jFoster426/ElectronicLoad/Simulation/BQ25303 Thermistor Resistor Calculations.docx

BQ25303 Thermistor Resistor Calculations:

T=1/(1/(T_0)+1/βln(R/(R_0)))

T_0 =298.15 °C

β=3380 K

R_0 =10 kΩ

1/T=1/(T_0)+1/βln(R/(R_0))

β(1/T-1/(T_0))=ln(R/(R_0))

R=R_0 exp(β(1/T-1/(T_0)))

Calculate resistance at T_1 and T_5 ( 0 °C and 60 °C , 273.15 °K and 333.15 °K ):

R_(NTC,T1) =10000exp(3380(1/273.15-1/298.15))

R_(NTC,T1) =28.223 kΩ

R_(NTC,T5) =10000exp(3380(1/333.15-1/298.15))

R_(NTC,T5) =3.0392 kΩ

Calculate values for R_(T1) and R_(T2) :

R_(T2) =(R_(NTC,T1) ×R_(NTC,T5) ×(1/(V_(T5) %)-1/(V_(T1) %)))/(R_(NTC,T1) ×(1/(V_(T1) %)-1)-R_(NTC,T5) ×(1/(V_(T5) %)-1))

V_(T1) %=73.5 %

V_(T5) %=37.75 %

R_(T2) =(3.0392×28.223×(1/37.75-1/73.5))/(28.223×(1/73.5-1)-3.0392(1/37.75-1))

R_(T2) =21.401 kΩ

R_(T1) =(1/(V_(T1) %)-1)/(1/(R_(T2))+1/(R_(NTC,T1)))

R_(T1) =(1/0.735-1)/(1/21401+1/28223)

R_(T1) =4.3884 kΩ

The actual values chosen are:

R_(T1) =4.42 kΩ

R_(T2) =21.5 kΩ

TODO: Calculate T1 and T5 based on actual values.
