jFoster426/ElectronicLoad/Main PCB/Project Outputs for Electronic Load/BOM/BOM-Electronic Load.xlsx

Comment | Designator | Footprint | Quantity | Fitted | Manufacturer 1 | Manufacturer 1 Part Number
10uF,20%,50V,X5R,1206 | C2, C55, C56, C57, C60, C63, C66, C67, C68, C69, C70, C72, C73, C74, C77 | CAPC3216X16N | 15 | Fitted | Samsung Electro-Mechanics | CL31A106MBHNNNE | LCSC
100nF,10%,50V,X7R,0402 | C7, C8, C9, C10, C15_ICC1, C15_ICC2, C15_ICC3, C15_ICC4, C15_ICC5, C15_ICC6, C15_ICC7, C15_ICC8, C16_ICC1, C16_ICC2, C16_ICC3, C16_ICC4, C16_ICC5, C16_ICC6, C16_ICC7, C16_ICC8, C19_PT1, C19_PT2, C19_PT3, C19_PT4, C19_PT5, C19_PT6, C19_PT7, C19_PT8, C20_PT1, C20_PT2, C20_PT3, C20_PT4, C20_PT5, C20_PT6, C20_PT7, C20_PT8, C39, C49, C50, C79, C80, C81, C82, C83 | CAPC1005X06N | 44 | Fitted | Murata | GRM155R71H104KE14D | Parts Bin
10nF,10%,25V,X7R,0402 | C14_ICC1, C14_ICC2, C14_ICC3, C14_ICC4, C14_ICC5, C14_ICC6, C14_ICC7, C14_ICC8, C17_ICC1, C17_ICC2, C17_ICC3, C17_ICC4, C17_ICC5, C17_ICC6, C17_ICC7, C17_ICC8, C59 | CAPC1005X06N | 17 | Fitted | Murata Electronics | GCM155R71E103KA37D | Kardium
1uF,10%,35V,X7R,0402 | C21, C22, C23, C24, C26, C27, C28, C29, C30, C31, C32, C33, C34, C53, C58, C61, C62, C64, C71, C76 | CAPC1005X06N | 20 | Fitted | TDK Corporation | C1005X5R1V105K050BC
5.1pF,+-0.1pF,50V,C0G,0402 | C35, C36 | CAPC1005X06N | 2 | Fitted | Murata | GJM1555C1H5R1BB01D
6.8pF,+-0.1pF,50V,C0G,0402 | C37, C38 | CAPC1005X06N | 2 | Fitted | Murata | GJM1555C1H6R8BB01D
47nF,10%,50V,X7R,0402 | C65 | CAPC1005X06N | 1 | Fitted | YAGEO | CC0402KRX7R9BB473
PMEG6002EB-QX | D1, D2, D14, D15, D16, D17 | NEXPERIA_PKG_SOD523 | 6 | Fitted | Nexperia USA Inc. | PMEG6002EB-QX
1N4148WT | D3, D12, D30, D31 | ONSEMI_PKG_SOD-523F | 4 | Fitted | onsemi | 1N4148WT
Red | D4, D29 | LITE-ON_LTST-C190KRKT | 2 | Fitted | Lite-On Inc. | LTST-C190KRKT
Yellow | D5 | LITE-ON_LTST-C190KSKT | 1 | Fitted | Lite-On Inc. | LTST-C190KSKT
Green | D6 | LITE-ON_LTST-C190KGKT | 1 | Fitted | Lite-On Inc. | LTST-C190KGKT
BAT54SLT1G | D7, D8, D11_C1, D11_C2, D11_C3, D11_C4, D11_C5, D11_C6, D11_C7, D11_C8, D11_C9, D11_C10 | SOT95P240X120-3N | 12 | Fitted | onsemi | BAT54SLT1G
PMEG2010AEBF | D13 | NEXPERIA_PKG_SOD523 | 1 | Fitted | Nexperia USA Inc. | PMEG2010AEBF
ESDSLC5V0LB-TP | D18, D19 | MICROCOMMERCIAL_DFN1006-2_NPOL | 2 | Fitted | Micro Commercial Co | ESDSLC5V0LB-TP
ESDSLC3V3LB-TP | D20, D21, D22, D23, D24, D25, D26, D27, D28 | DFN65P100X50-2N | 9 | Fitted | Micro Commercial Co | ESDSLC3V3LB-TP
600R,0603 | FB1, FB2, FB3, FB4, FB5 | INDC_0603 | 5 | Fitted | TAI-TECH | FCM1608KF-601T03
TT56145145-1520 | J1, J2 | XFCN_TT56145145-1520 | 2 | Fitted | XFCN | TT56145145-1520
S2B-XH-A | J3 | JST_S2B-XH-A | 1 | Fitted | JST Sales America Inc. | S2B-XH-A
USB4110-GF-A | J4 | GCT_USB4110-GF-A | 1 | Fitted | GCT | USB4110-GF-A
3221-10-0300-00 | J5 | CNC Tech_3221-10-0300-00 | 1 | Fitted | CNC Tech | 3221-10-0300-00
Term,Header,6 Pin,Top,2.54mm | J6 | WURTH_61300611121 | 1 | Fitted | WÃ¼rth Elektronik | 61300611121
Term,Header,2 Pin,Top,2.54mm | J7 | WURTH_61300211121 | 1 | Fitted | WÃ¼rth Elektronik | 61300211121
PPPC082LFBN-RC | J8 | SULLINS_PPPC082LFBN-RC | 1 | Fitted | Sullins Connector Solutions | PPPC082LFBN-RC
4.7uH,4A,Wirewound,SMD | L1 | TAIYO-YUDEN_NRS8030T4R7MJGJ | 1 | Fitted | Taiyo Yuden | NRS8030T4R7MJGJ
1uH,30%,6A,Wirewound,SMD | L2 | TDK_VLS6045EX | 1 | Fitted | TDK | VLS6045EX-1R0N
DMP3099L-7 | Q1, Q2 | DIODES_SOT23 | 2 | Fitted | Diodes Incorporated | DMP3099L-7
GBS65041TOB | Q4_PT1, Q4_PT2, Q4_PT3, Q4_PT4, Q4_PT5, Q4_PT6, Q4_PT7, Q4_PT8 | GOSEMICON_PKG_TO-247 | 8 | Fitted | GOSEMICON | GBS65041TOB
MMBT2222AT-7-F | Q5, Q6, Q7, Q9, Q11 | SOTFL50P160X90-3N | 5 | Fitted | Diodes Incorporated | MMBT2222AT-7-F
MMBT4403T-7-F | Q8 | DIODES_SOT523 | 1 | Fitted | Diodes Incorporated | MMBT4403T-7-F
FDY102PZ | Q10 | ONSEMI_SC-89 | 1 | Fitted | onsemi | FDY102PZ
0R0,0402 | R1_ICC1, R1_ICC2, R1_ICC3, R1_ICC4, R1_ICC5, R1_ICC6, R1_ICC7, R1_ICC8, R84, R113, R116, R122, R172, R182 | RESC1005X04N | 14 | Fitted | Panasonic Electronic Components | ERJ-2GE0R00X
1k,0.1%,0.063W,0402 | R3_ICC1, R3_ICC2, R3_ICC3, R3_ICC4, R3_ICC5, R3_ICC6, R3_ICC7, R3_ICC8, R4_ICC1, R4_ICC2, R4_ICC3, R4_ICC4, R4_ICC5, R4_ICC6, R4_ICC7, R4_ICC8, R7_ICC1, R7_ICC2, R7_ICC3, R7_ICC4, R7_ICC5, R7_ICC6, R7_ICC7, R7_ICC8, R8_ICC1, R8_ICC2, R8_ICC3, R8_ICC4, R8_ICC5, R8_ICC6, R8_ICC7, R8_ICC8, R11, R13, R14, R15, R17, R20, R26_ICC1, R26_ICC2, R26_ICC3, R26_ICC4, R26_ICC5, R26_ICC6, R26_ICC7, R26_ICC8, R27_ICC1, R27_ICC2, R27_ICC3, R27_ICC4, R27_ICC5, R27_ICC6, R27_ICC7, R27_ICC8, R28_ICC1, R28_ICC2, R28_ICC3, R28_ICC4, R28_ICC5, R28_ICC6, R28_ICC7, R28_ICC8, R29_ICC1, R29_ICC2, R29_ICC3, R29_ICC4, R29_ICC5, R29_ICC6, R29_ICC7, R29_ICC8, R31_ICC1, R31_ICC2, R31_ICC3, R31_ICC4, R31_ICC5, R31_ICC6, R31_ICC7, R31_ICC8, R32_ICC1, R32_ICC2, R32_ICC3, R32_ICC4, R32_ICC5, R32_ICC6, R32_ICC7, R32_ICC8, R35_ICC1, R35_ICC2, R35_ICC3, R35_ICC4, R35_ICC5, R35_ICC6, R35_ICC7, R35_ICC8, R36_ICC1, R36_ICC2, R36_ICC3, R36_ICC4, R36_ICC5, R36_ICC6, R36_ICC7, R36_ICC8, R103 | RESC1005X04N | 103 | Fitted | YAGEO | RT0402BRE071KL
0R02,1%,0.33W,1206 | R5_CS1, R5_CS2, R5_CS3, R5_CS4, R5_CS5, R5_CS6, R5_CS7, R5_CS8, R6_CS1, R6_CS2, R6_CS3, R6_CS4, R6_CS5, R6_CS6, R6_CS7, R6_CS8, R64_CS1, R64_CS2, R64_CS3, R64_CS4, R64_CS5, R64_CS6, R64_CS7, R64_CS8, R67_CS1, R67_CS2, R67_CS3, R67_CS4, R67_CS5, R67_CS6, R67_CS7, R67_CS8, R70_CS1, R70_CS2, R70_CS3, R70_CS4, R70_CS5, R70_CS6, R70_CS7, R70_CS8, R73_CS1, R73_CS2, R73_CS3, R73_CS4, R73_CS5, R73_CS6, R73_CS7, R73_CS8 | RESC3216X06N | 48 | Fitted | UNI-ROYAL | 1206W3F200MT5E
100k,1%,0.063W,0402 | R9, R117, R176, R178, R179, R181 | RESC1005X04N | 6 | Fitted | YAGEO | RC0402FR-07100KL
10k,0.1%,0.063W,0402 | R10, R12, R101 | RESC1005X04N | 3 | Fitted | Stackpole Electronics Inc | RNCF0402BTE10K0
10R,1%,0.063W,0402 | R18_PT1, R18_PT2, R18_PT3, R18_PT4, R18_PT5, R18_PT6, R18_PT7, R18_PT8, R95, R164, R168, R169, R170, R171, R173, R174, R175 | RESC1005X04N | 17 | Fitted | Panasonic Electronic Components | ERJ-2RKF10R0X
6k81,0.1%,0.063W,0402 | R19, R25_ICC1, R25_ICC2, R25_ICC3, R25_ICC4, R25_ICC5, R25_ICC6, R25_ICC7, R25_ICC8, R34_ICC1, R34_ICC2, R34_ICC3, R34_ICC4, R34_ICC5, R34_ICC6, R34_ICC7, R34_ICC8 | RESC1005X04N | 17 | Fitted | YAGEO | AT0402BRD076K81L
10k,5%,0.063W,0402 | R30_ICC1, R30_ICC2, R30_ICC3, R30_ICC4, R30_ICC5, R30_ICC6, R30_ICC7, R30_ICC8, R33_ICC1, R33_ICC2, R33_ICC3, R33_ICC4, R33_ICC5, R33_ICC6, R33_ICC7, R33_ICC8, R82_PT1, R82_PT2, R82_PT3, R82_PT4, R82_PT5, R82_PT6, R82_PT7, R82_PT8, R88, R89, R90, R91, R92, R93, R94, R119, R120, R121, R153, R154, R155, R156, R157, R158, R159, R160, R161, R162, R163, R165, R166, R167, R183, R184 | RESC1005X04N | 50 | Fitted | Stackpole Electronics Inc | RMCF0402JT10K0
0R0,1206 | R81_PT1, R81_PT2, R81_PT3, R81_PT4, R81_PT5, R81_PT6, R81_PT7, R81_PT8 | RESC3216X06N | 8 | Fitted | Stackpole Electronics Inc | RMCF1206ZT0R00
1k,5%,0.063W,0402 | R83_PT1, R83_PT2, R83_PT3, R83_PT4, R83_PT5, R83_PT6, R83_PT7, R83_PT8, R111_C1, R111_C2, R111_C3, R111_C4, R111_C5, R111_C6, R111_C7, R111_C8, R111_C9, R111_C10, R128 | RESC1005X04N | 19 | Fitted | Stackpole Electronics Inc | RMCF0402JT1K00
750R,1%,0.063W,0402 | R85 | RESC1005X04N | 1 | Fitted | UNI-ROYAL | 0402WGF7500TCE
300R,1%,0.063W,0402 | R86 | RESC1005X04N | 1 | Fitted | UNI-ROYAL | 0402WGF3000TCE
270R,1%,0.063W,0402 | R87 | RESC1005X04N | 1 | Fitted | YAGEO | RC0402FR-07270RL
442k,0.1%,0.125W,0805 | R96, R97, R98, R99, R100 | RESC2012X07N | 5 | Fitted | Panasonic Electronic Components | ERA-6AEB4423V
49R9,1%,0.063W,0402 | R112_C1, R112_C2, R112_C3, R112_C4, R112_C5, R112_C6, R112_C7, R112_C8, R112_C9, R112_C10, R131, R133, R134, R135, R137, R139, R141, R143, R145, R147, R149, R151 | RESC1005X04N | 22 | Fitted | YAGEO | RC0402FR-0749R9L
4k42,1%,0.063W,0402 | R114 | RESC1005X04N | 1 | Fitted | FOJAN | FRC0402F4421TS
13k2,1%,0.063W,0402 | R115 | RESC1005X04N | 1 | Fitted | KOA Speer Electronics, Inc. | RN73H1ETTP1322F25
21k5,1%,0.063W,0402 | R118 | RESC1005X04N | 1 | Fitted | FOJAN | FRC0402F2152TS
1k62,1%,0.063W,0402 | R123 | RESC1005X04N | 1 | Fitted | YAGEO | RC0402FR-071K62L
NTC,10k,3380K,0603 | R124 | RESC_0603 | 1 | Fitted | Murata | NCP18XH103F03RB
330R,1%,0.063W,0402 | R125, R127 | RESC1005X04N | 2 | Fitted | YAGEO | RC0402FR-07330RL
3k6,1%,0.063W,0402 | R126 | RESC1005X04N | 1 | Fitted | FOJAN | FRC0402F3601TS
5k11,1%,0.063W,0402 | R129, R130 | RESC1005X04N | 2 | Fitted | Yageo | AC0402FR-075K11L
100R,1%,0.25W,1206 | R132, R185 | SEI_PKG_RMCF1206 | 2 | Fitted | Stackpole Electronics Inc | RMCF1206FT100R
10k,25T | R136 | BOURNS_3296W | 1 | Fitted | Bourns | 3296W-1-103LF
750k,1%,0.063W,0402 | R177 | RESC1005X04N | 1 | Fitted | YAGEO | RC0402FR-07750KL
PTS525SM15SMTR2 LFS | SW1, SW11 | C&K_PTS525SM15SMTR2 LFS | 2 | Fitted | C&K | PTS525SM15SMTR2 LFS
1825027-6 | SW2 | TE_1825027-6 | 1 | Fitted | TE Connectivity | 1825027-6
PTS645SK43SMTR92 LFS | SW3, SW4, SW5, SW6, SW7, SW8, SW9, SW10 | C&K_PTS645SK43SMTR92 LFS | 8 | Fitted | C&K | PTS645SK43SMTR92 LFS
750317722 | T1 | WURTH_750317722 | 1 | Fitted | Wurth Elektronik | 750317722
LM317EMPX/NOPB | U1 | TEXASINSTRUMENTS_PKG_DCY | 1 | Fitted | Texas Instruments | LM317EMPX/NOPB
LM337IMPX/NOPB | U2 | TEXASINSTRUMENTS_PKG_DCY | 1 | Fitted | Texas Instruments | LM337IMPX/NOPB
OPA2209AIDR | U3_ICC1, U3_ICC2, U3_ICC3, U3_ICC4, U3_ICC5, U3_ICC6, U3_ICC7, U3_ICC8, U8, U9 | TEXASINSTRUMENTS_PKG_D0008A | 10 | Fitted | Texas Instruments | OPA2209AIDR
MCP9701-E/TO | U4_PT1, U4_PT2, U4_PT3, U4_PT4, U4_PT5, U4_PT6, U4_PT7, U4_PT8 | TO-92 | 8 | Fitted | Microchip Technology | MCP9701-E/TO
DAC8830ID | U5 | TEXASINSTRUMENTS_PKG_D0008A | 1 | Fitted | Texas Instruments | DAC8830ID
REF3030AIDBZR | U6 | SOT95P237X112-3N | 1 | Fitted | Texas Instruments | REF3030AIDBZR
STM32G474VET6 | U7 | STMICROELECTRONICS_PKG_LQFP100 | 1 | Fitted | ST Microelectronics | STM32G474VET6
BQ25303JRTER | U10 | TEXASINSTRUMENTS_PKG_RTE0016C | 1 | Fitted | Texas Instruments | BQ25303JRTER
TPS79333DBVR | U11 | TEXASINSTRUMENTS_PKG_DBV0005A | 1 | Fitted | Texas Instruments | TPS79333DBVR
PAM2401SCADJ | U12 | DIODES_PKG_MSOP-8 | 1 | Fitted | Diodes Incorporated | PAM2401SCADJ
SN6505BDBVR | U14 | TEXASINSTRUMENTS_PKG_DBV0006A | 1 | Fitted | Texas Instruments | SN6505BDBVR
TPD4E05U06DQAR | U16 | TEXASINSTRUMENTS_PKG_DQA0009A | 1 | Fitted | Texas Instruments | TPD4E05U06DQAR
TXU0104PWR | U18 | SOP65P640X120-14N | 1 | Fitted | Texas Instruments | TXU0104PWR
TXB0108PWR | U19 | TEXASINSTRUMENTS_PKG_PW0020A | 1 | Fitted | Texas Instruments | TXB0108PWR
24MHz,8pF | Y1 | NDK_NX2016SA | 1 | Fitted | NDK | NX2016SA-24MHZ-STD-CZS-2
32.768kHz,12.5pF | Y2 | EPSON_FC-135 | 1 | Fitted | EPSON | Q13FC13500004
