jFoster426/ElectronicLoad/Mechanical/Bracket.SLDPRT

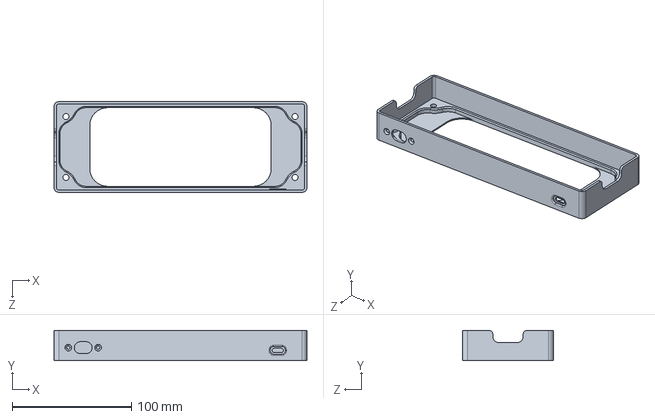
[picture p1: CAD file, 2026-03-18]
Mechanical/Bracket.SLDPRT
212.0 x 25.2 x 76.0 mm
