jFoster426/ElectronicLoad/Mechanical/JLCMC/EDLW-S1-M2.5-L6.sldprt

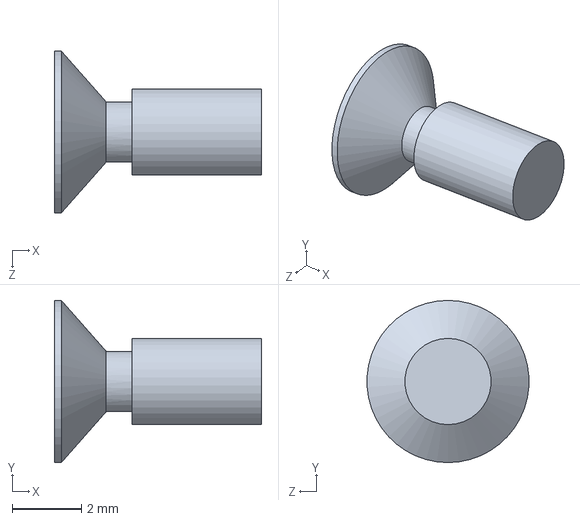
[picture p2: CAD file, 2026-03-04]
Mechanical/JLCMC/EDLW-S1-M2.5-L6.sldprt
6.00 x 4.70 x 4.69 mm
