jFoster426/ElectronicLoad/Mechanical/PCB/LCD PCB.SLDPRT

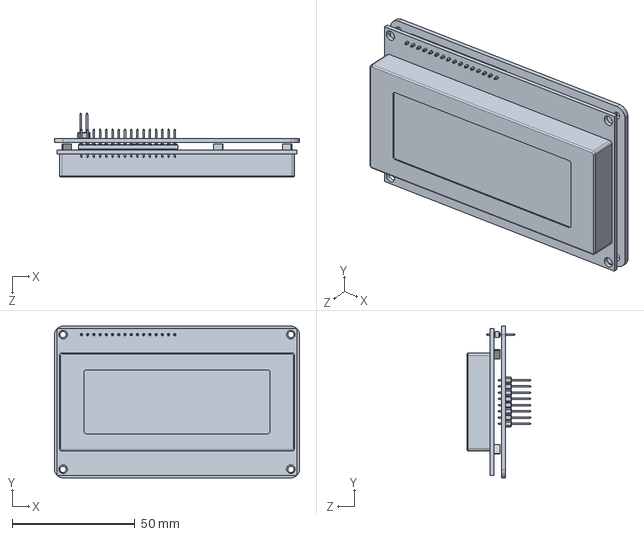
[picture p3: CAD file, 2026-02-09]
Mechanical/PCB/LCD PCB.SLDPRT
100.0 x 62.0 x 26.2 mm
