jFoster426/ElectronicLoad/Mechanical/JLCMC/EDLW-S1-M2.5-L12.sldprt

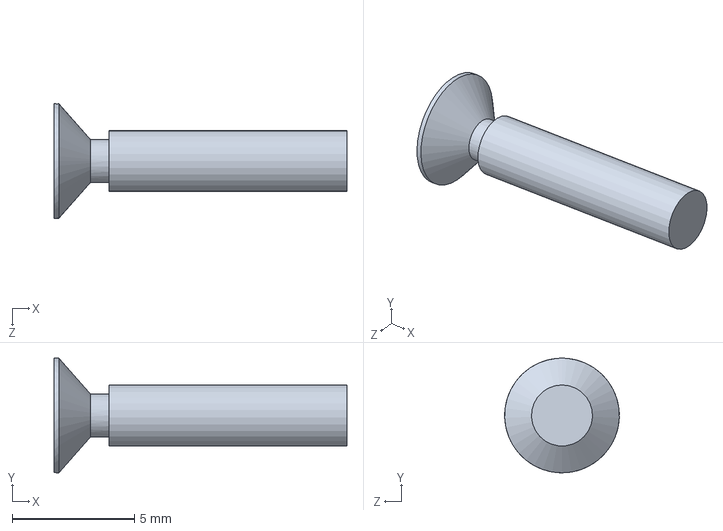
[picture p4: CAD file, 2026-03-04]
Mechanical/JLCMC/EDLW-S1-M2.5-L12.sldprt
12.0 x 4.70 x 4.70 mm
