jFoster426/ElectronicLoad/Mechanical/Top Cover.SLDPRT

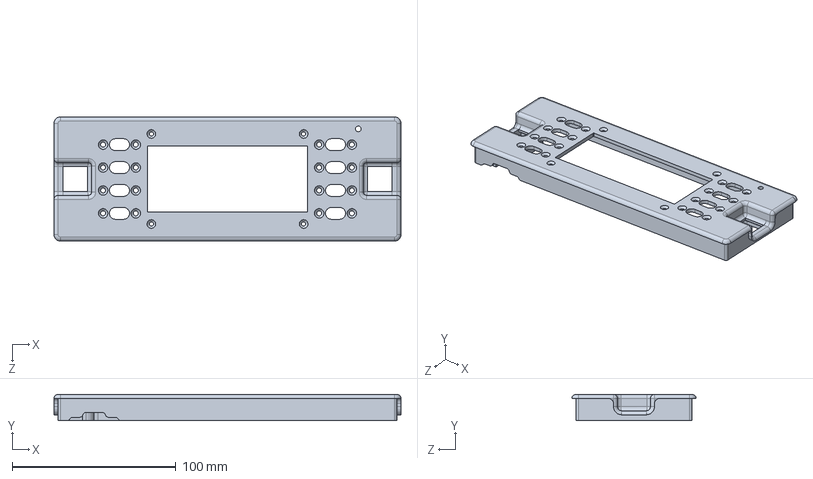
[picture p5: CAD file, 2026-03-18]
Mechanical/Top Cover.SLDPRT
212.0 x 16.0 x 76.0 mm
