jFoster426/ElectronicLoad/Mechanical/JLCMC/ECSA-P51-M3-L16.sldprt

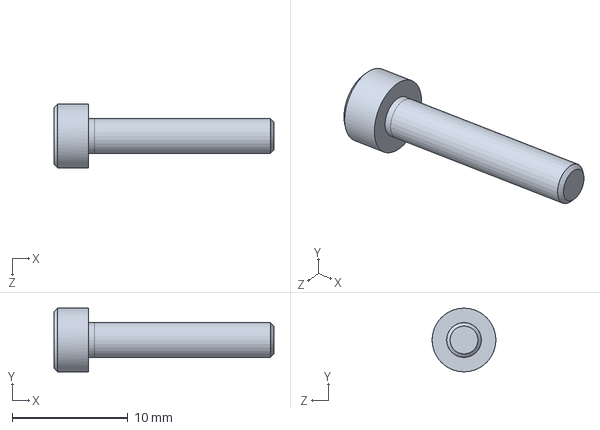
[picture p6: CAD file, 2026-03-04]
Mechanical/JLCMC/ECSA-P51-M3-L16.sldprt
19.0 x 5.50 x 5.50 mm
