jFoster426/ElectronicLoad/Mechanical/LCD Spacer.SLDPRT

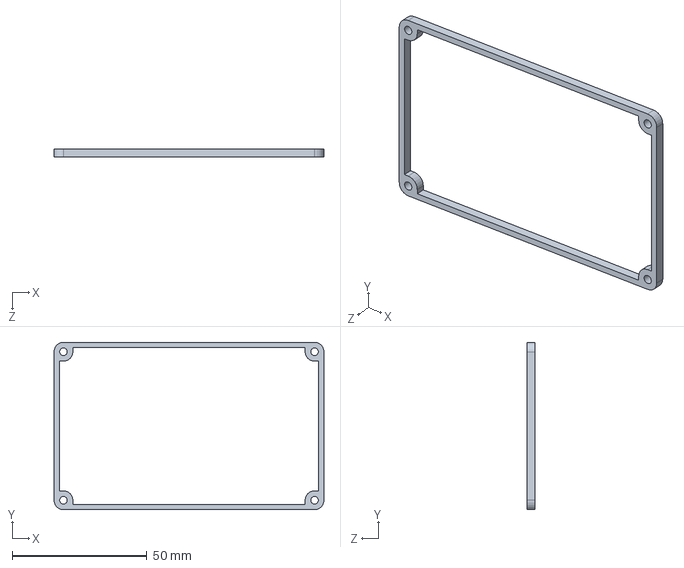
[picture p7: CAD file, 2026-03-04]
Mechanical/LCD Spacer.SLDPRT
100.0 x 62.0 x 3.00 mm
