jFoster426/ElectronicLoad/Mechanical/Insulator 2.SLDPRT

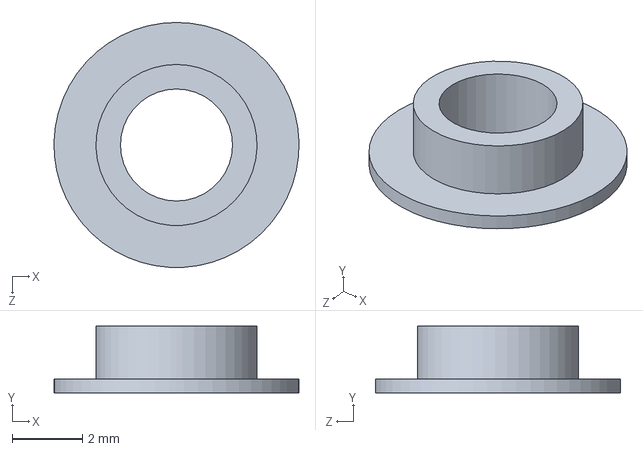
[picture p8: CAD file, 2026-03-04]
Mechanical/Insulator 2.SLDPRT
7.00 x 1.90 x 7.00 mm
