jFoster426/ElectronicLoad/Mechanical/JLCMC/EMLA-S1W-B1L1-M2.5.sldprt

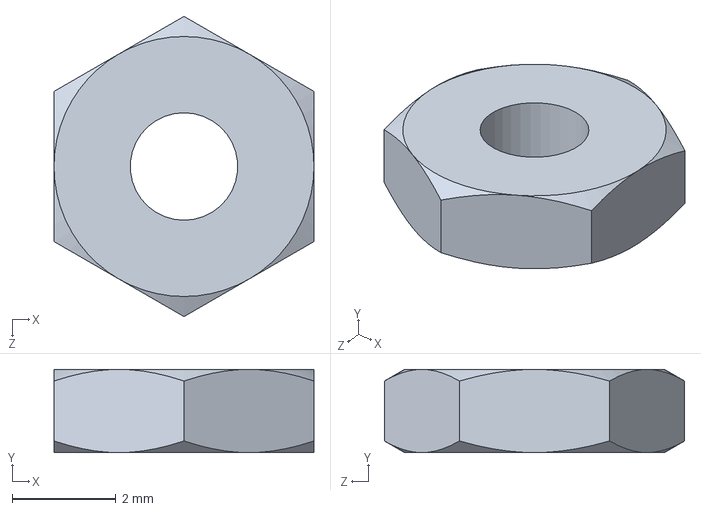
[picture p9: CAD file, 2026-03-04]
Mechanical/JLCMC/EMLA-S1W-B1L1-M2.5.sldprt
5.00 x 1.60 x 5.77 mm
