jFoster426/ElectronicLoad/Mechanical/JLCMC/ECSA-P51-M3-L20.sldprt

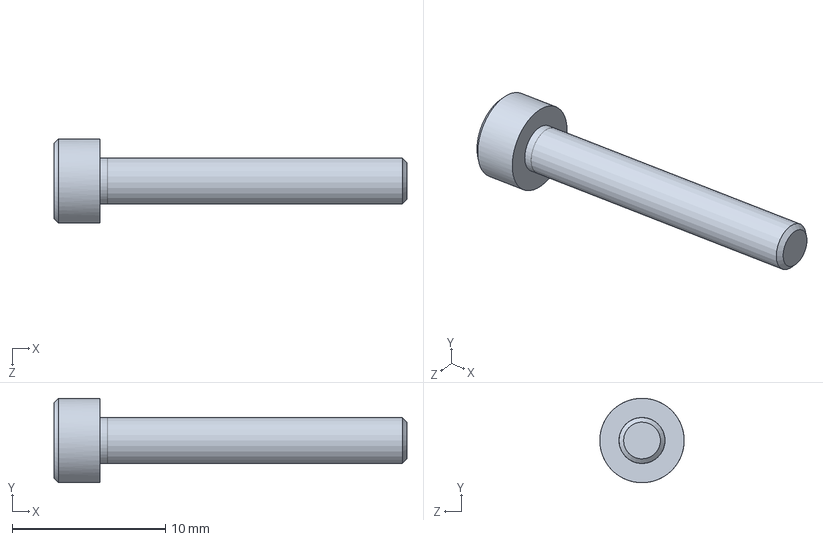
[picture p10: CAD file, 2026-03-04]
Mechanical/JLCMC/ECSA-P51-M3-L20.sldprt
23.0 x 5.50 x 5.50 mm
