jFoster426/ElectronicLoad/Mechanical/Transistor Clamp.SLDPRT

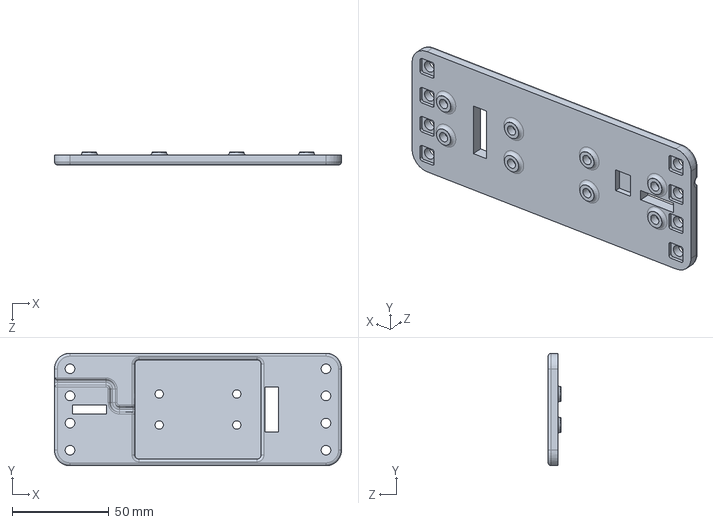
[picture p11: CAD file, 2026-03-04]
Mechanical/Transistor Clamp.SLDPRT
148.0 x 58.0 x 6.60 mm
