jFoster426/ElectronicLoad/Mechanical/Insulator.SLDPRT

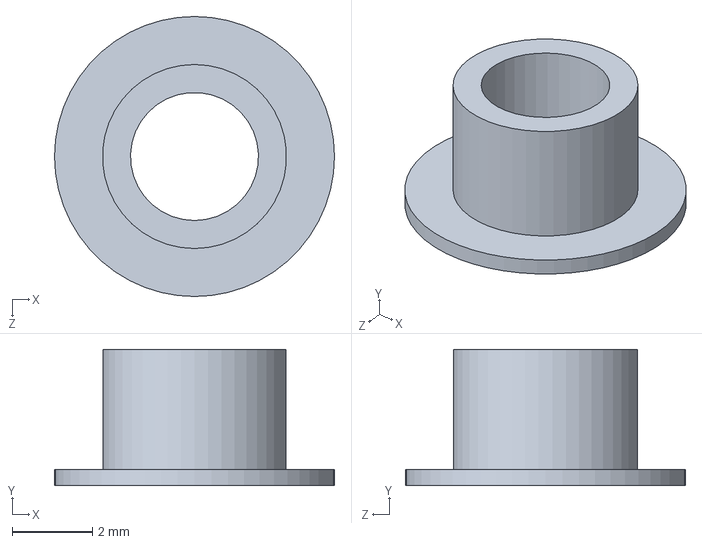
[picture p12: CAD file, 2026-03-02]
Mechanical/Insulator.SLDPRT
7.00 x 3.40 x 7.00 mm
