jFoster426/ElectronicLoad/Mechanical/Buttons.SLDPRT

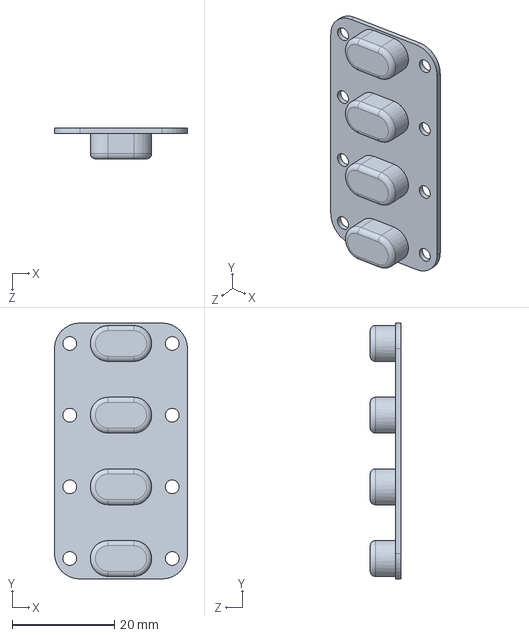
[picture p13: CAD file, 2026-03-02]
Mechanical/Buttons.SLDPRT
26.0 x 50.0 x 6.00 mm
