jFoster426/ElectronicLoad/Mechanical/Heatsink.SLDPRT

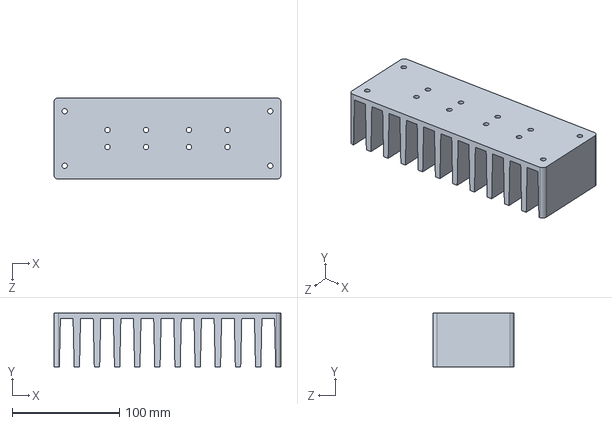
[picture p14: CAD file, 2026-02-09]
Mechanical/Heatsink.SLDPRT
212.0 x 50.0 x 76.0 mm
