jFoster426/ElectronicLoad/Mechanical/Button Spacer.SLDPRT

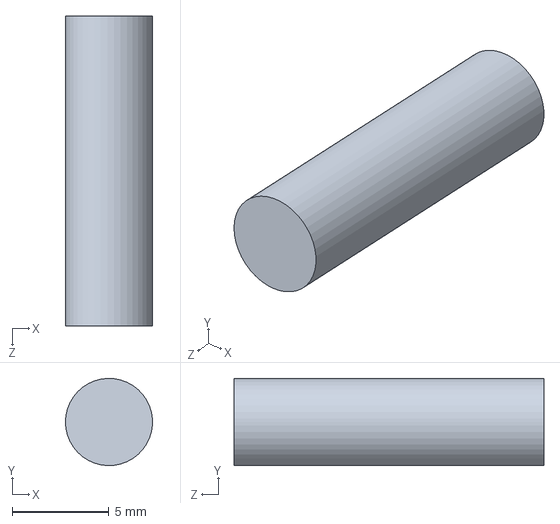
[picture p15: CAD file, 2026-02-09]
Mechanical/Button Spacer.SLDPRT
4.50 x 4.50 x 16.0 mm
