jFoster426/ElectronicLoad/Mechanical/LIPO785060.SLDPRT

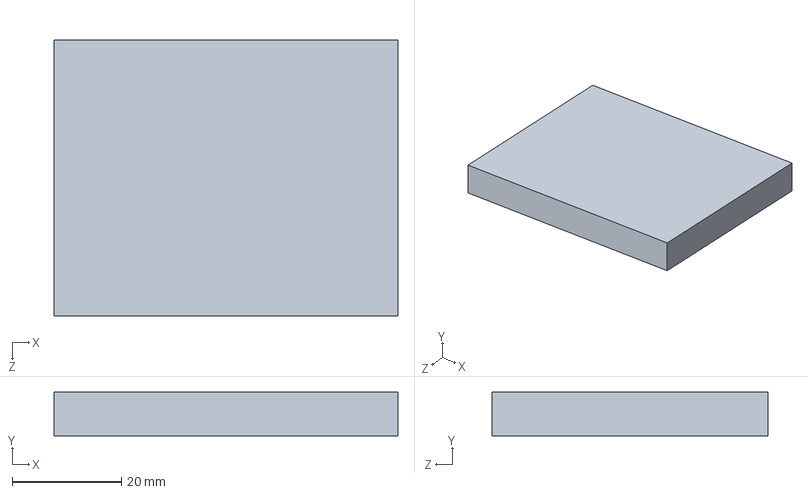
[picture p16: CAD file, 2026-02-07]
Mechanical/LIPO785060.SLDPRT
63.0 x 8.00 x 50.5 mm
