jFoster426/ElectronicLoad/Mechanical/Power Button.SLDPRT

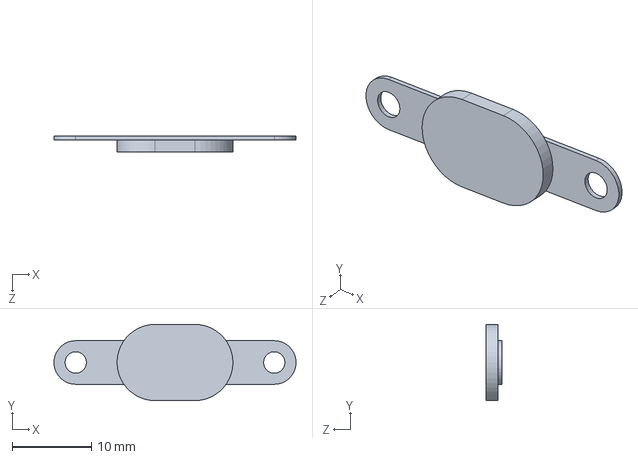
[picture p17: CAD file, 2026-02-07]
Mechanical/Power Button.SLDPRT
30.5 x 9.60 x 2.00 mm
