jFoster426/ElectronicLoad/(list of files, cad)

Other CAD files:
Mechanical/PCB/LCD PCB.x_t
