jFoster426/ElectronicLoad/Main PCB/Electronic Load.pdf

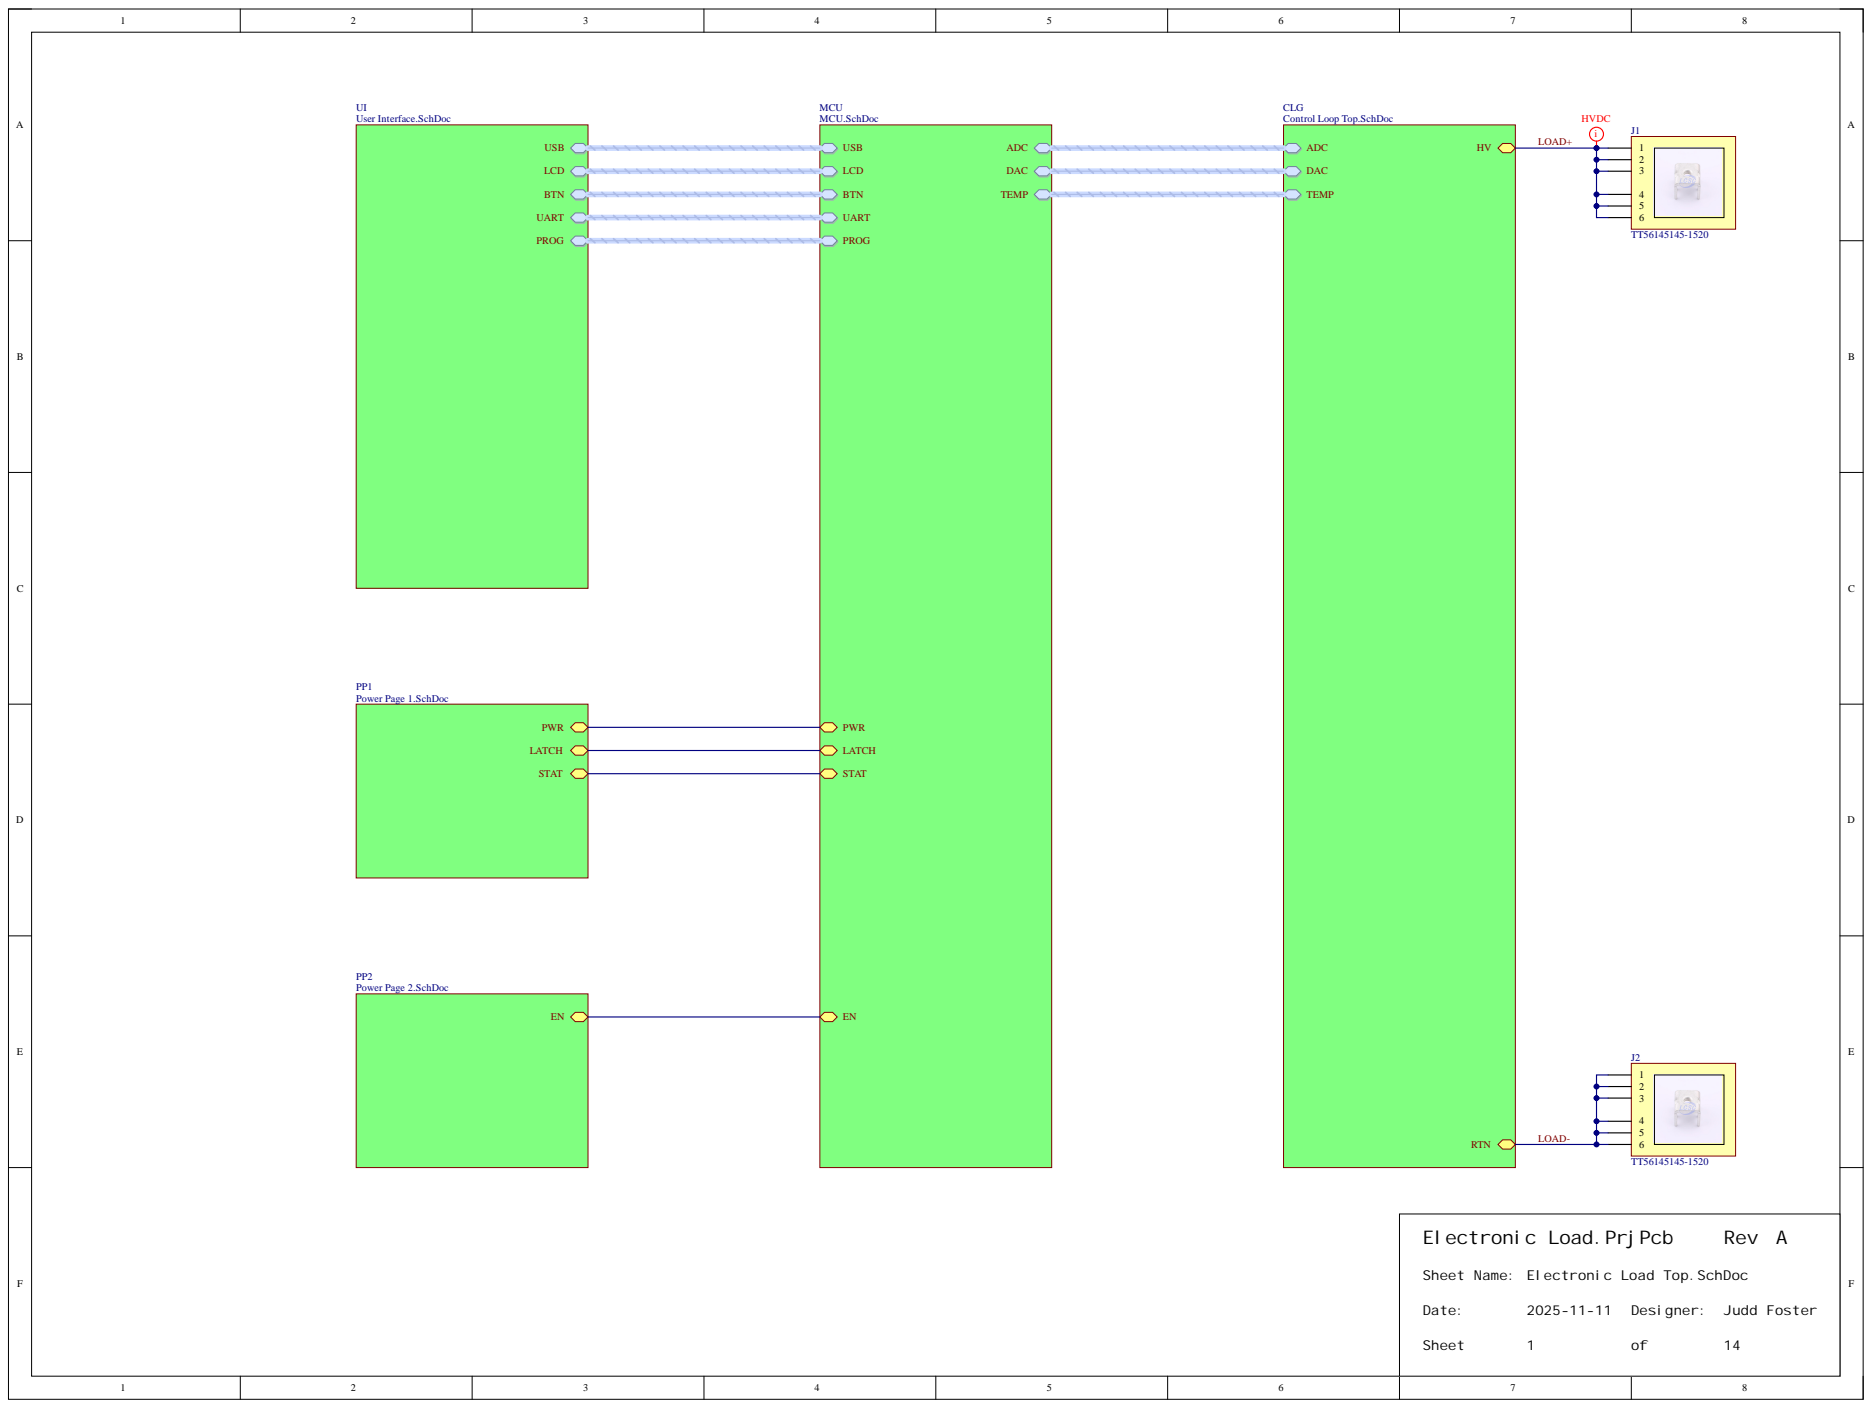
[picture p18: page 1]

CLG
Control Loop Top.SchDoc

Sheet Name: Electronic Load Top.SchDoc

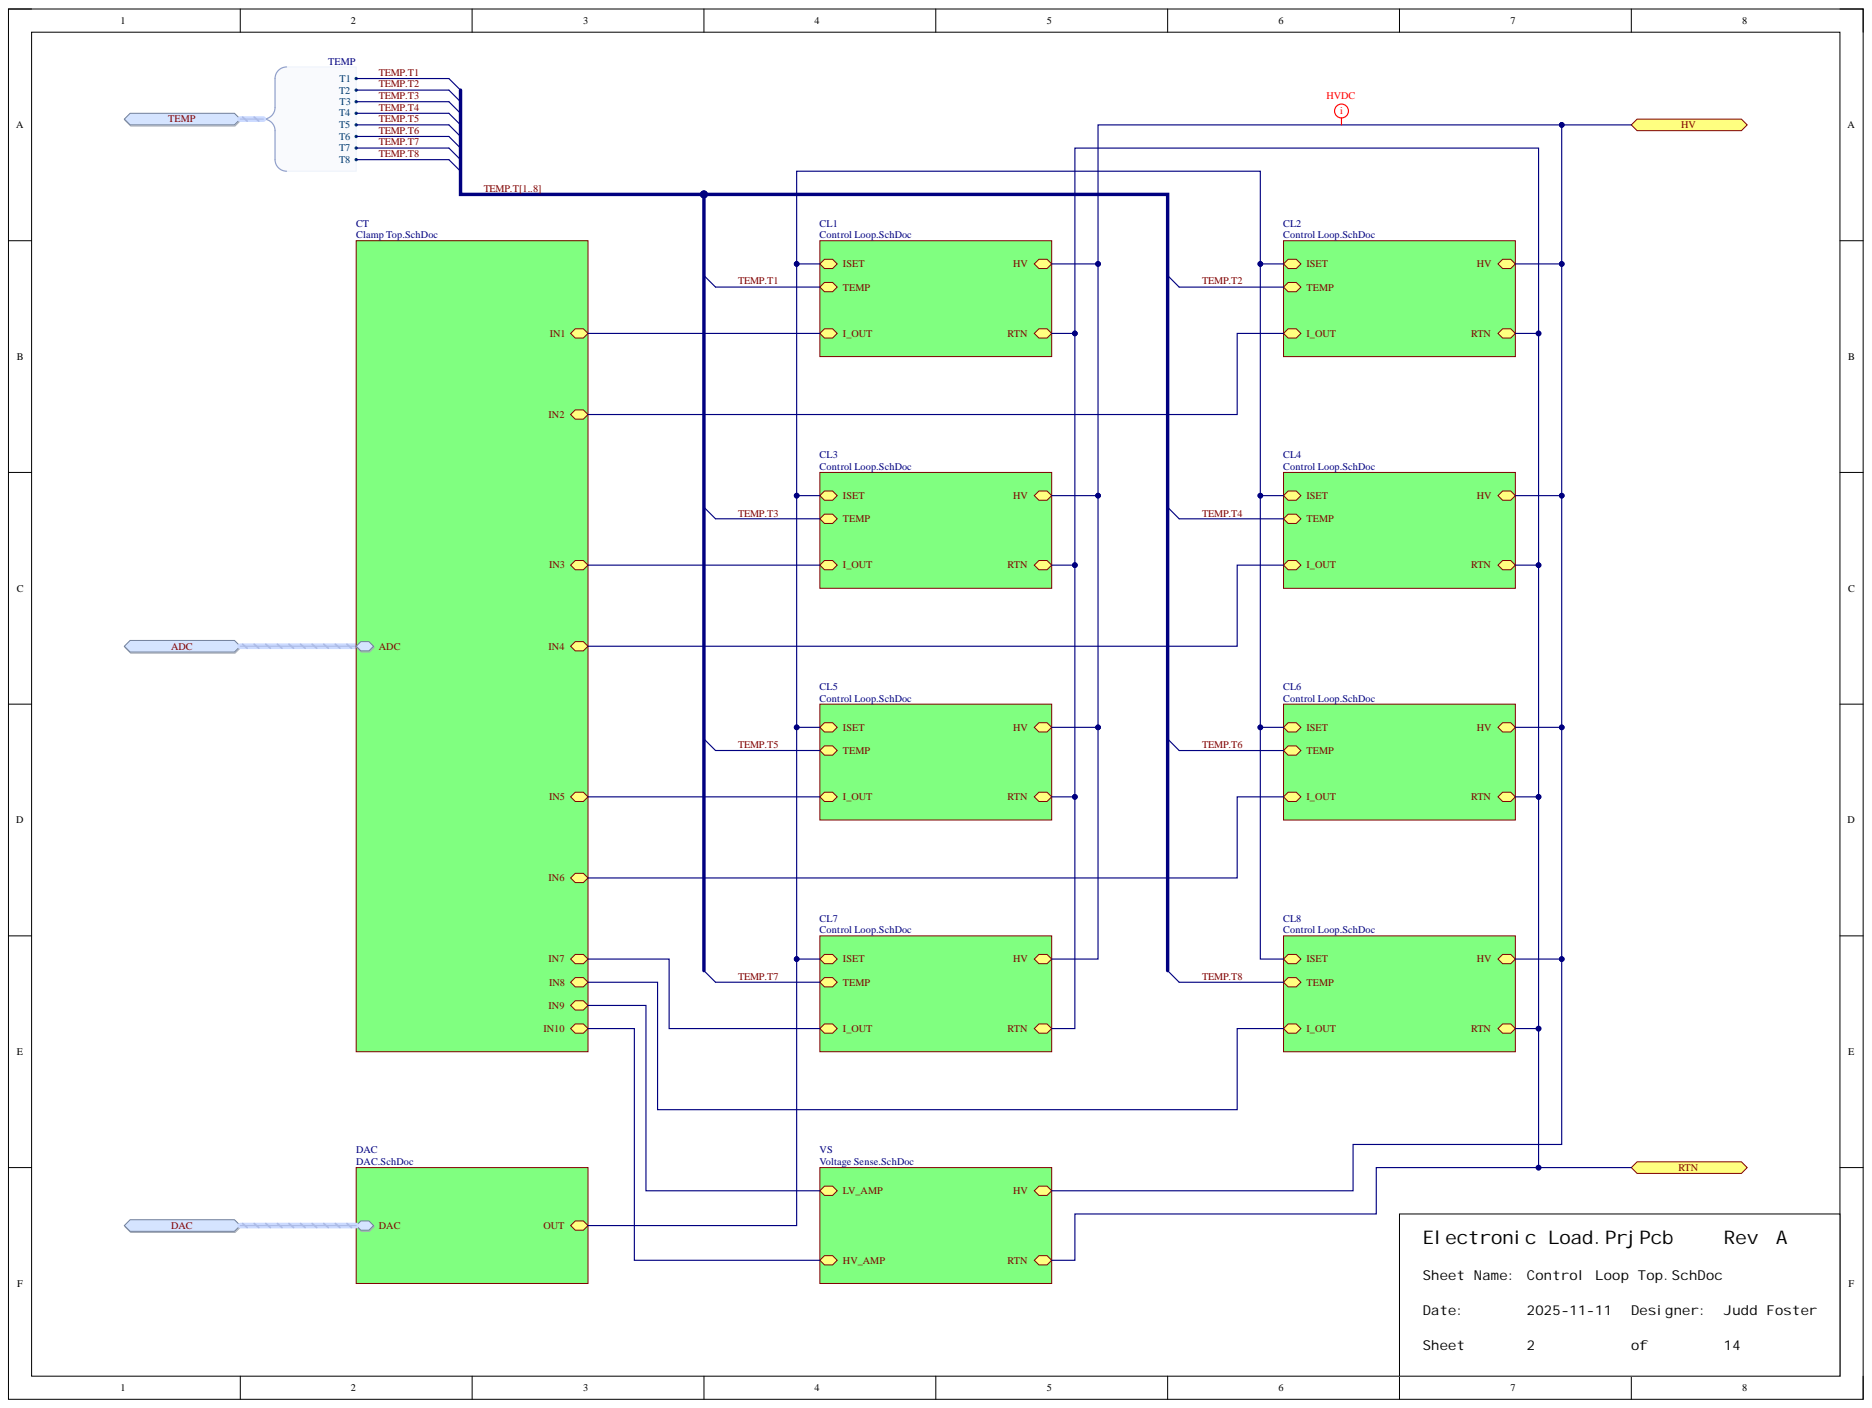
[picture p19: page 2]

Sheet Name: Control Loop Top.SchDoc

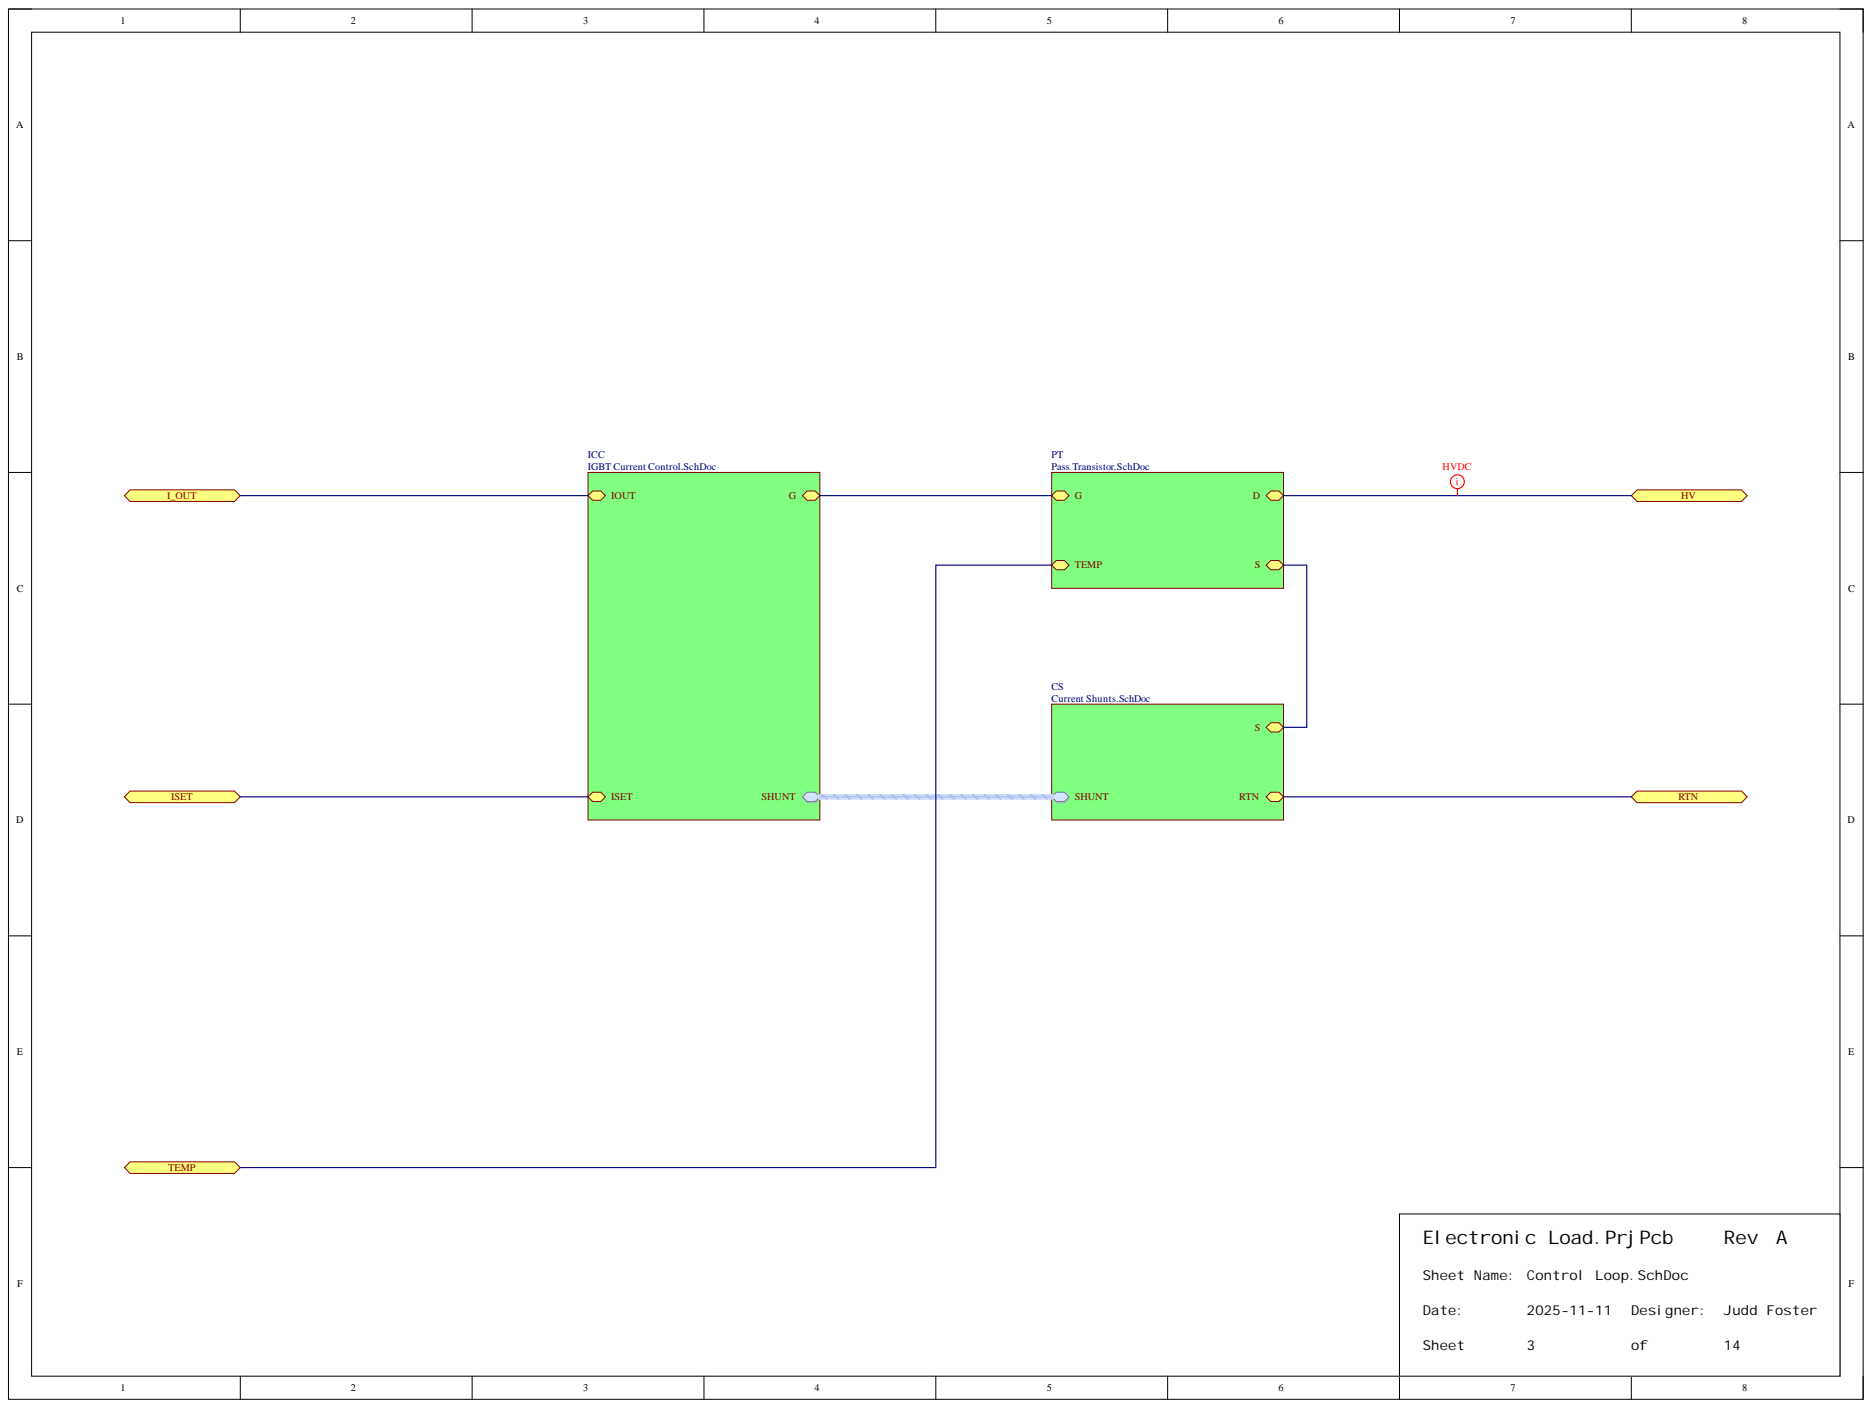
[picture p20: page 3]

ICC
IGBT Current Control.SchDoc

Sheet Name: Control Loop.SchDoc

ICC
IGBT Current Control.SchDoc

Sheet Name: Control Loop.SchDoc

ICC
IGBT Current Control.SchDoc

Sheet Name: Control Loop.SchDoc

ICC
IGBT Current Control.SchDoc

Sheet Name: Control Loop.SchDoc

ICC
IGBT Current Control.SchDoc

Sheet Name: Control Loop.SchDoc

ICC
IGBT Current Control.SchDoc

Sheet Name: Control Loop.SchDoc

ICC
IGBT Current Control.SchDoc

Sheet Name: Control Loop.SchDoc

ICC
IGBT Current Control.SchDoc

Sheet Name: Control Loop.SchDoc

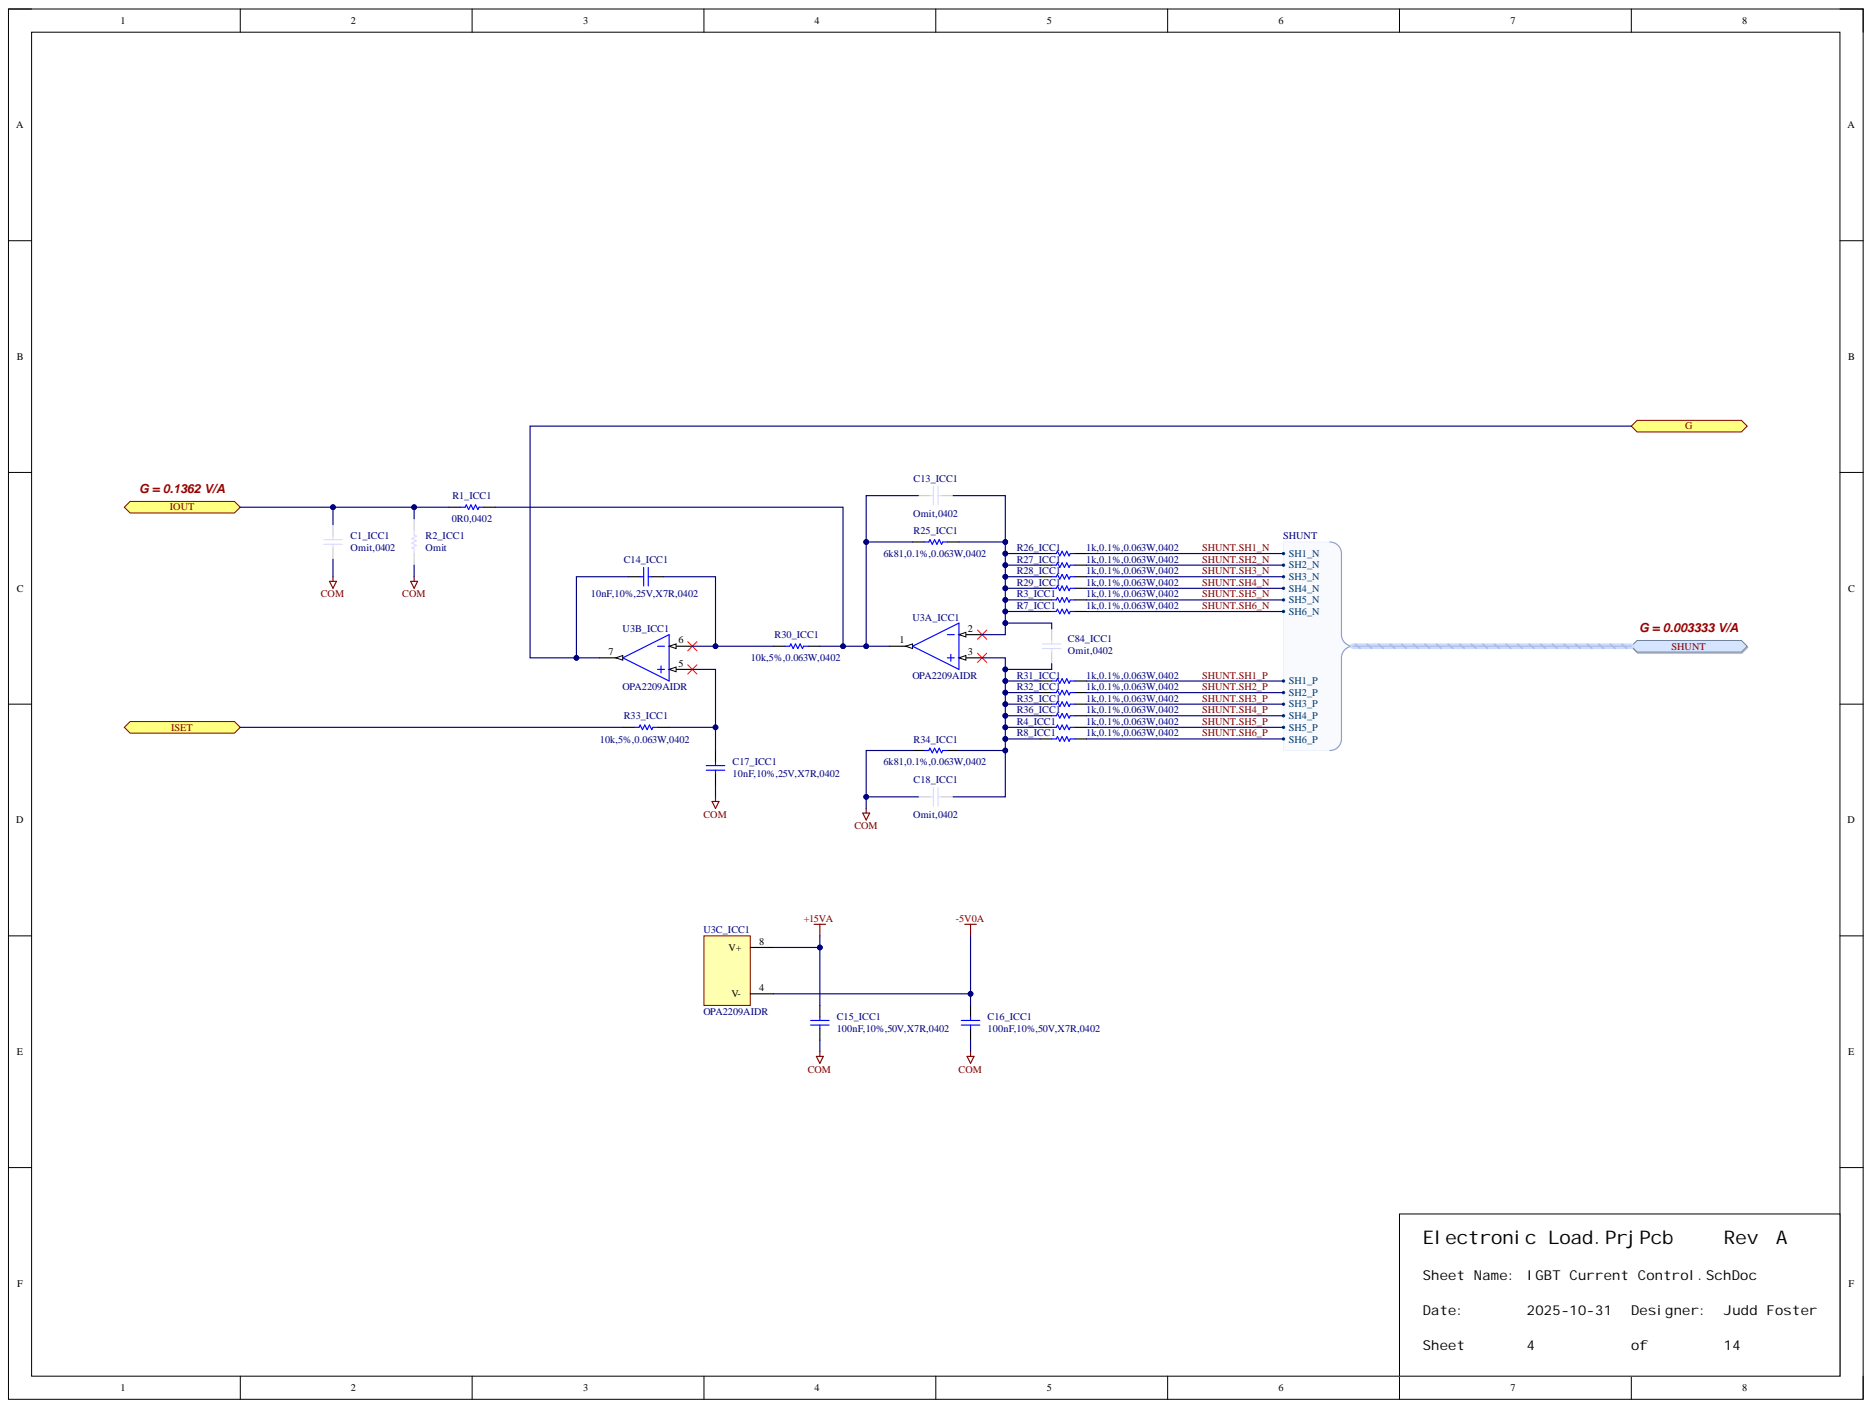
[picture p21: page 11]

C13_ICC1

Sheet Name: IGBT Current Control.SchDoc

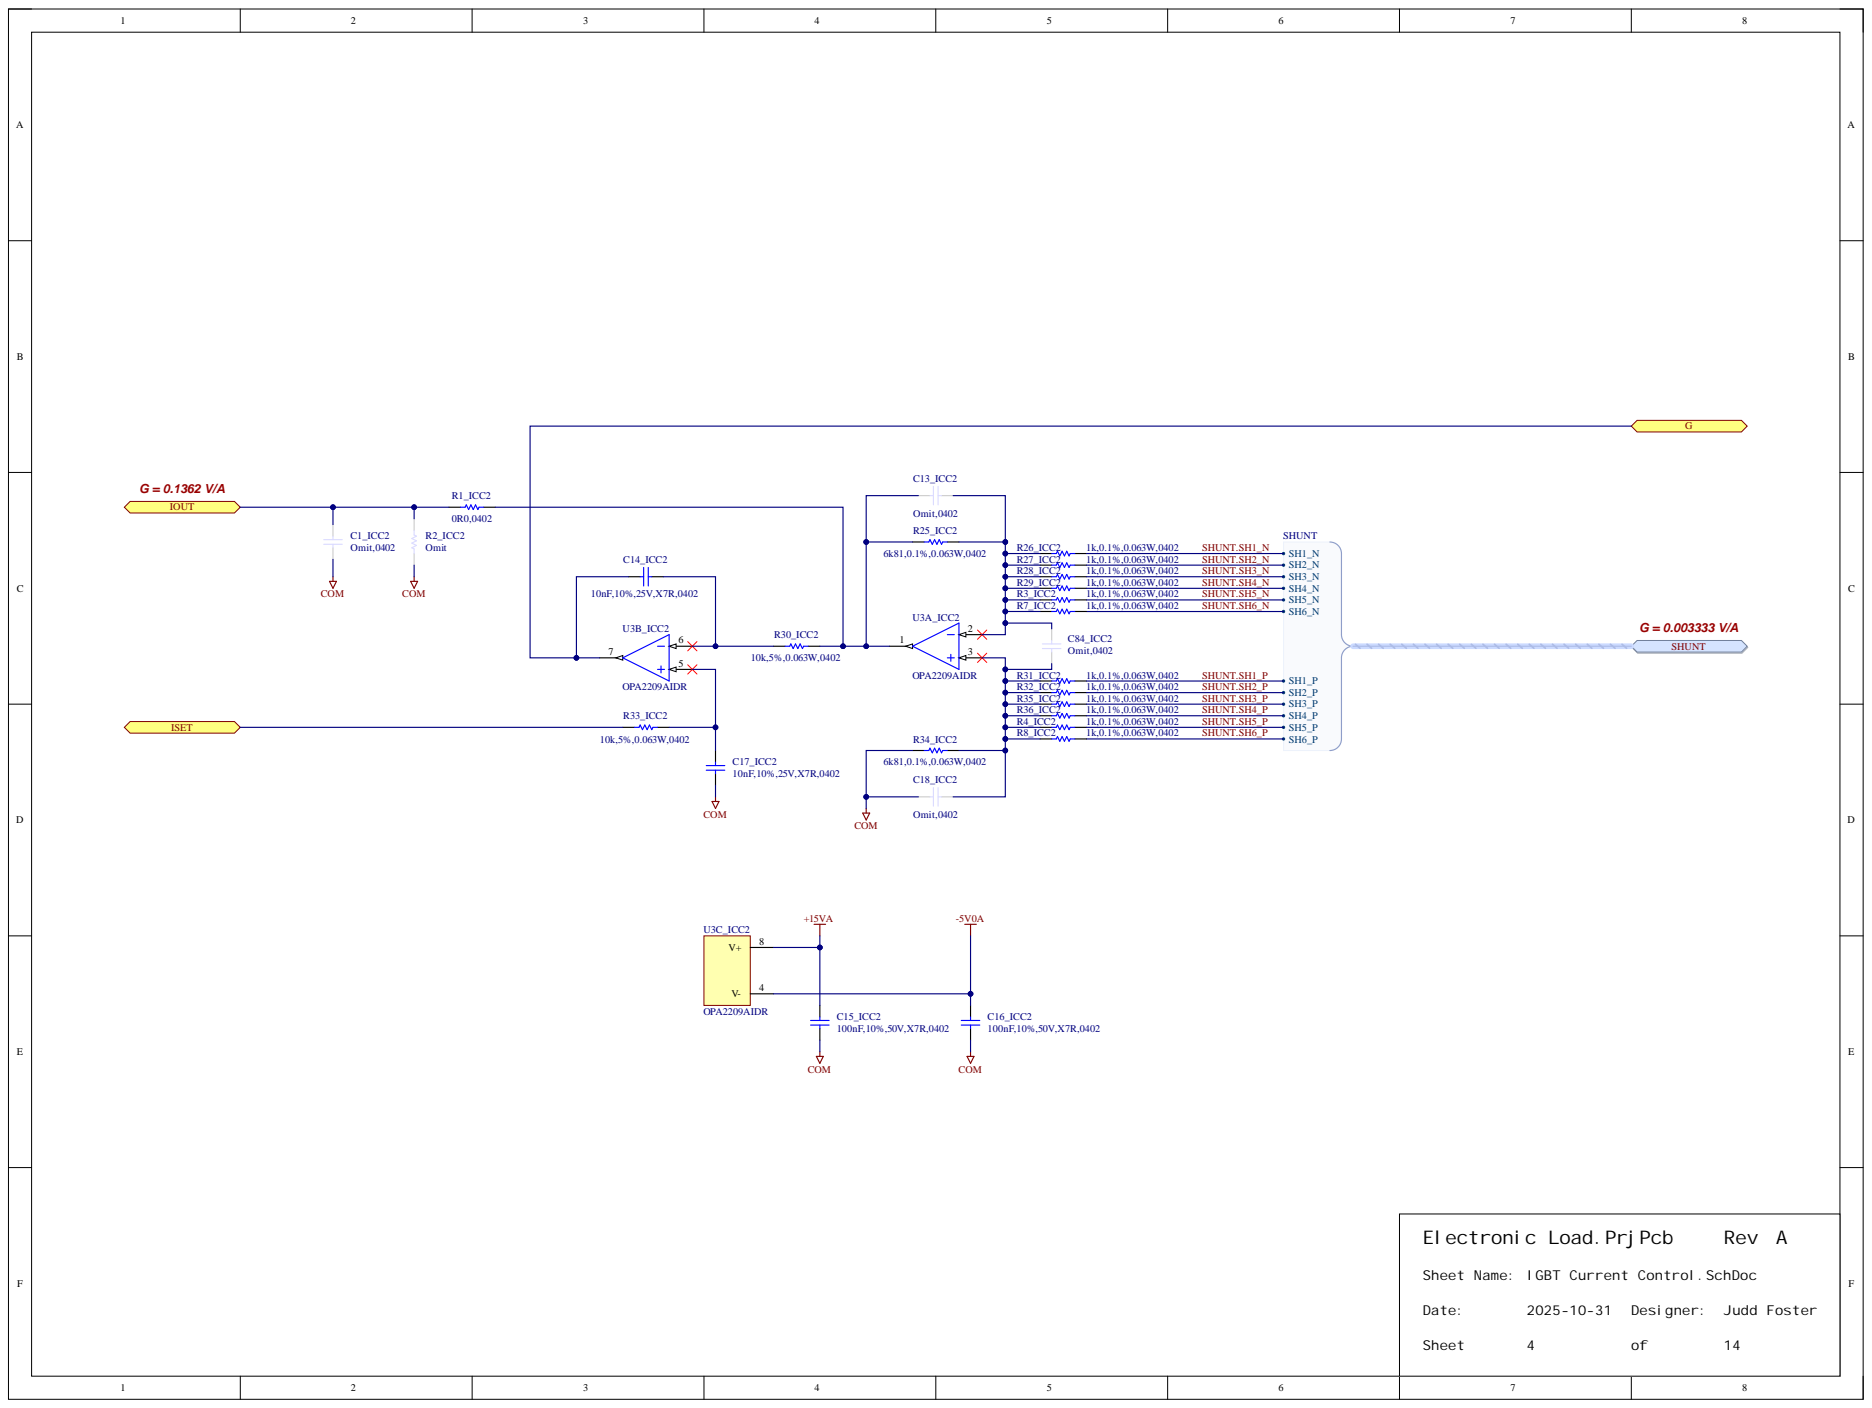
[picture p22: page 12]

C13_ICC2

Sheet Name: IGBT Current Control.SchDoc

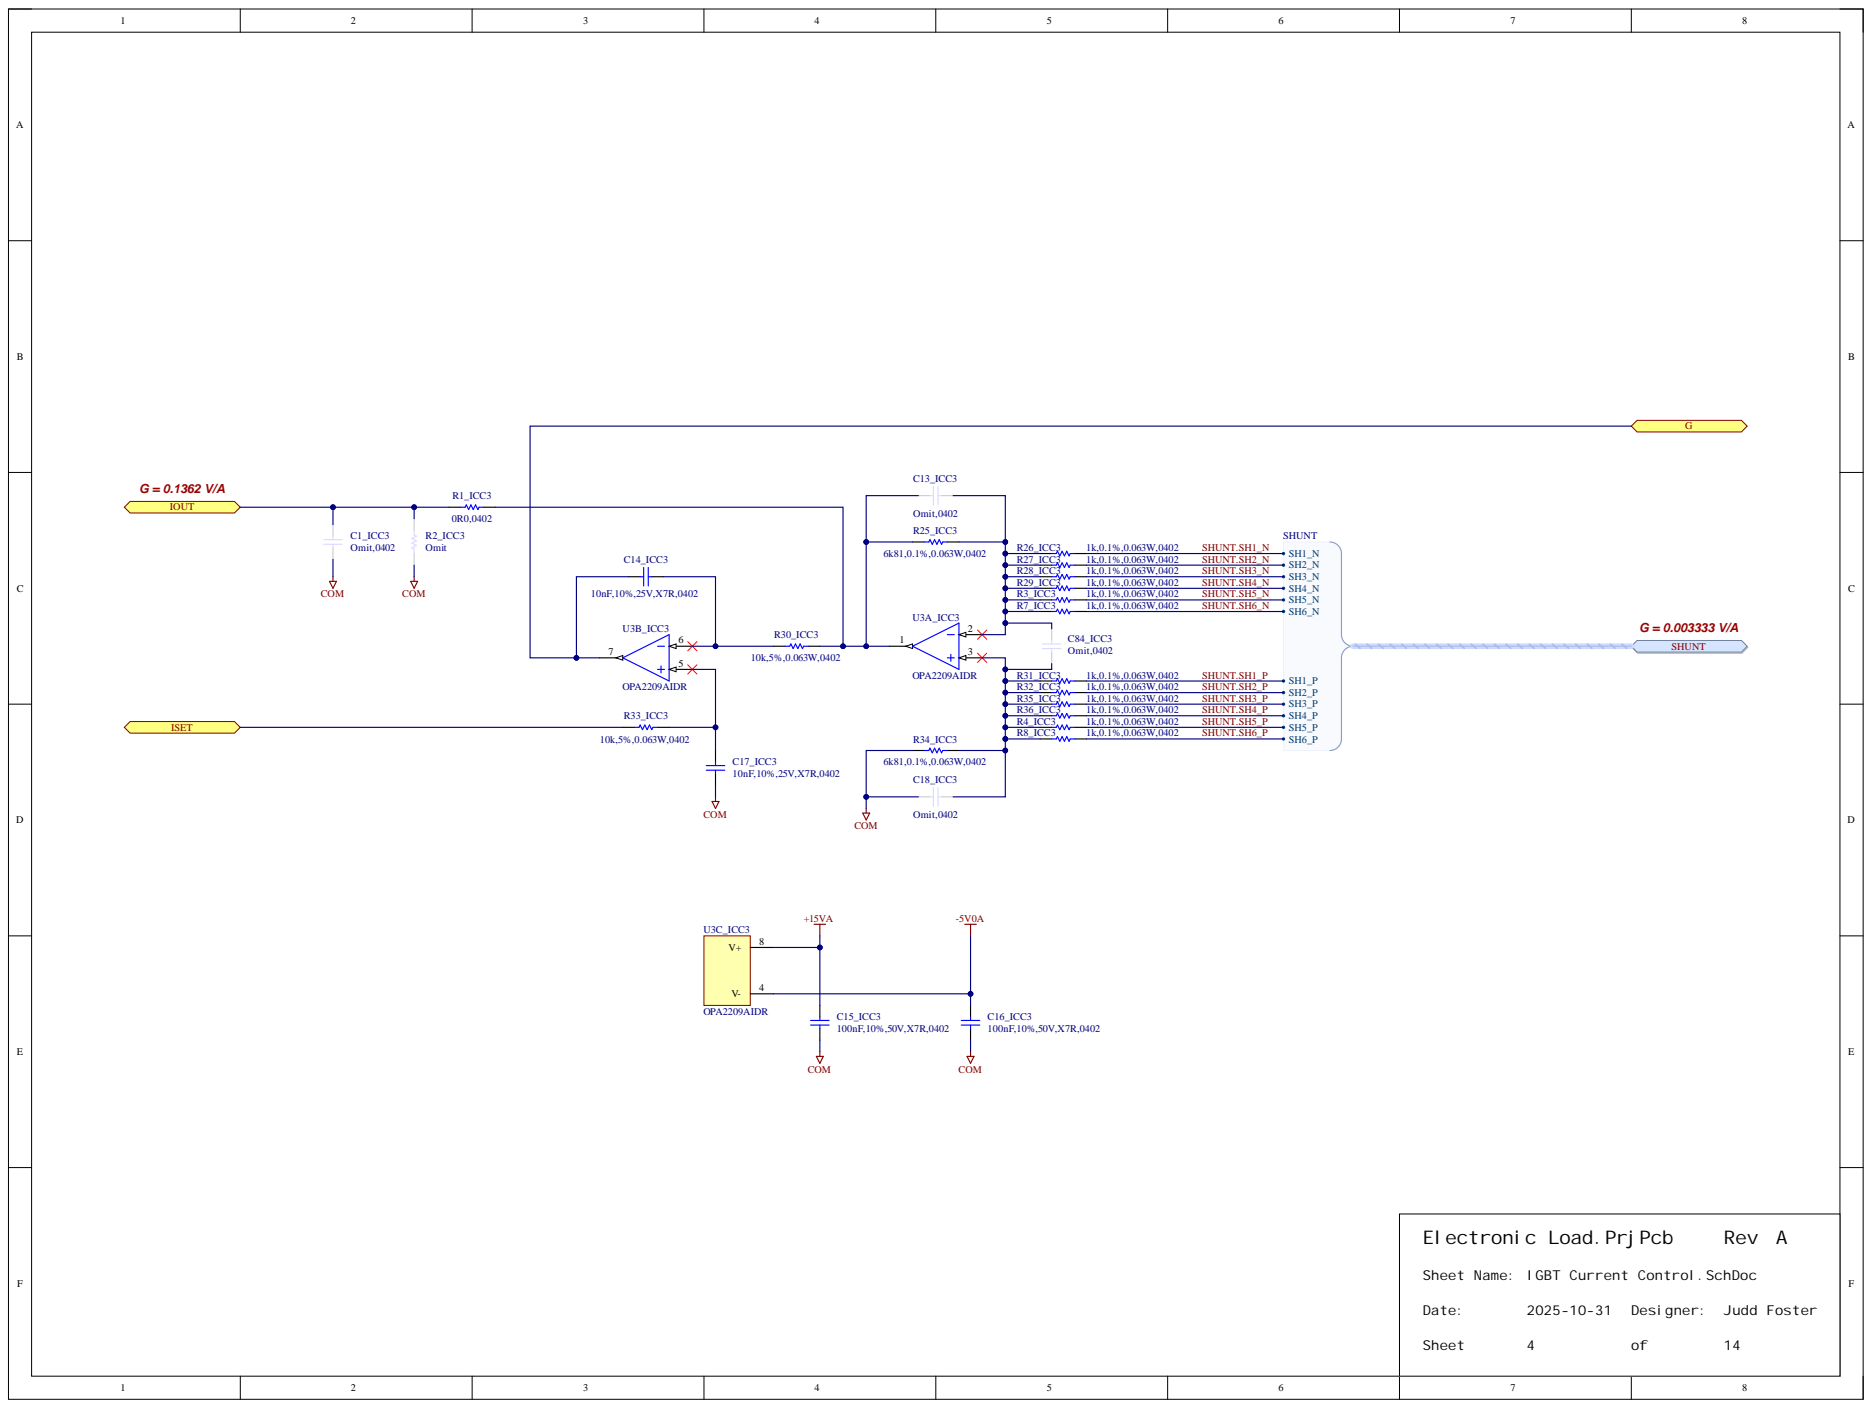
[picture p23: page 13]

C13_ICC3

Sheet Name: IGBT Current Control.SchDoc

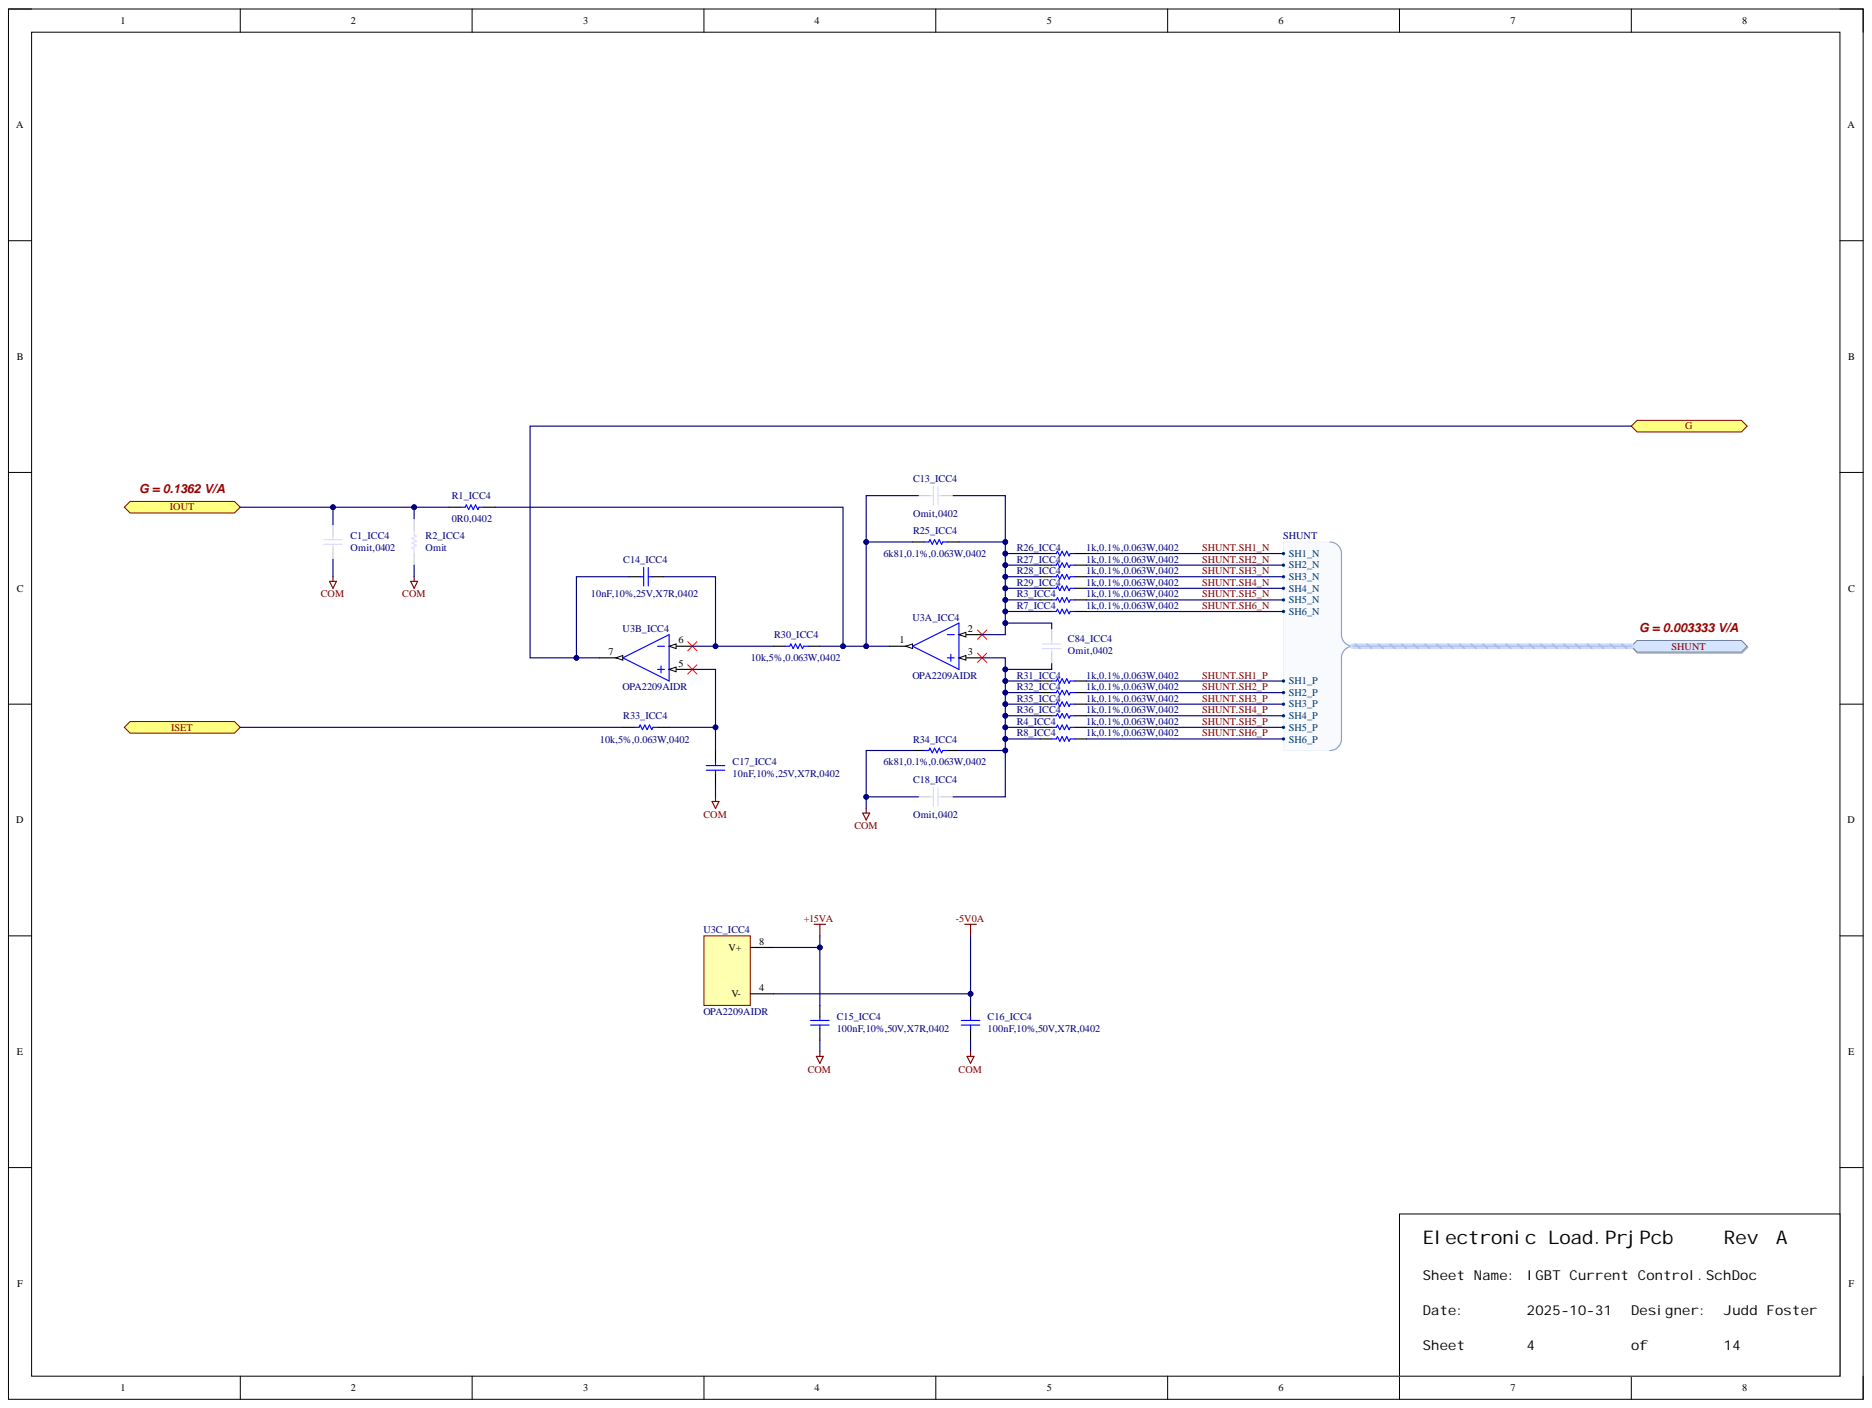
[picture p24: page 14]

C13_ICC4

Sheet Name: IGBT Current Control.SchDoc

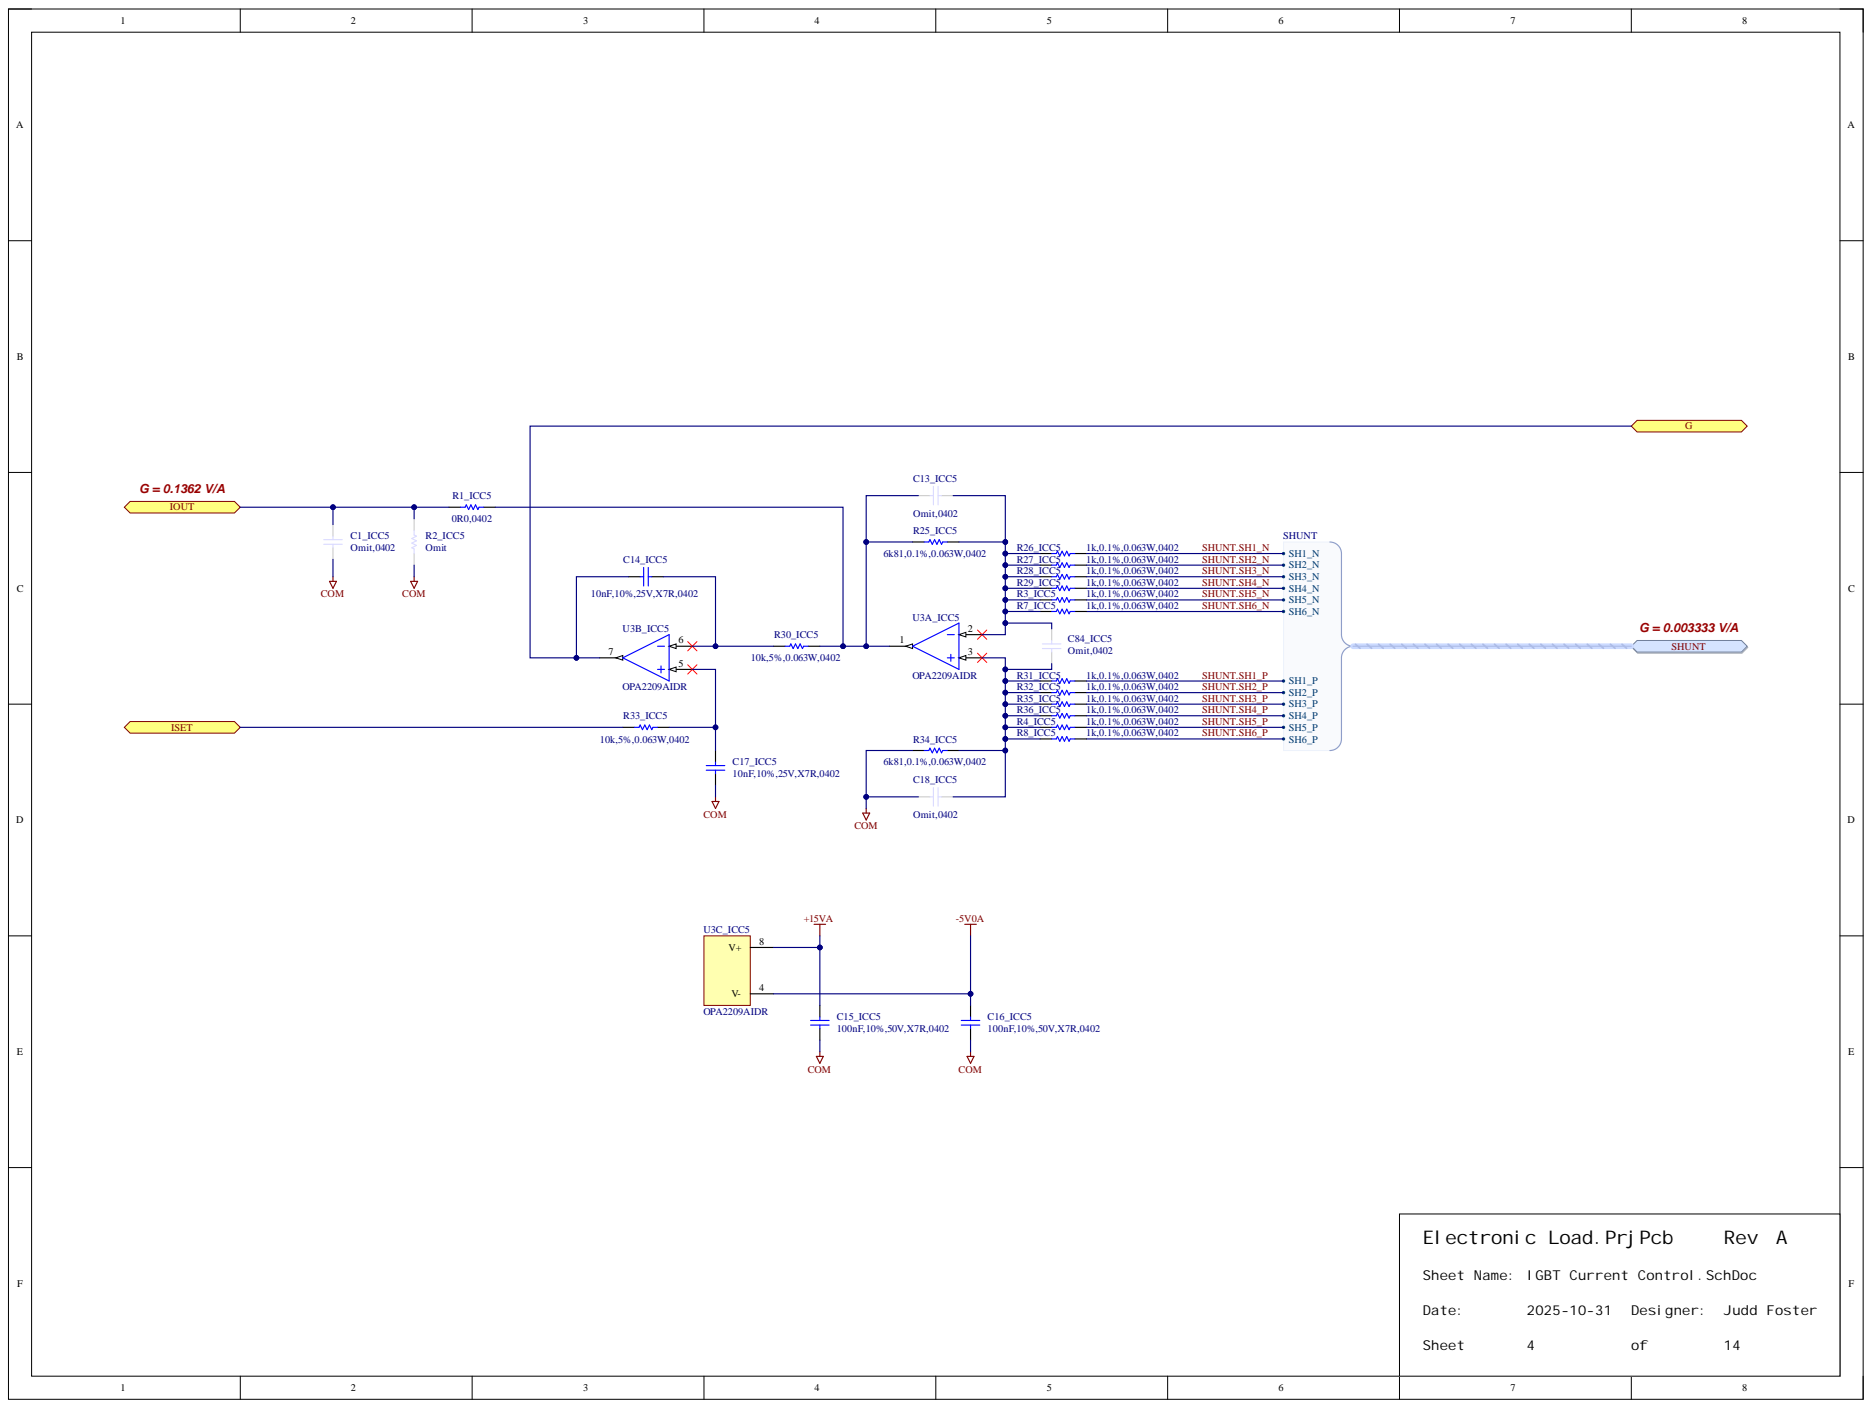
[picture p25: page 15]

C13_ICC5

Sheet Name: IGBT Current Control.SchDoc

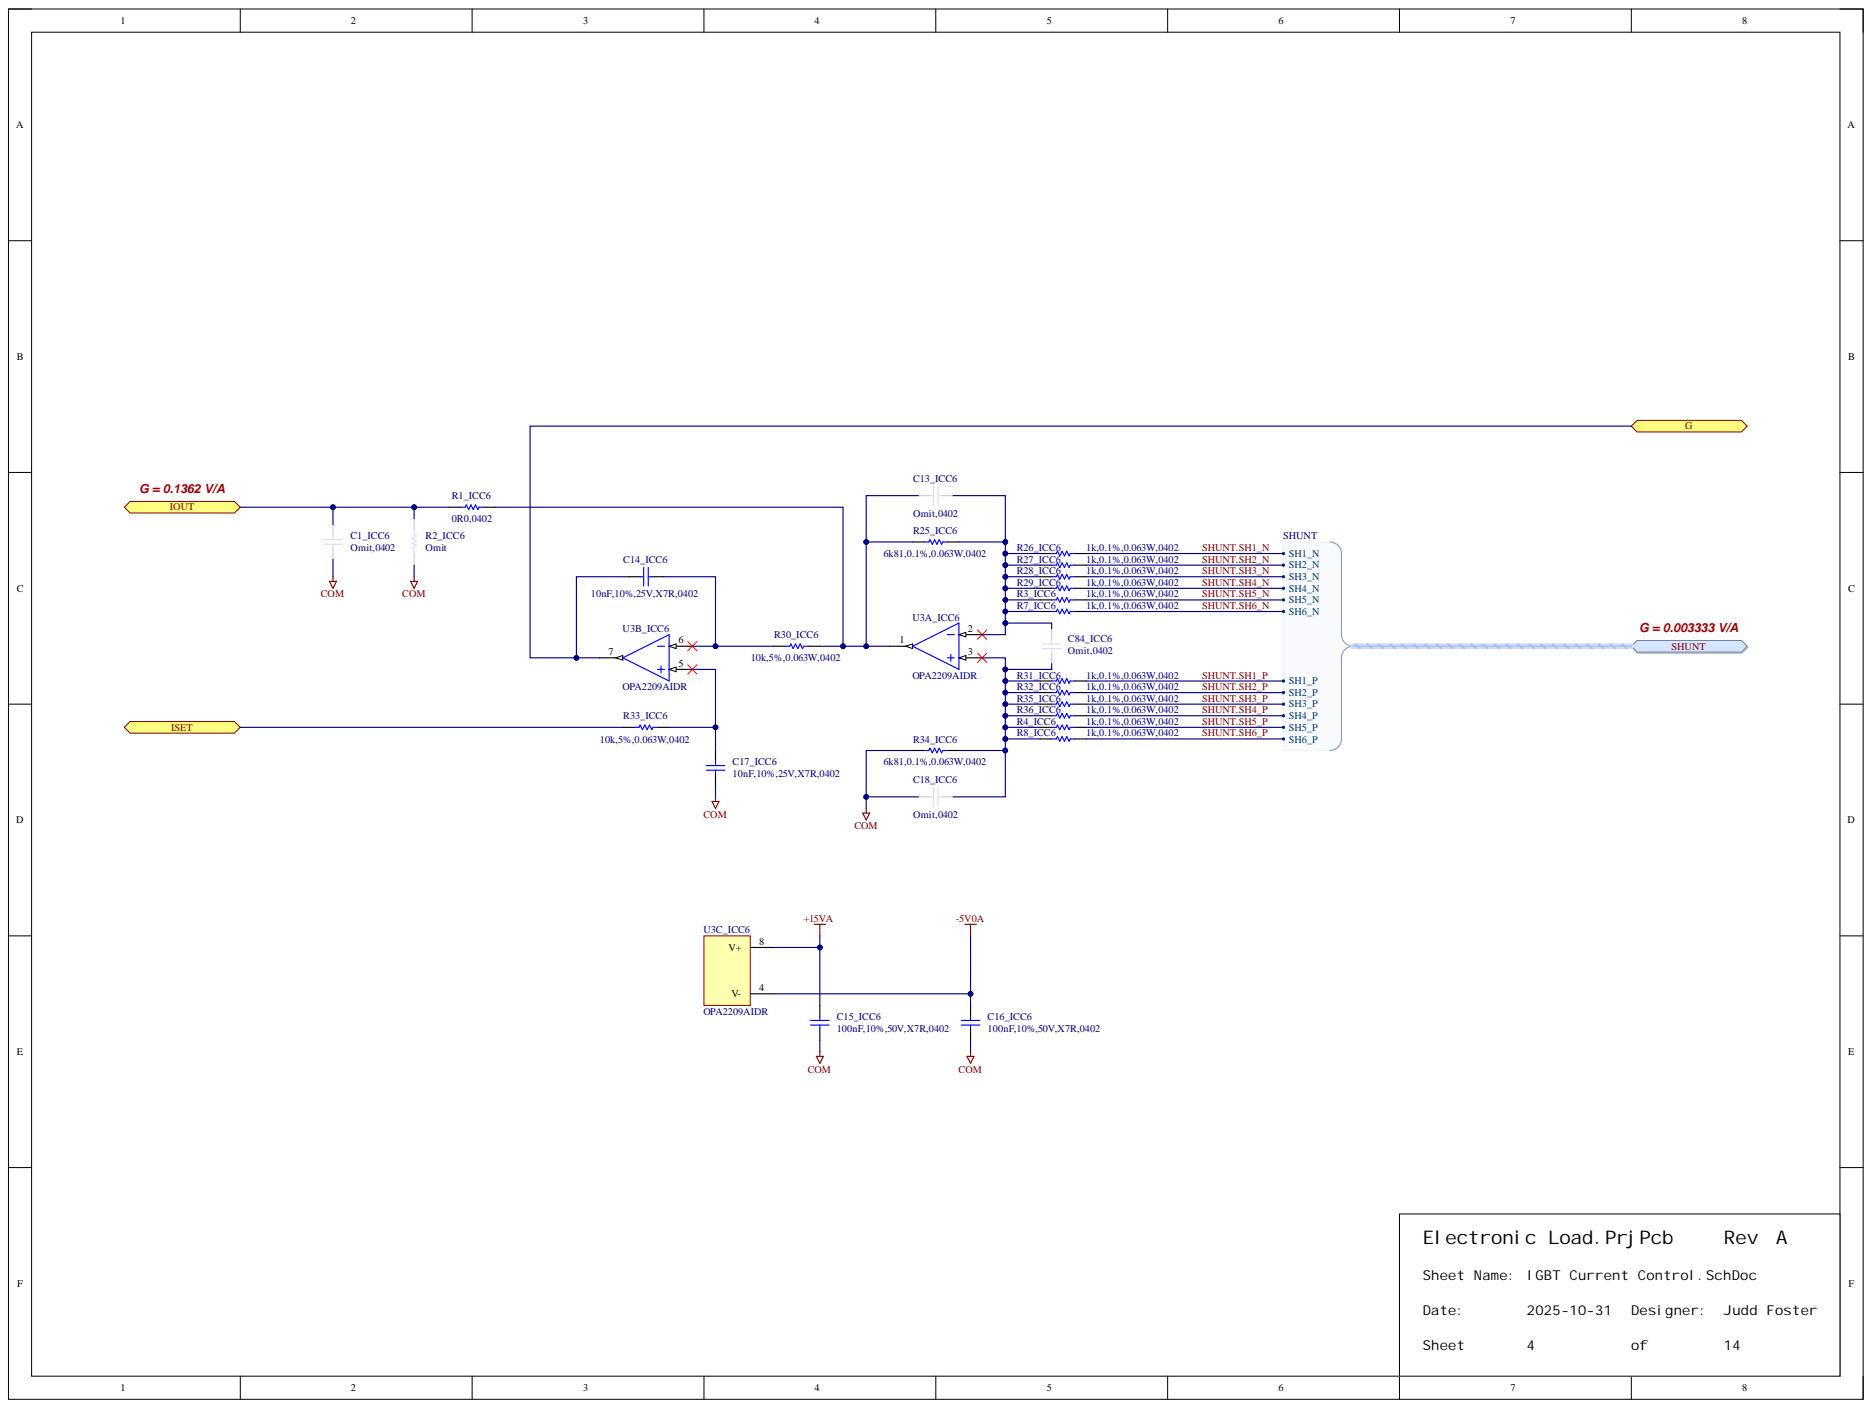
[picture p26: page 16]

C13_ICC6

Sheet Name: IGBT Current Control.SchDoc

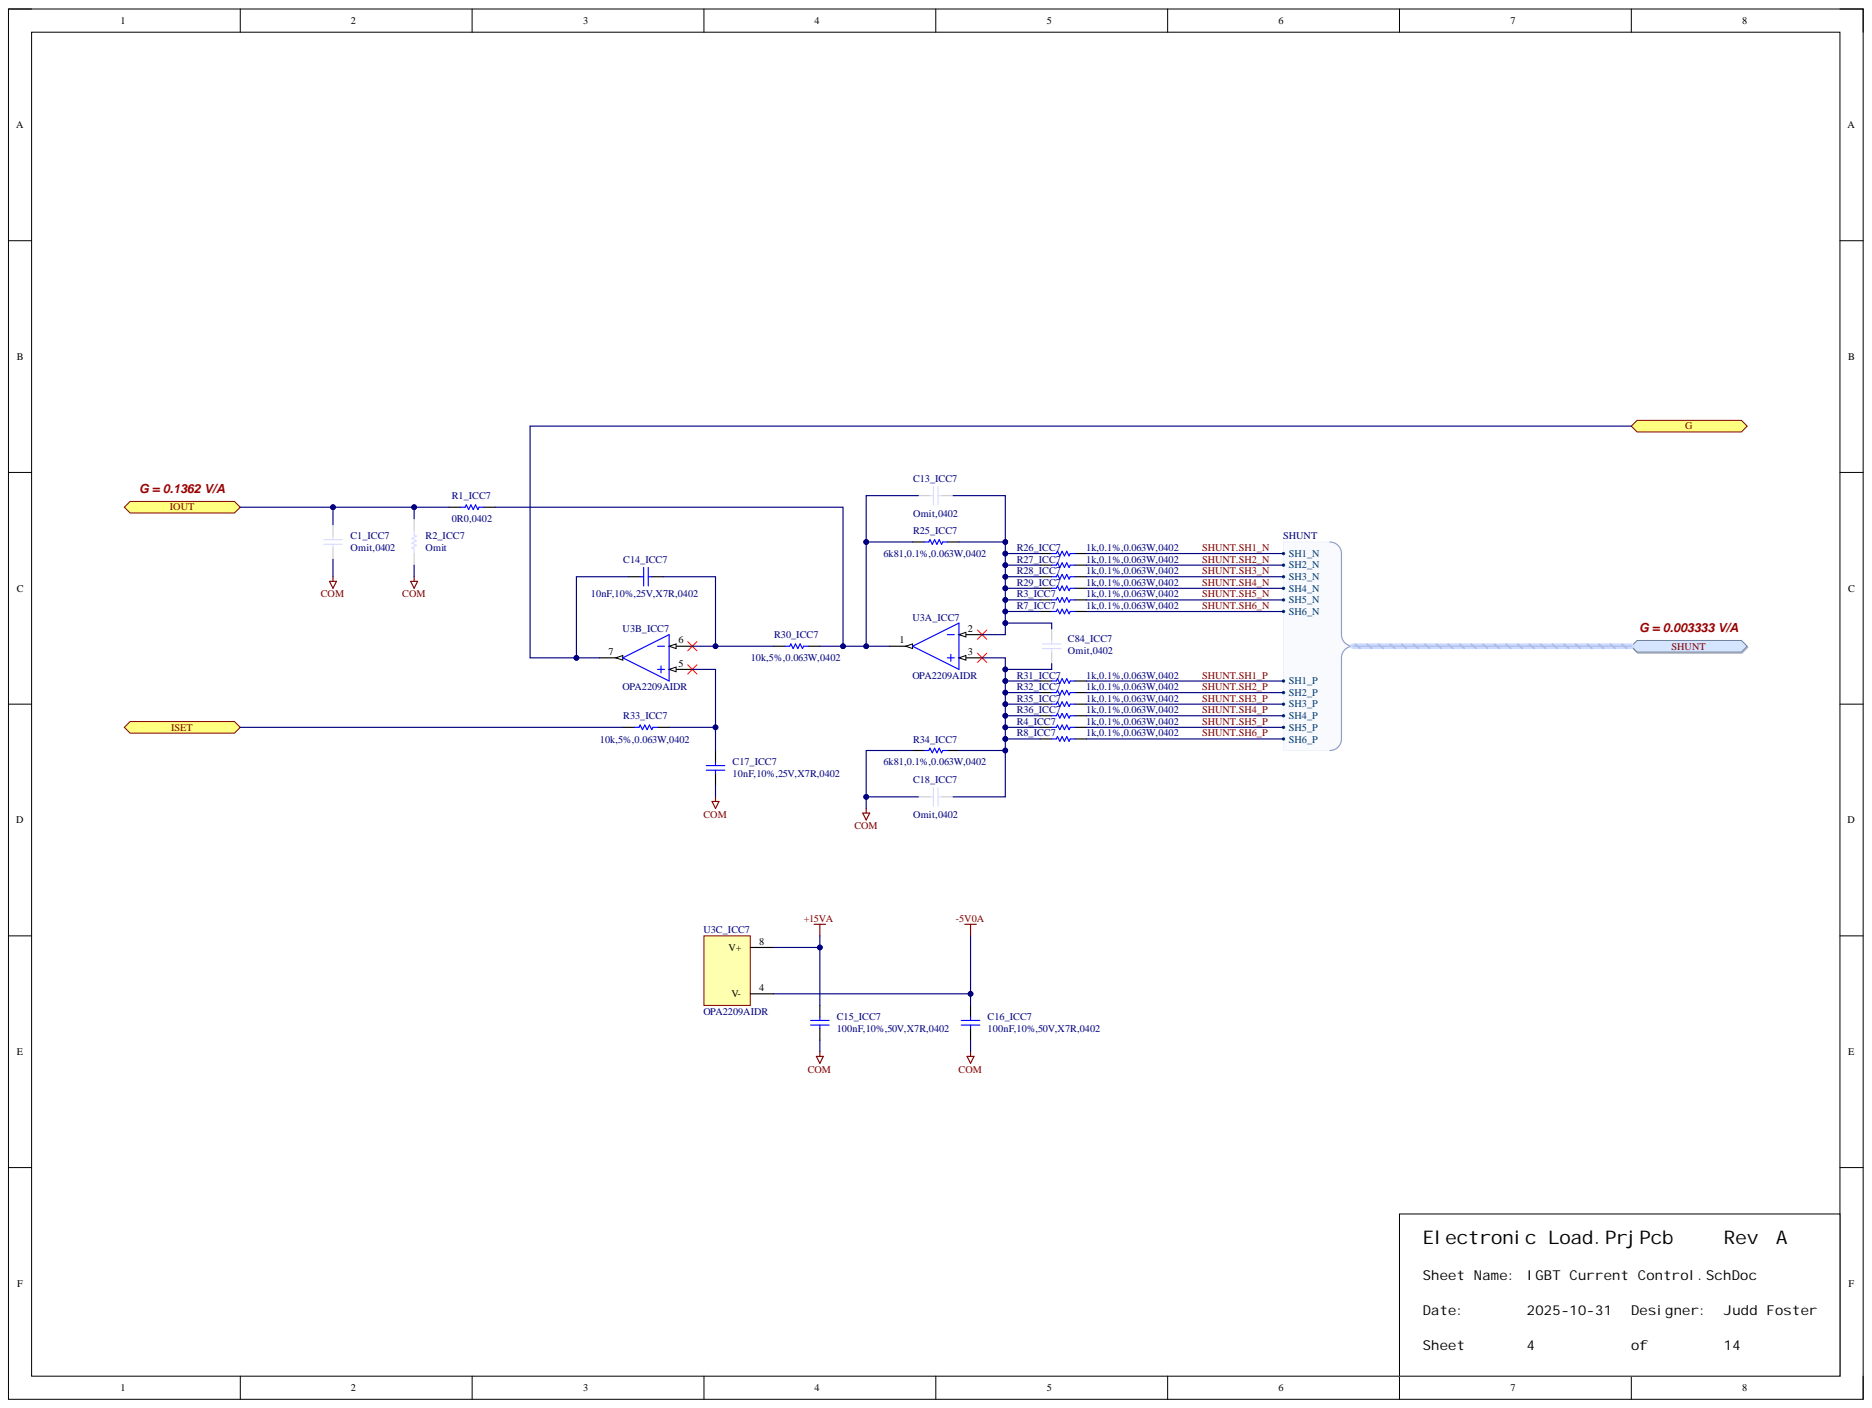
[picture p27: page 17]

C13_ICC7

Sheet Name: IGBT Current Control.SchDoc

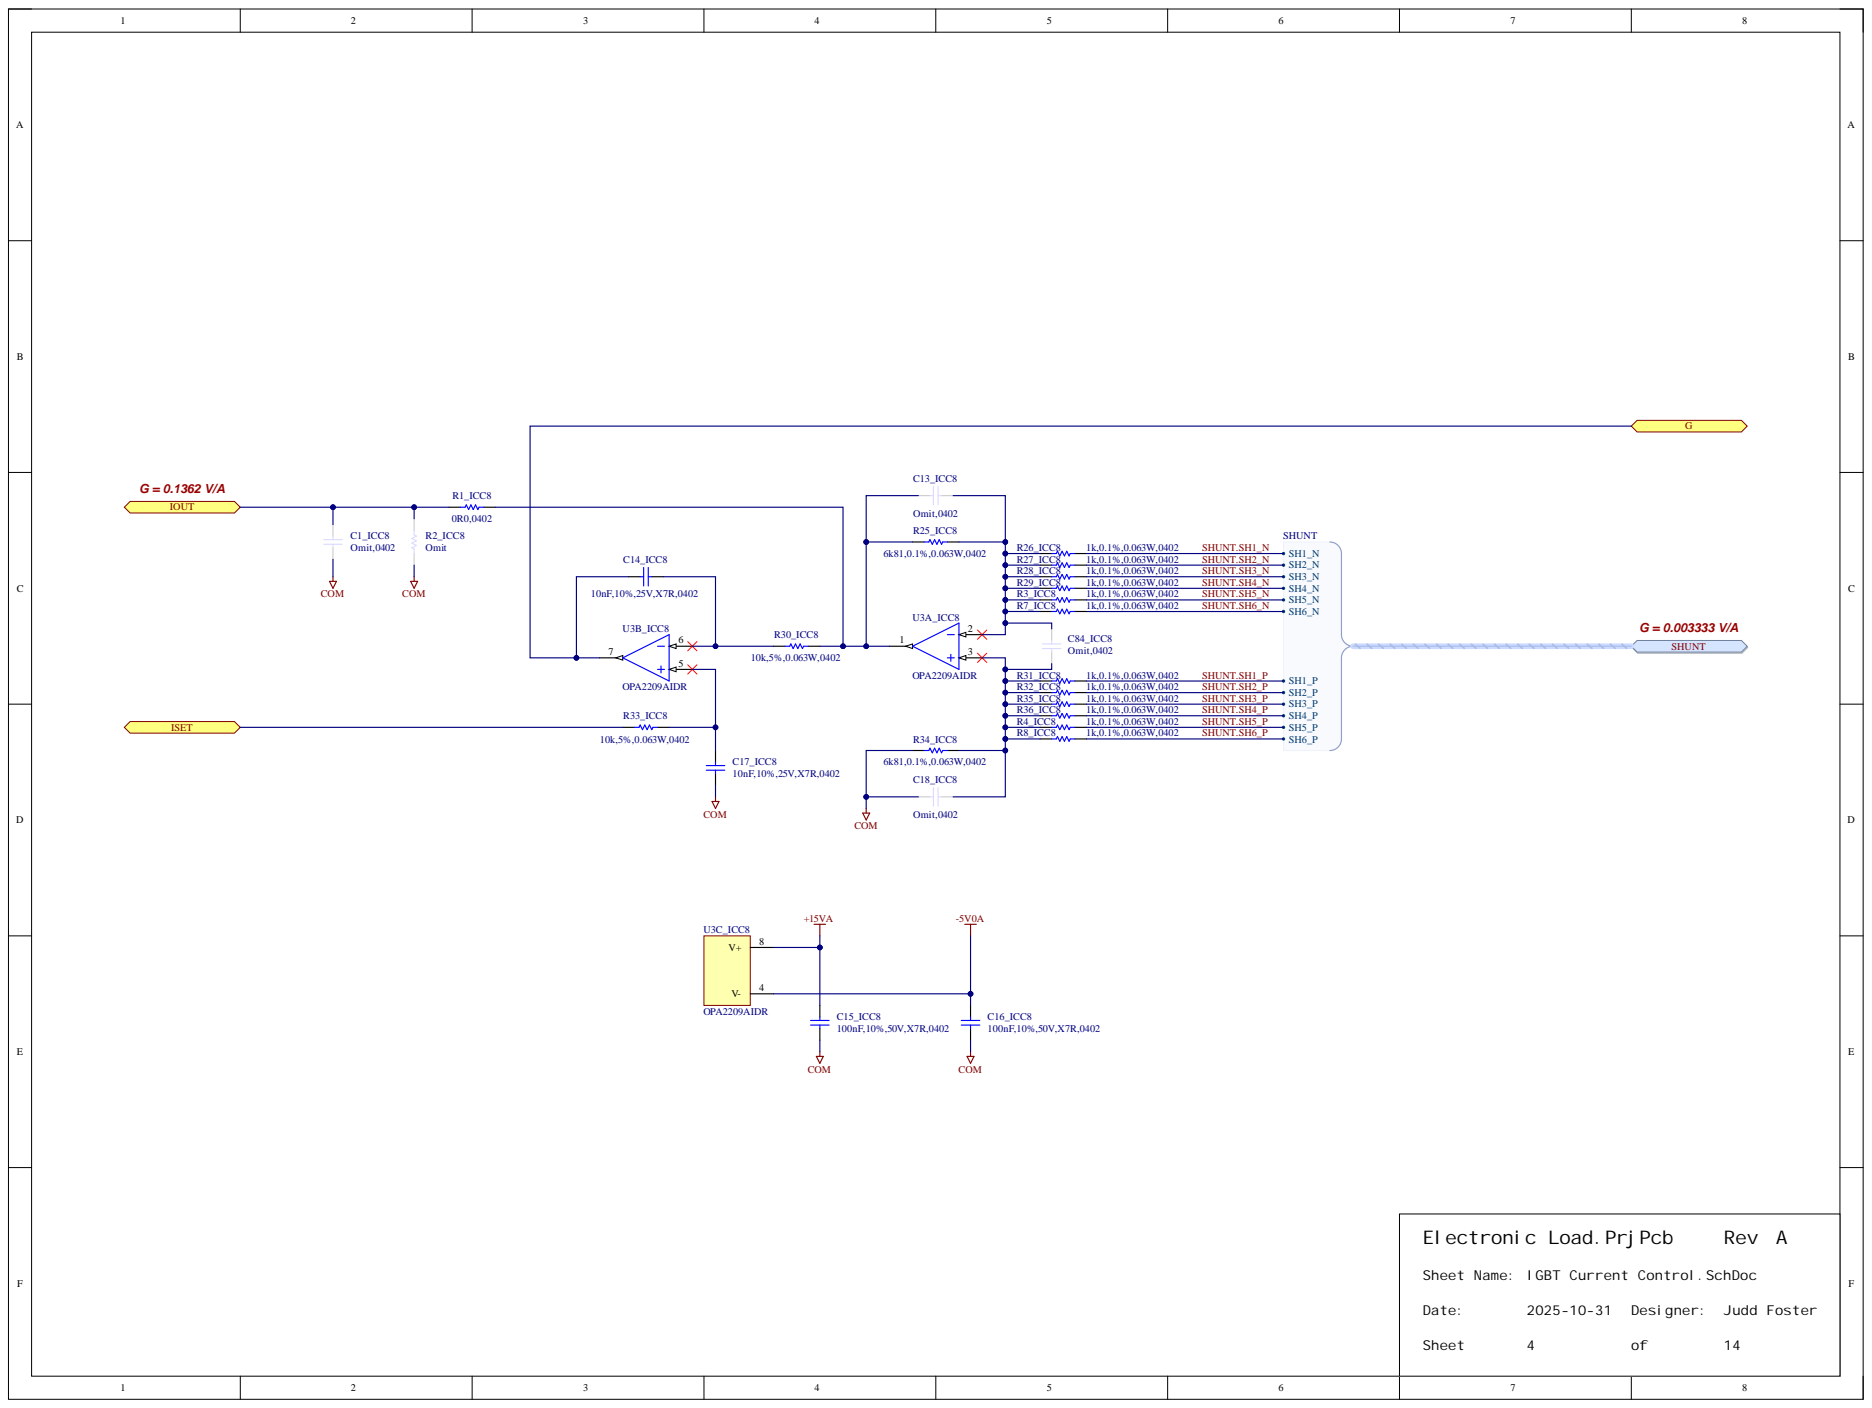
[picture p28: page 18]

C13_ICC8

Sheet Name: IGBT Current Control.SchDoc

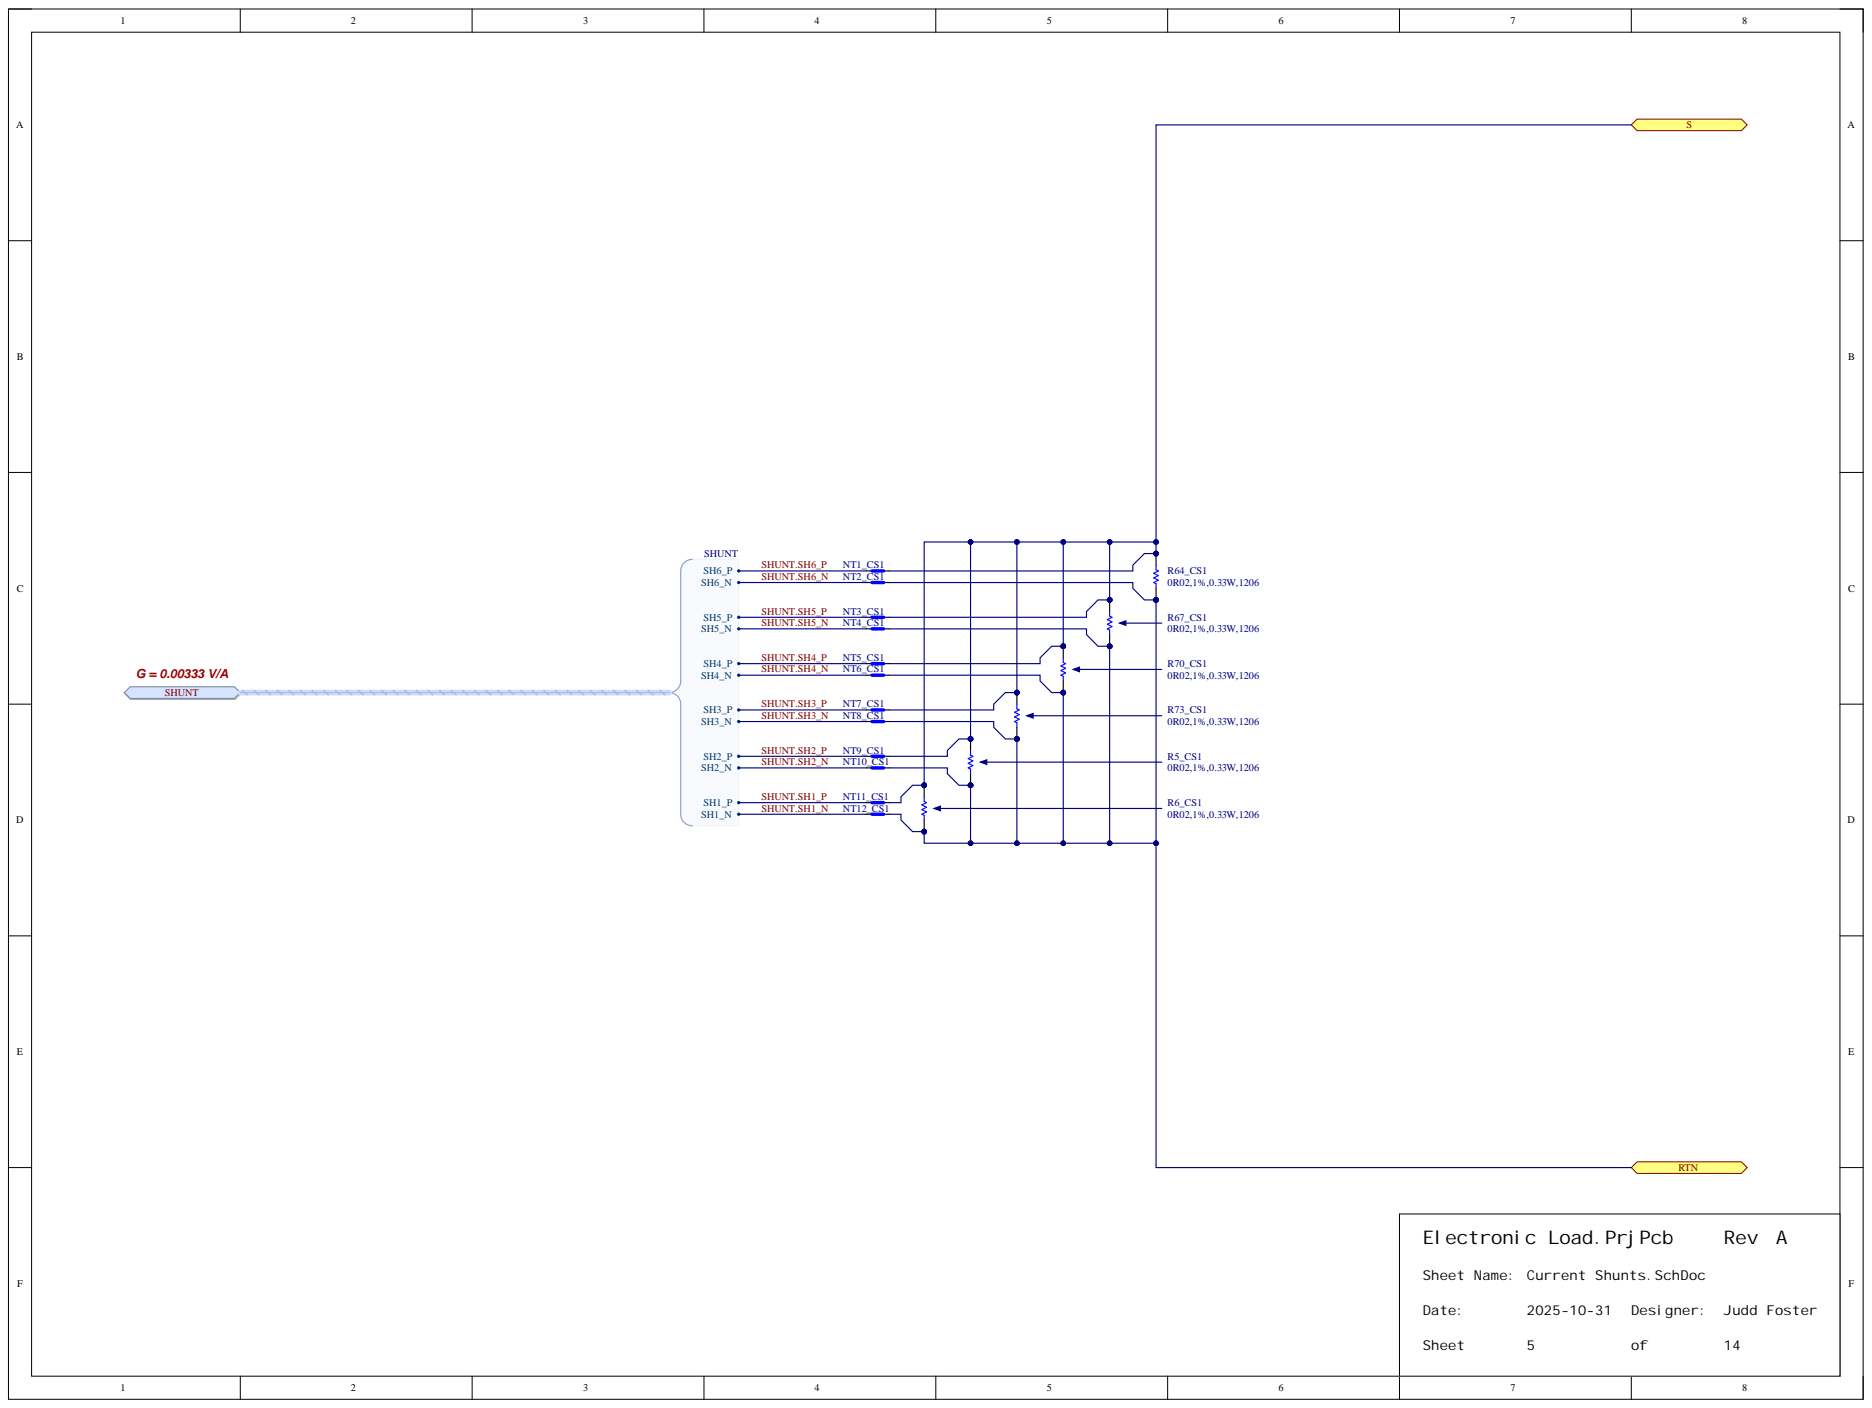
[picture p29: page 19]

Sheet Name: Current Shunts.SchDoc

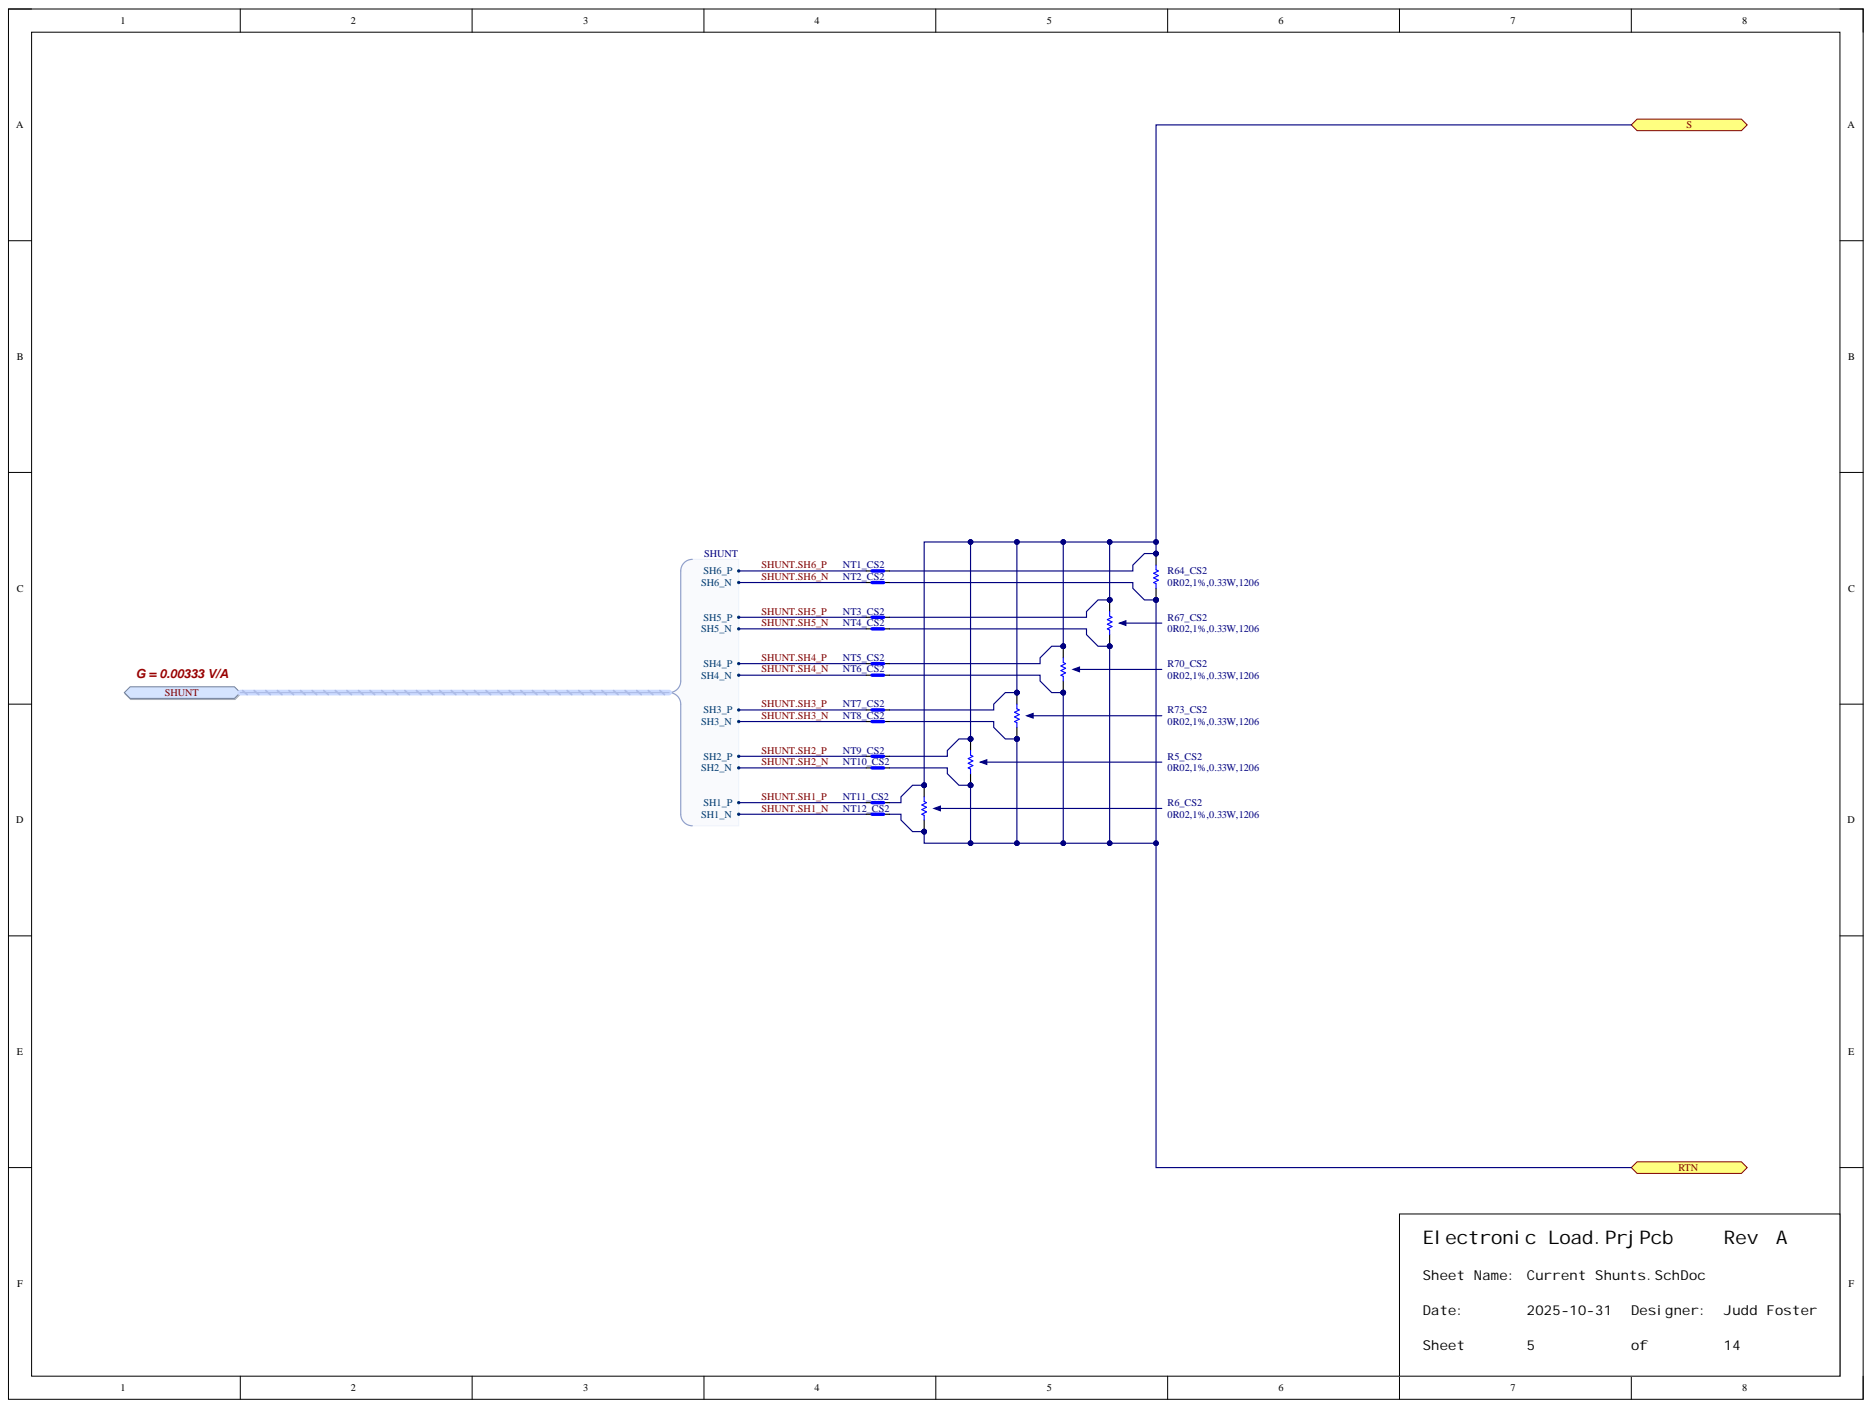
[picture p30: page 20]

Sheet Name: Current Shunts.SchDoc

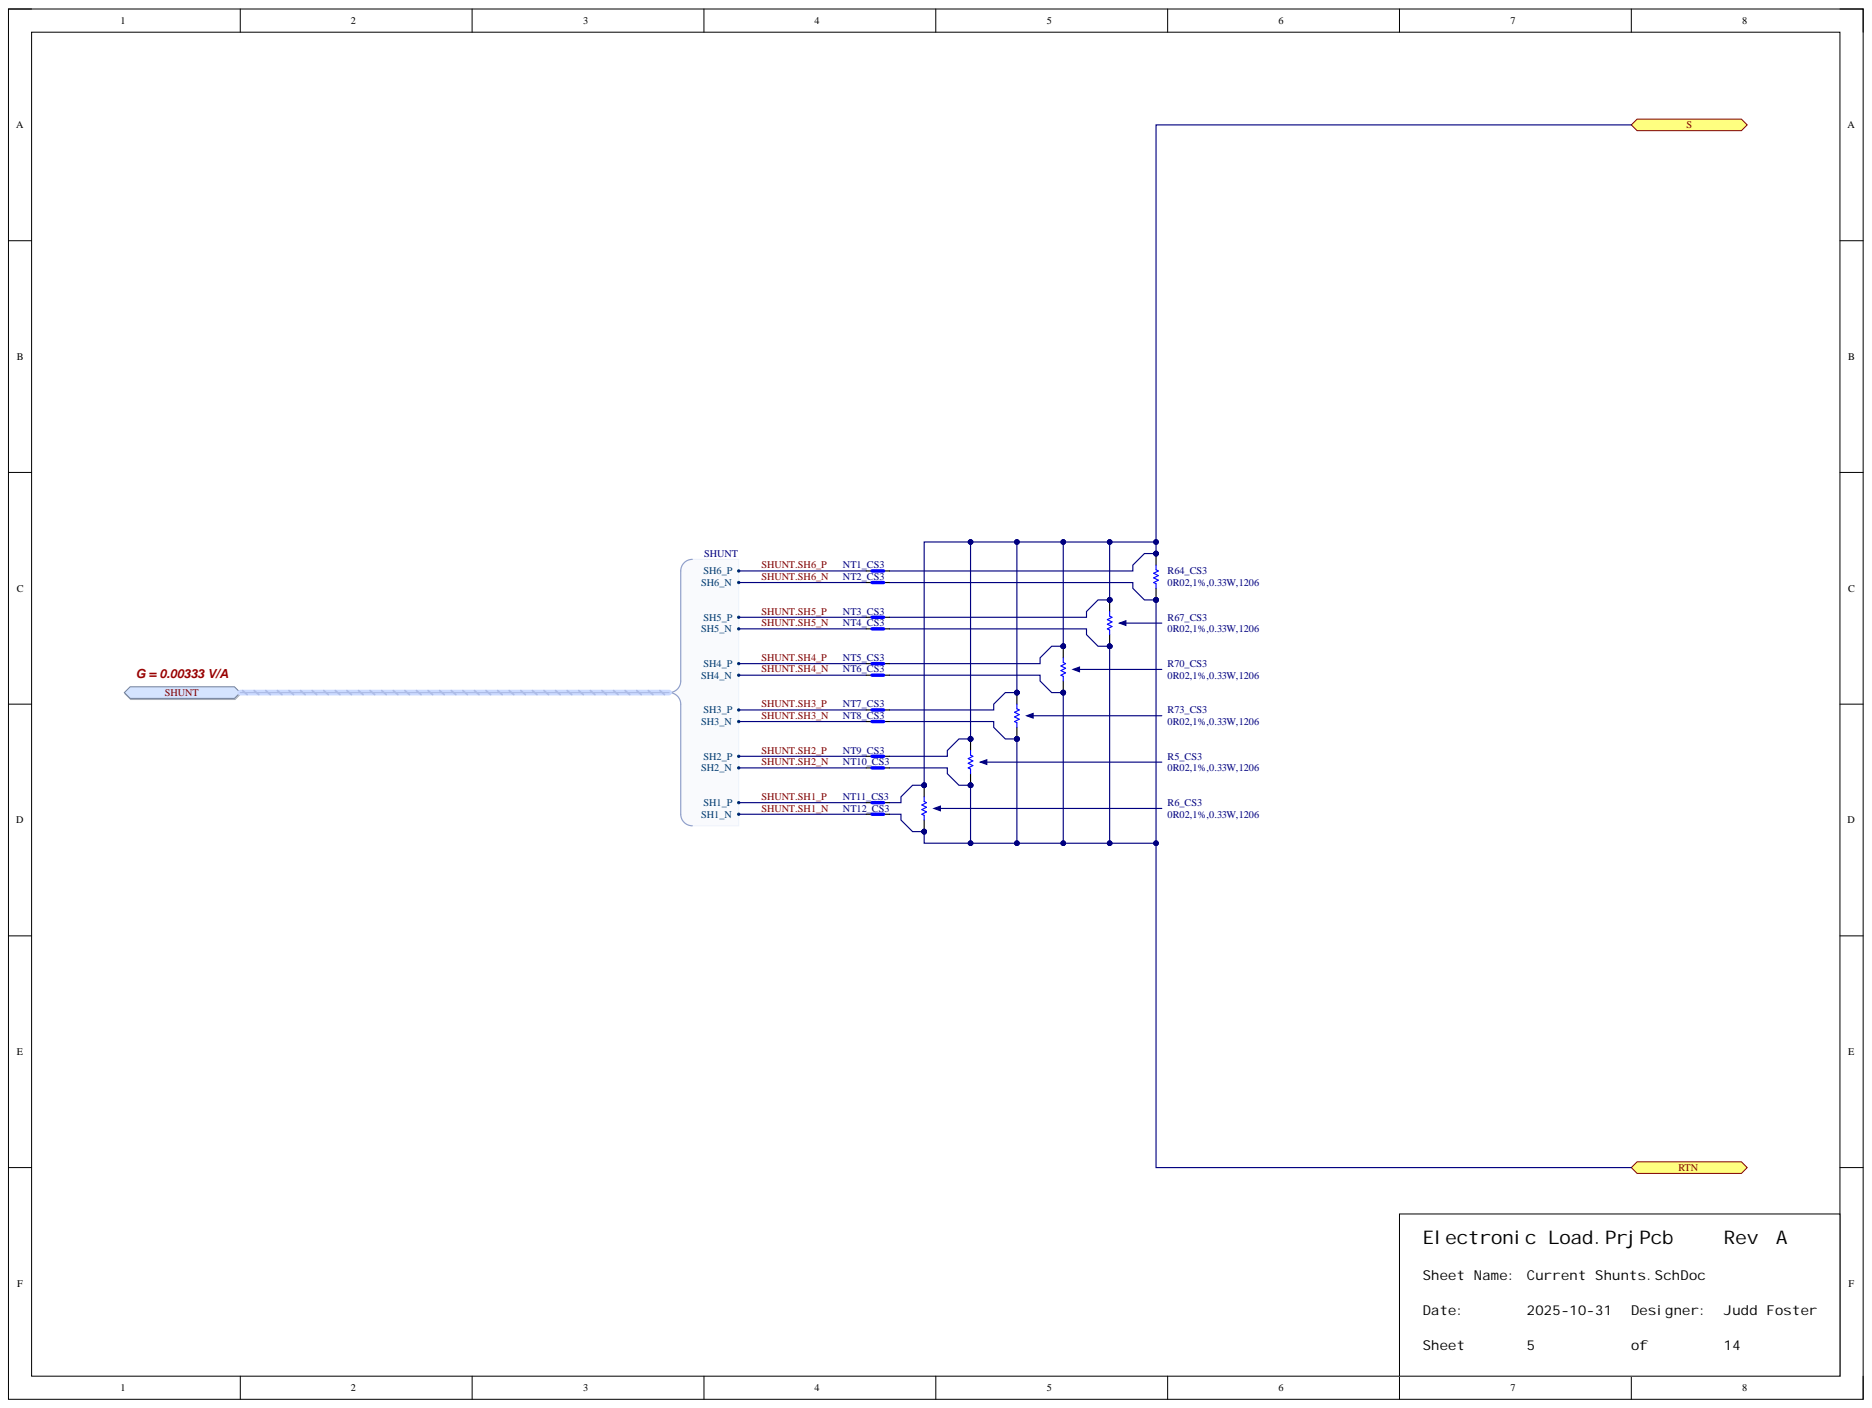
[picture p31: page 21]

Sheet Name: Current Shunts.SchDoc

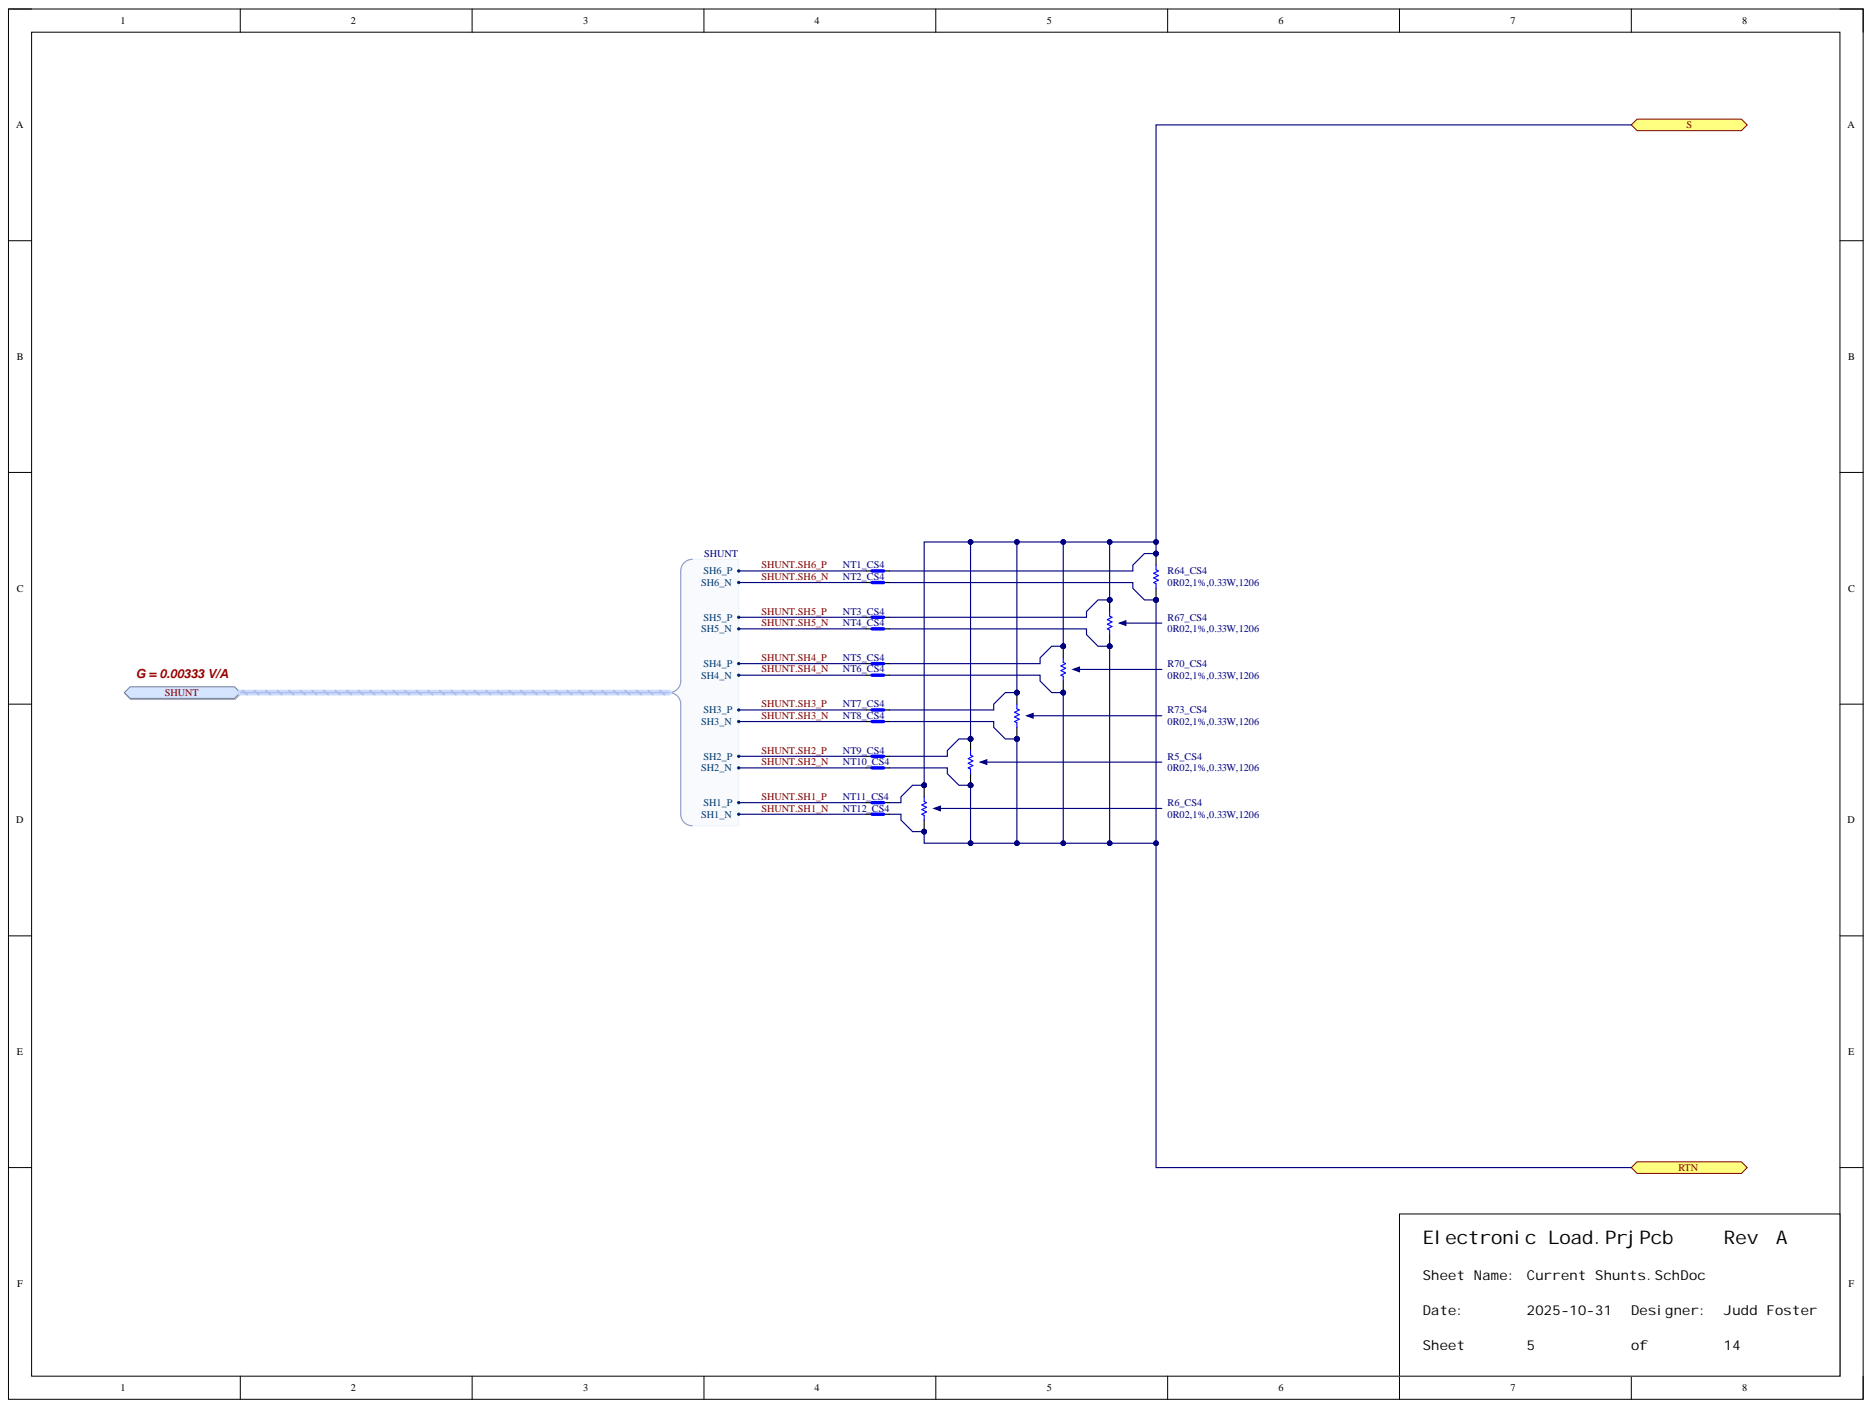
[picture p32: page 22]

Sheet Name: Current Shunts.SchDoc

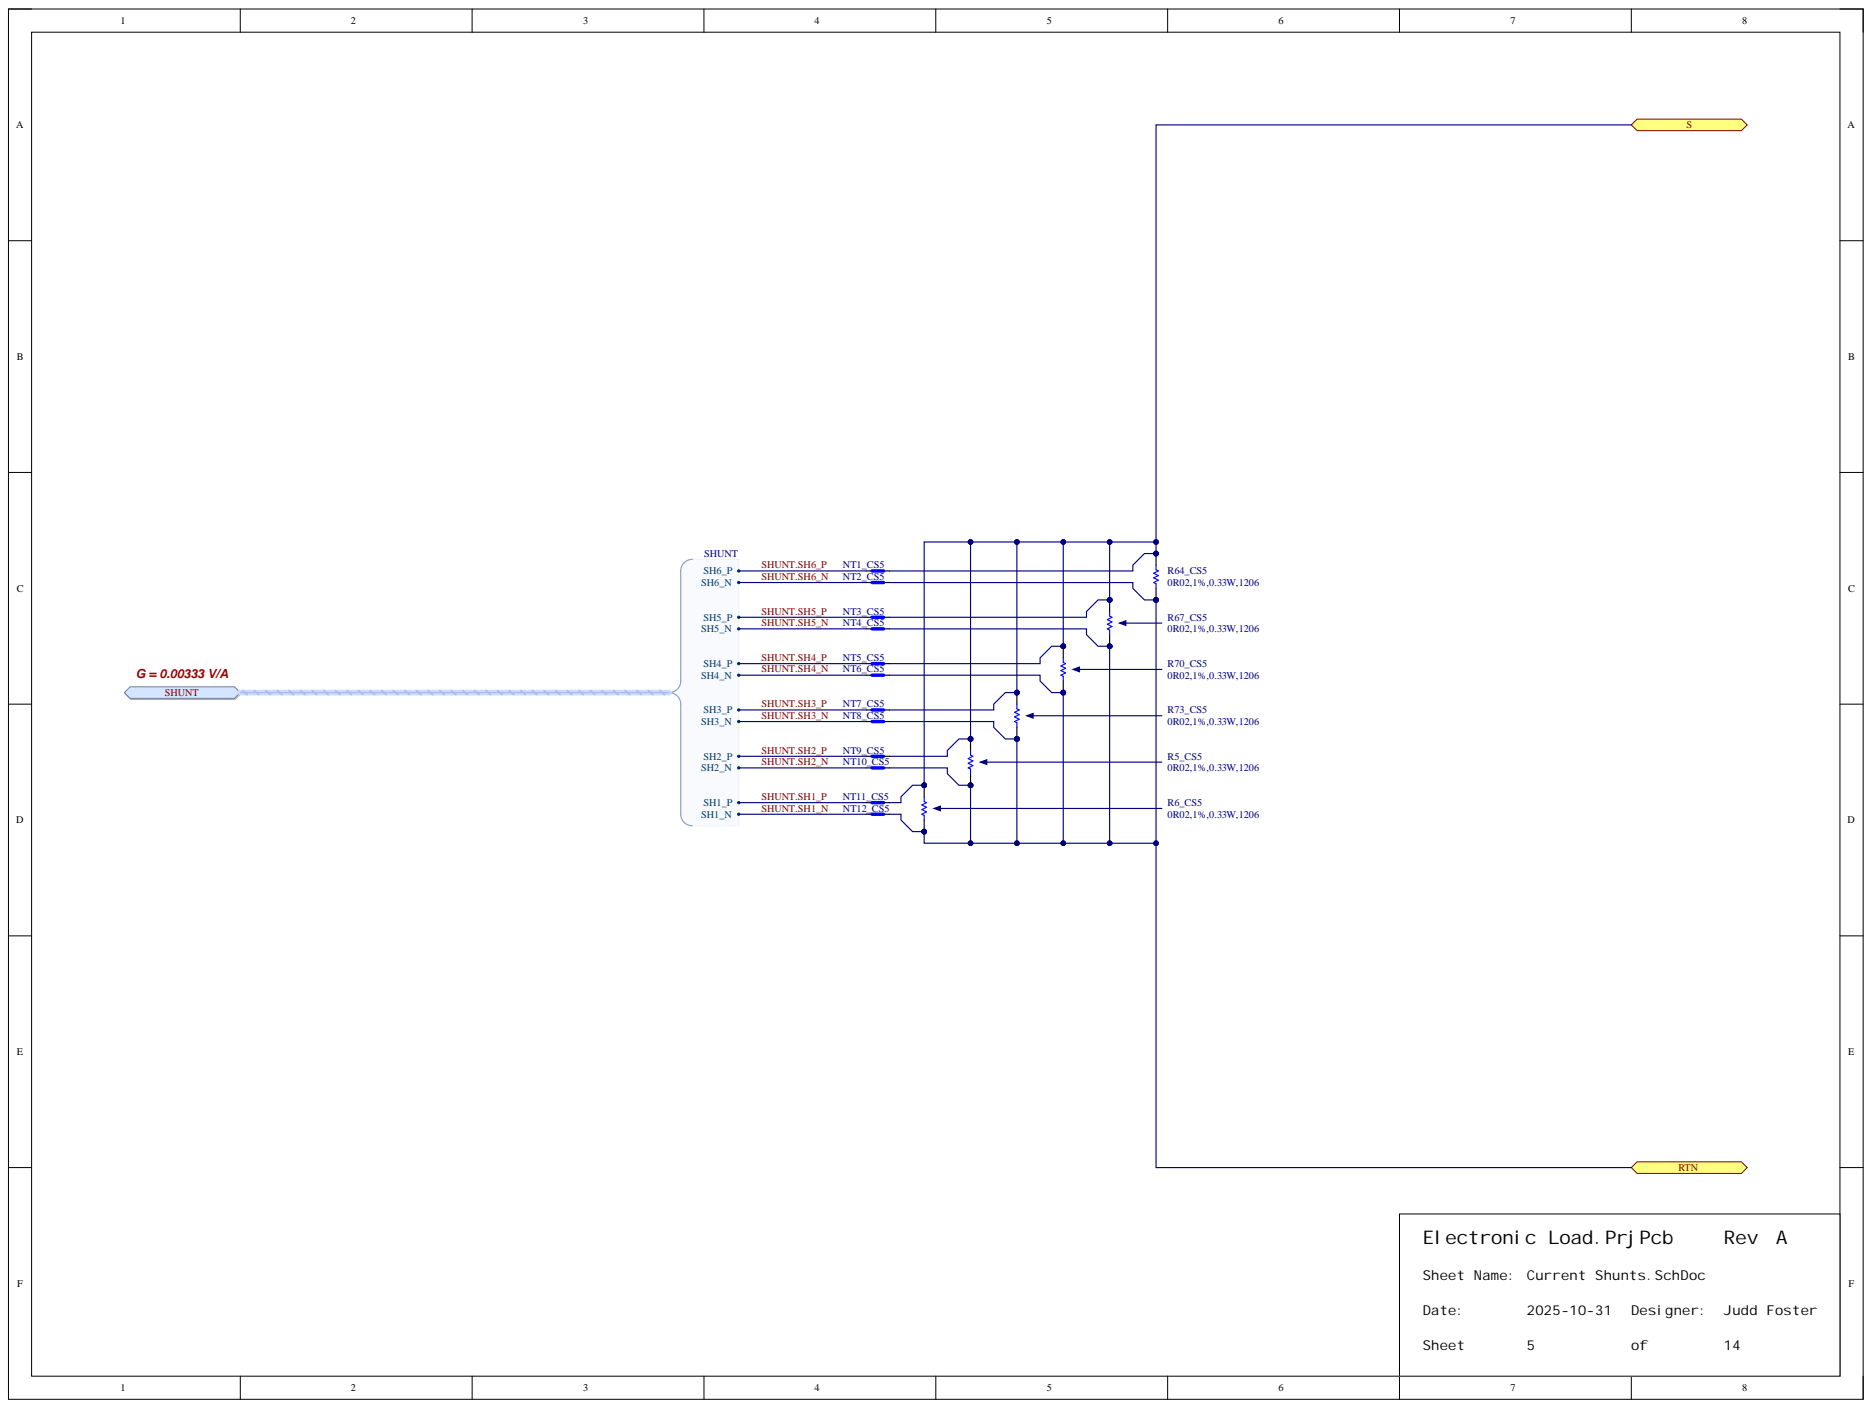
[picture p33: page 23]

Sheet Name: Current Shunts.SchDoc

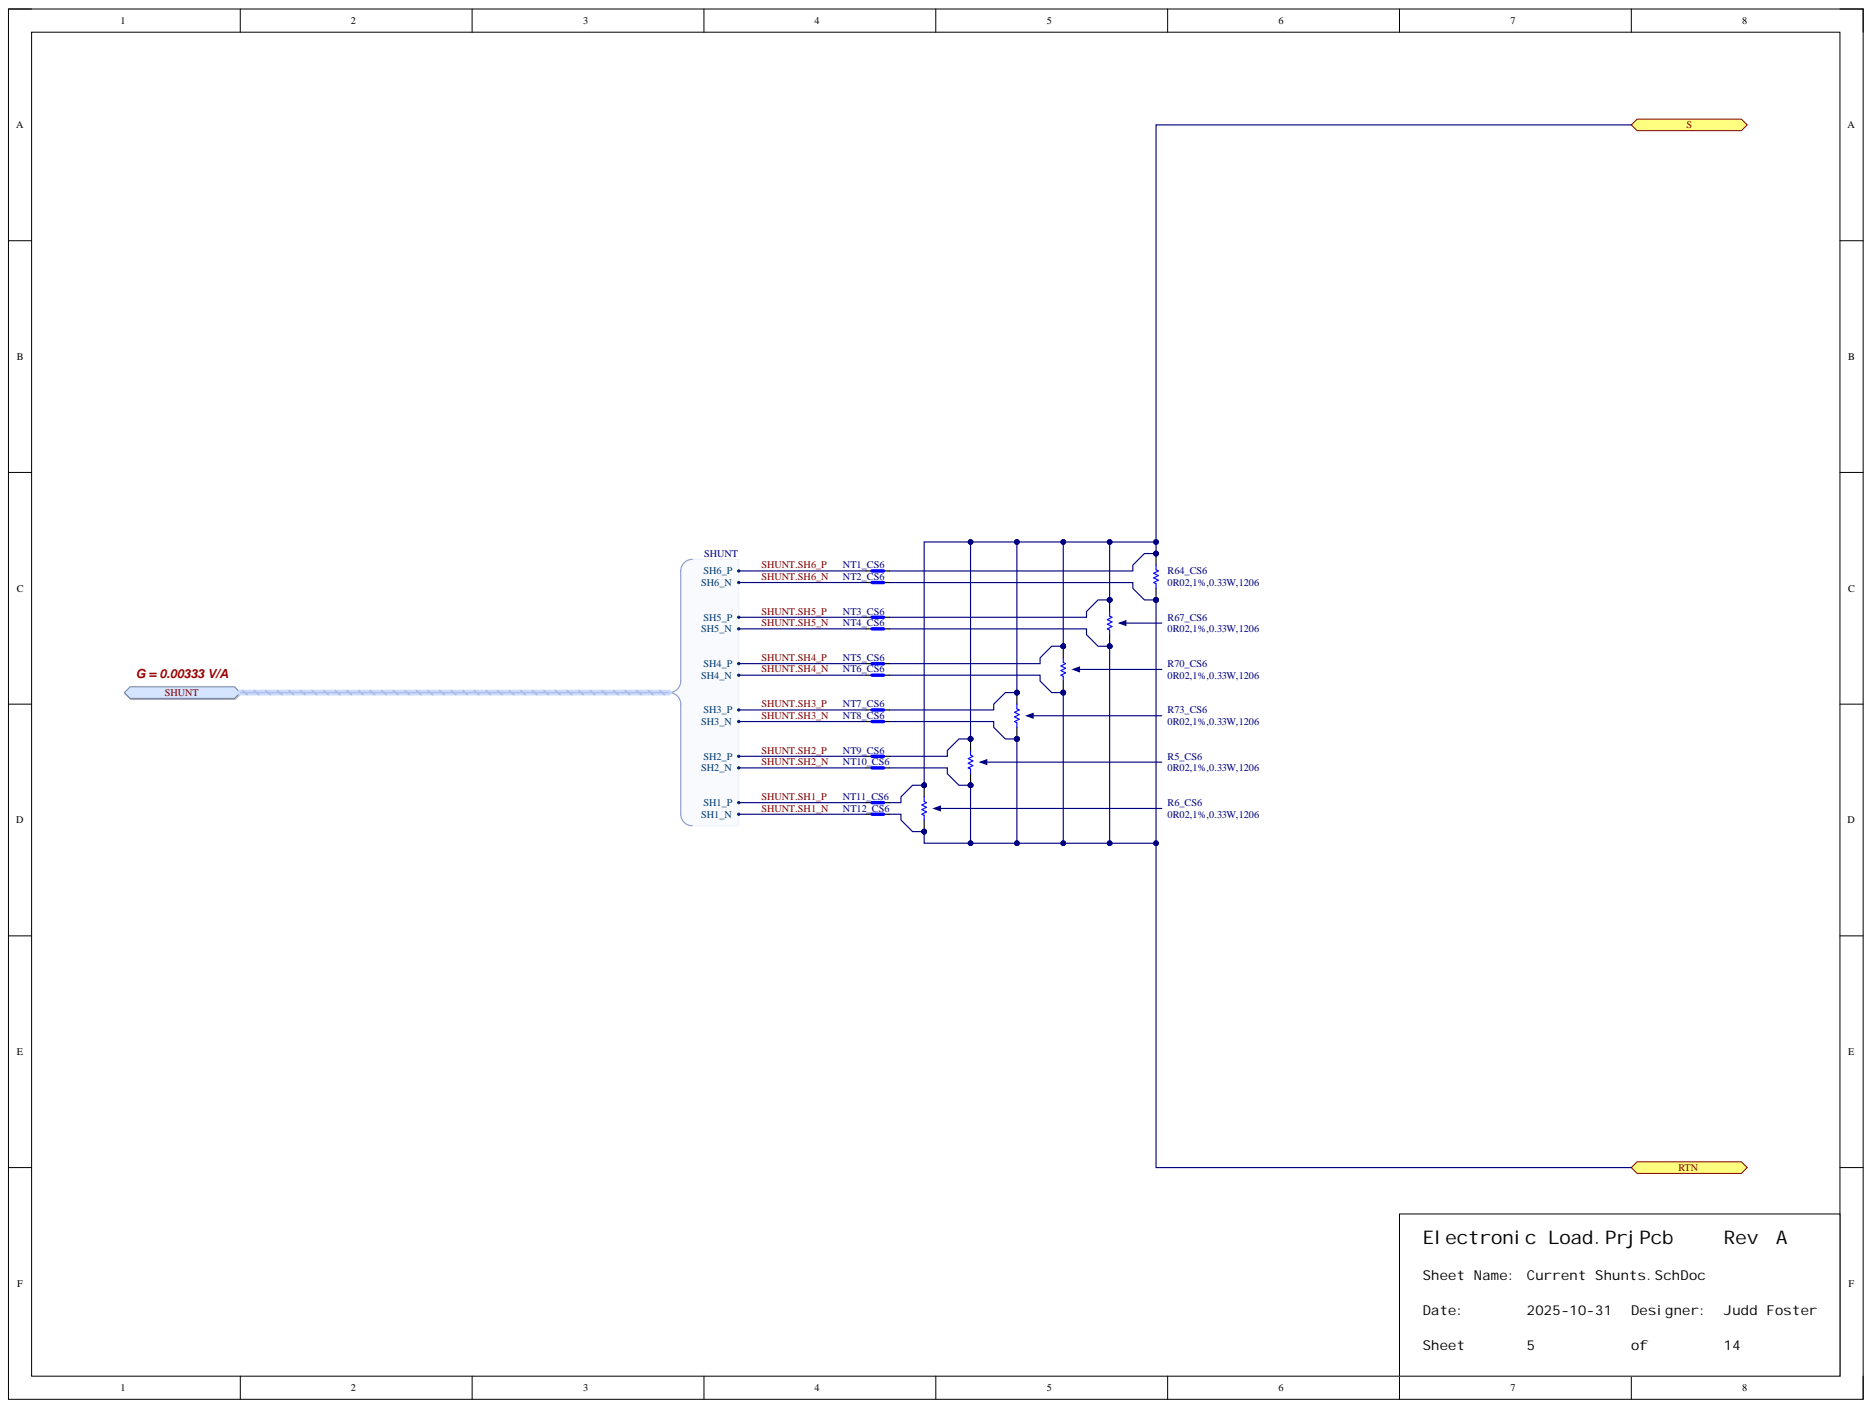
[picture p34: page 24]

Sheet Name: Current Shunts.SchDoc

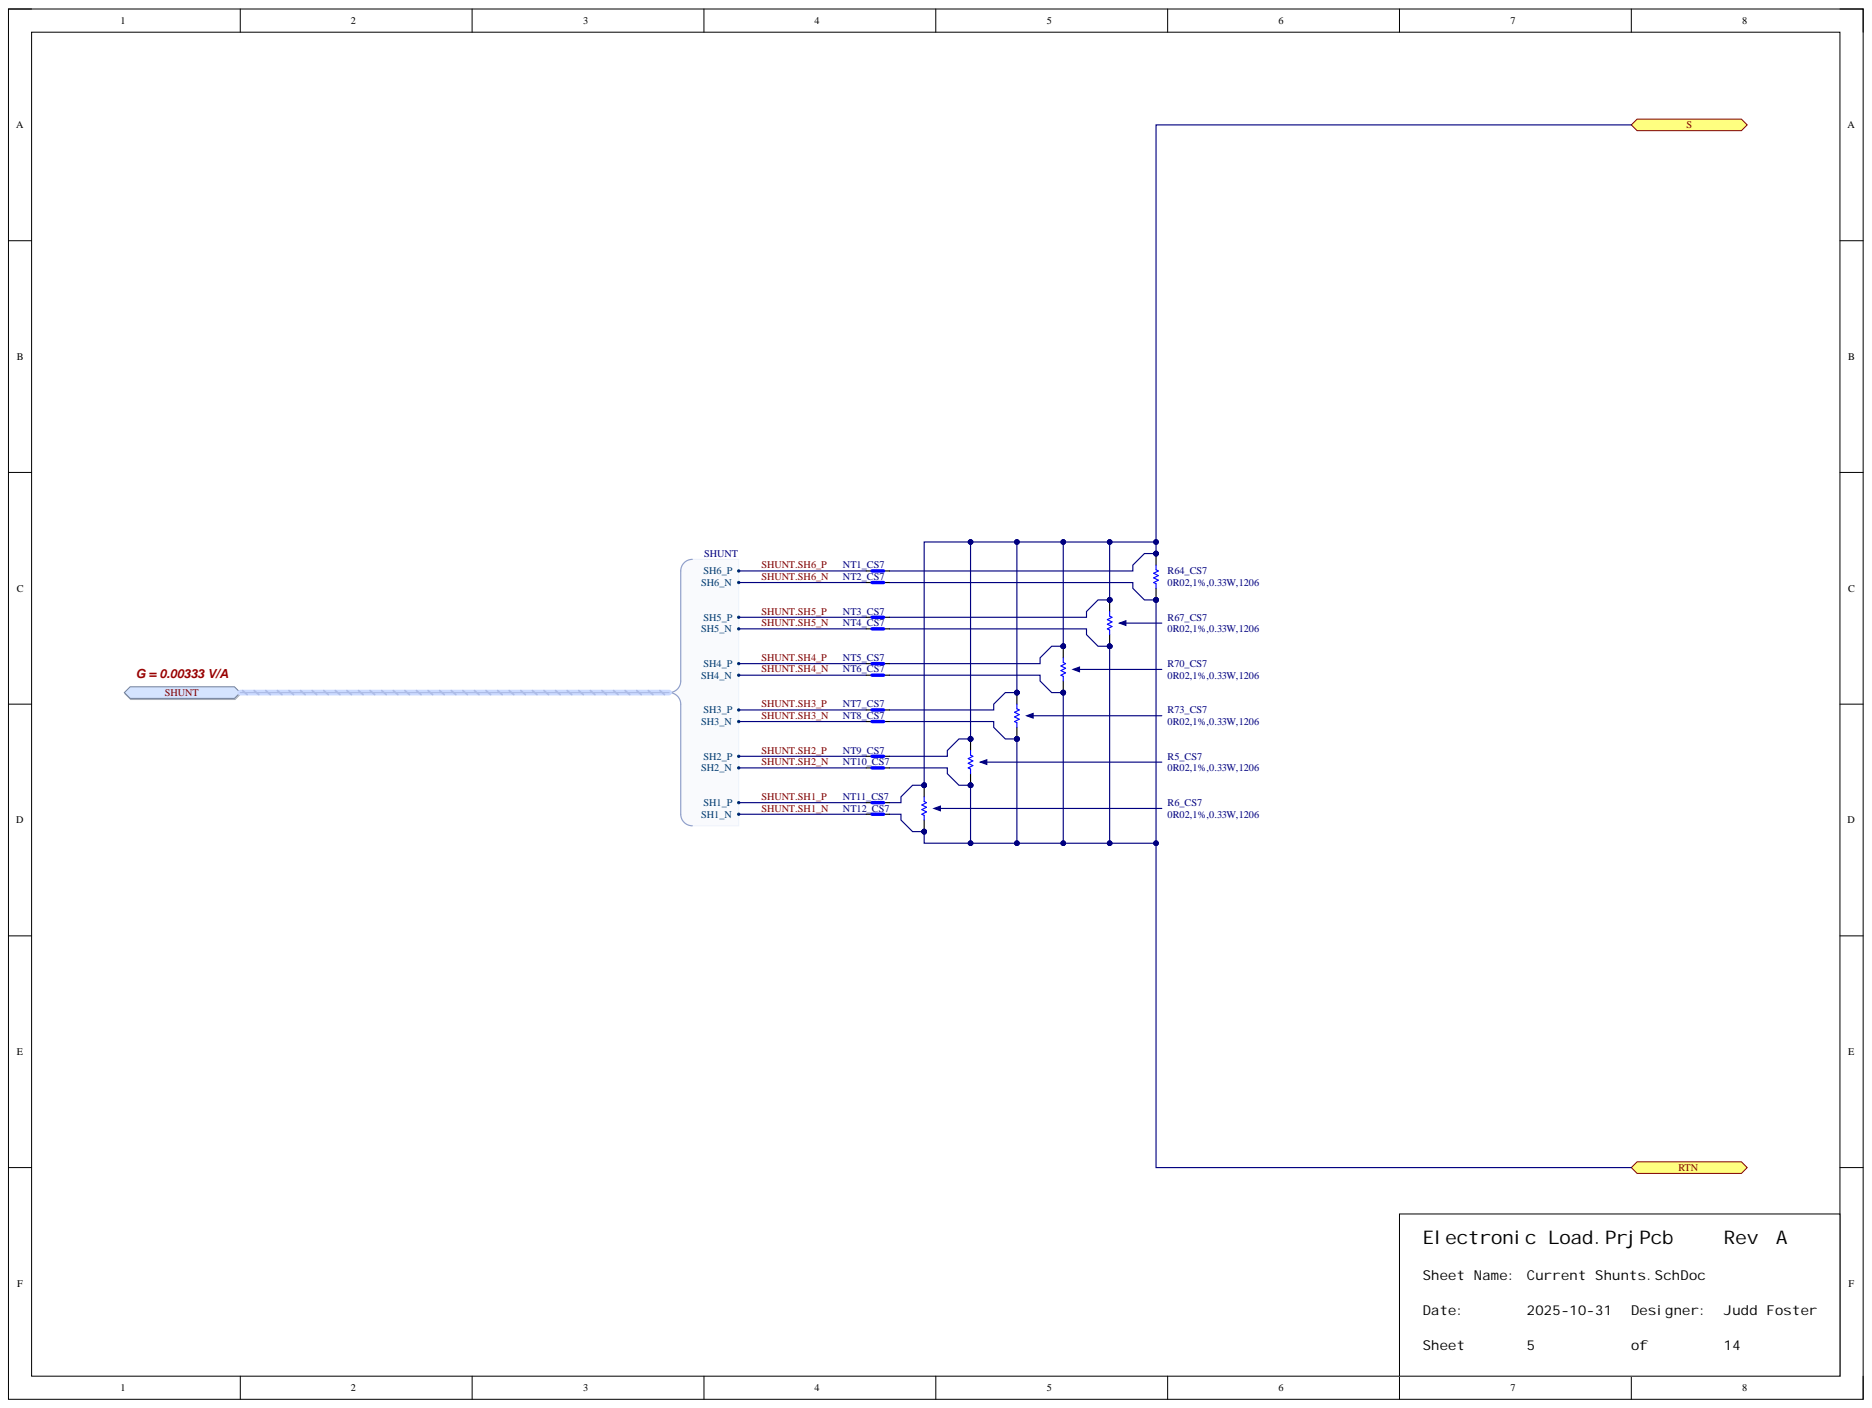
[picture p35: page 25]

Sheet Name: Current Shunts.SchDoc

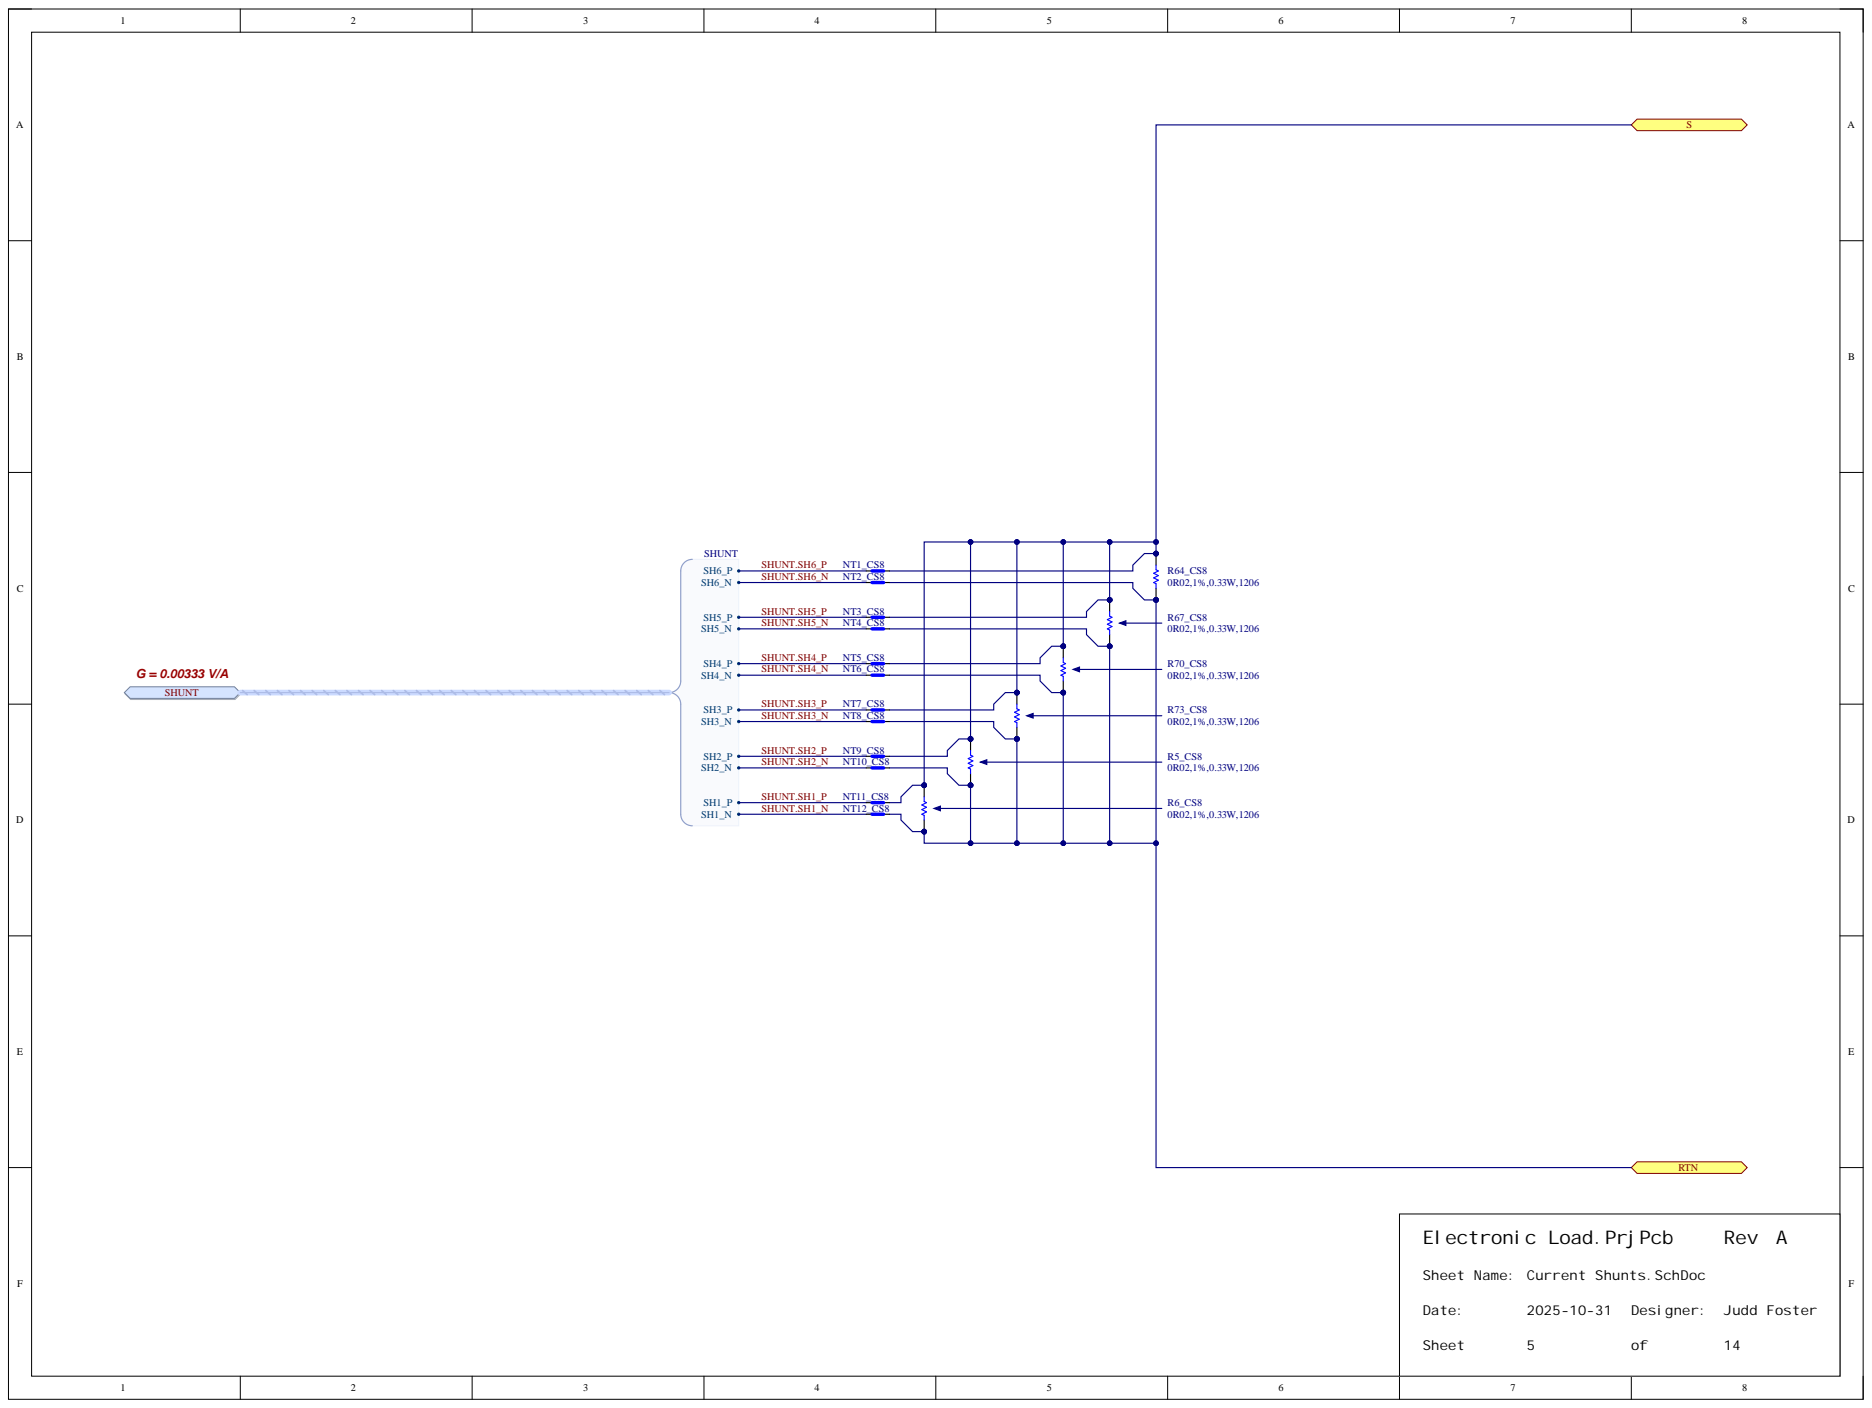
[picture p36: page 26]

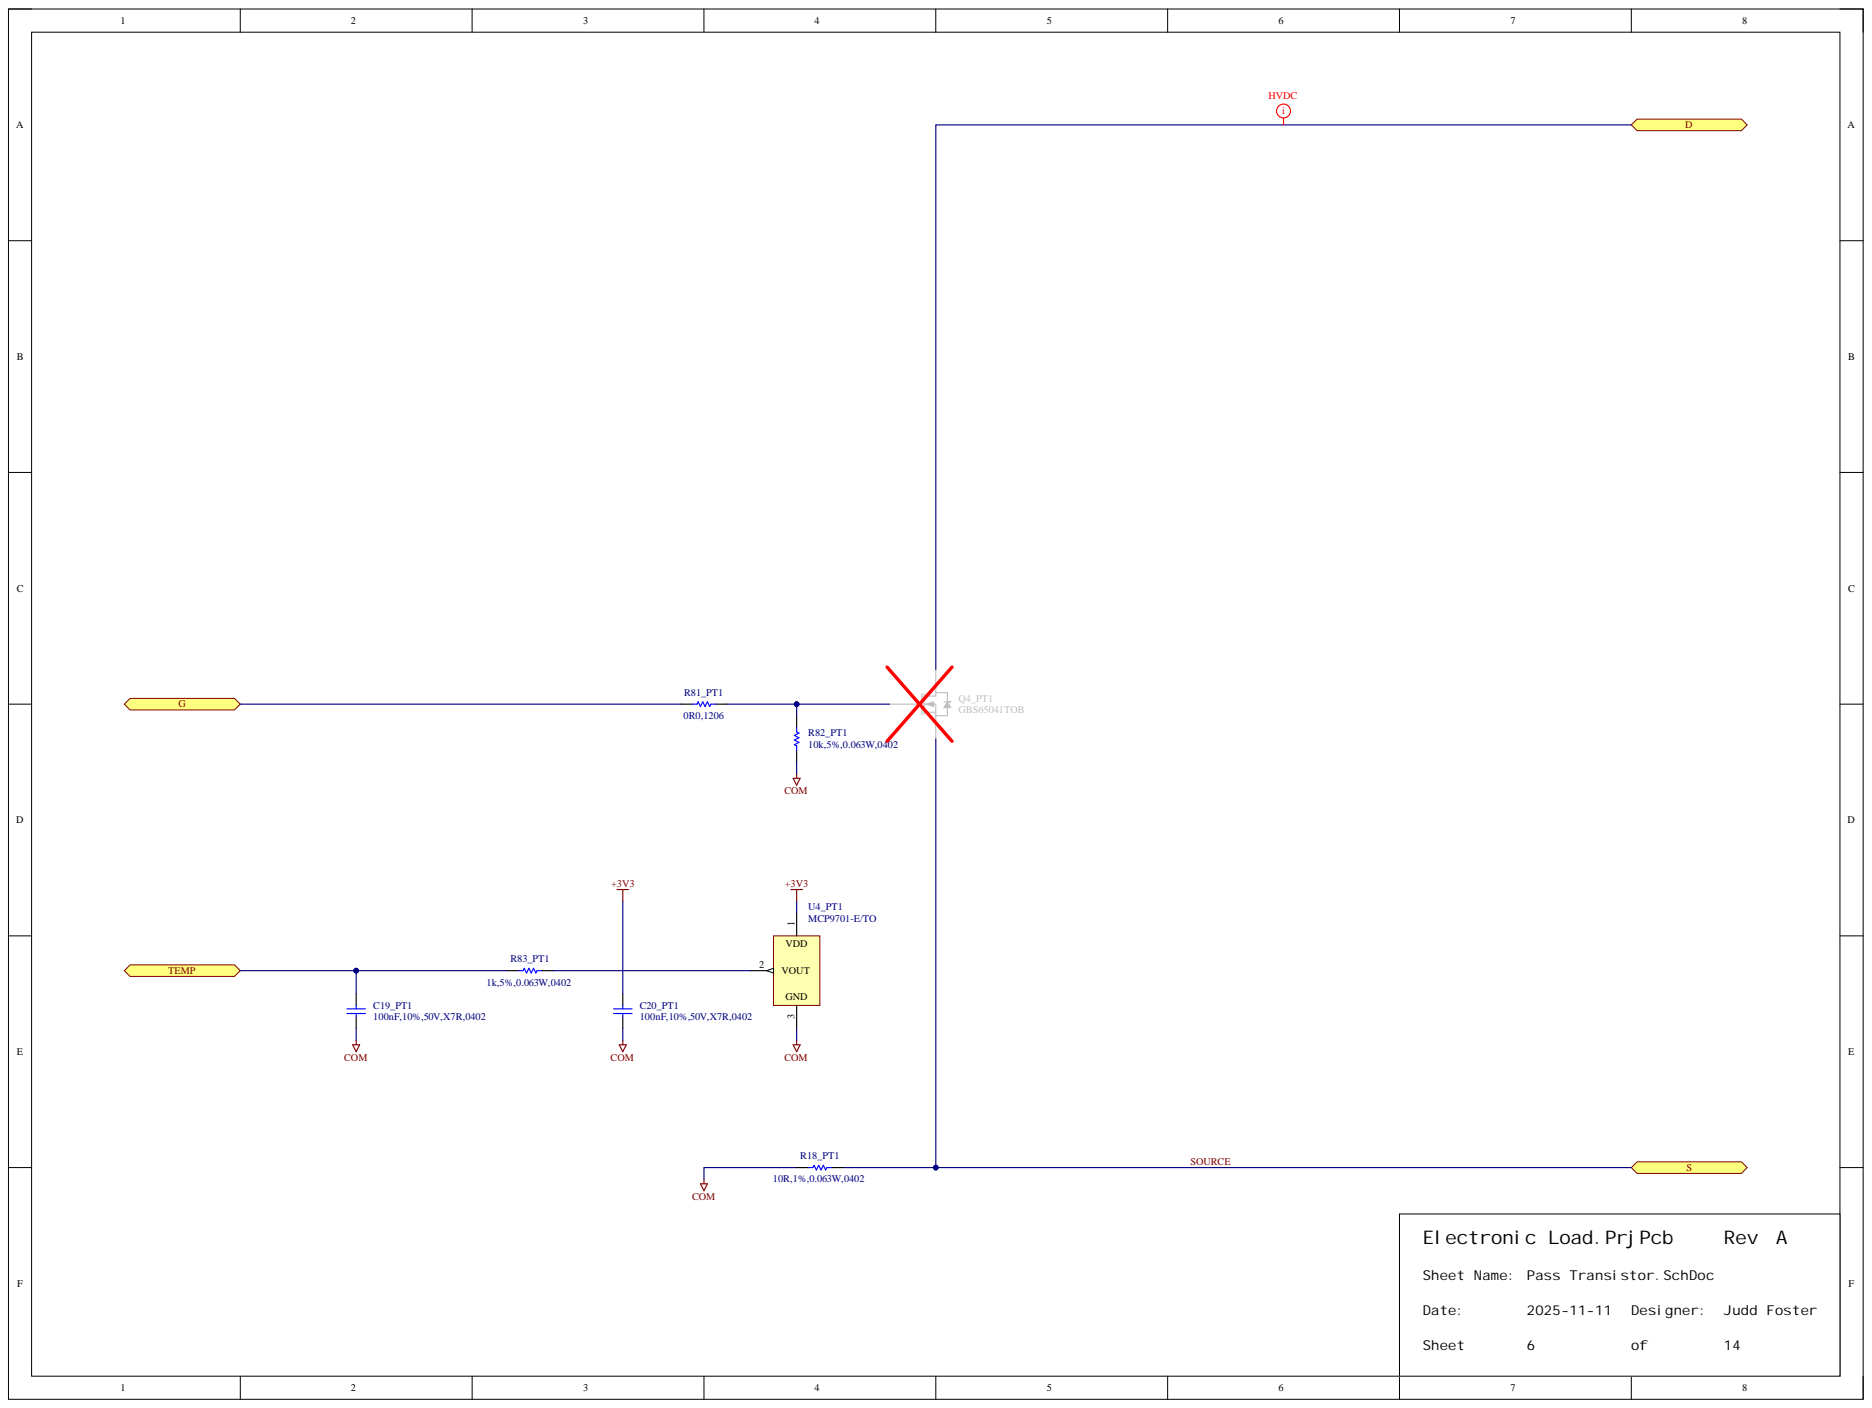
[picture p37: page 27]

Sheet Name: Pass Transistor.SchDoc

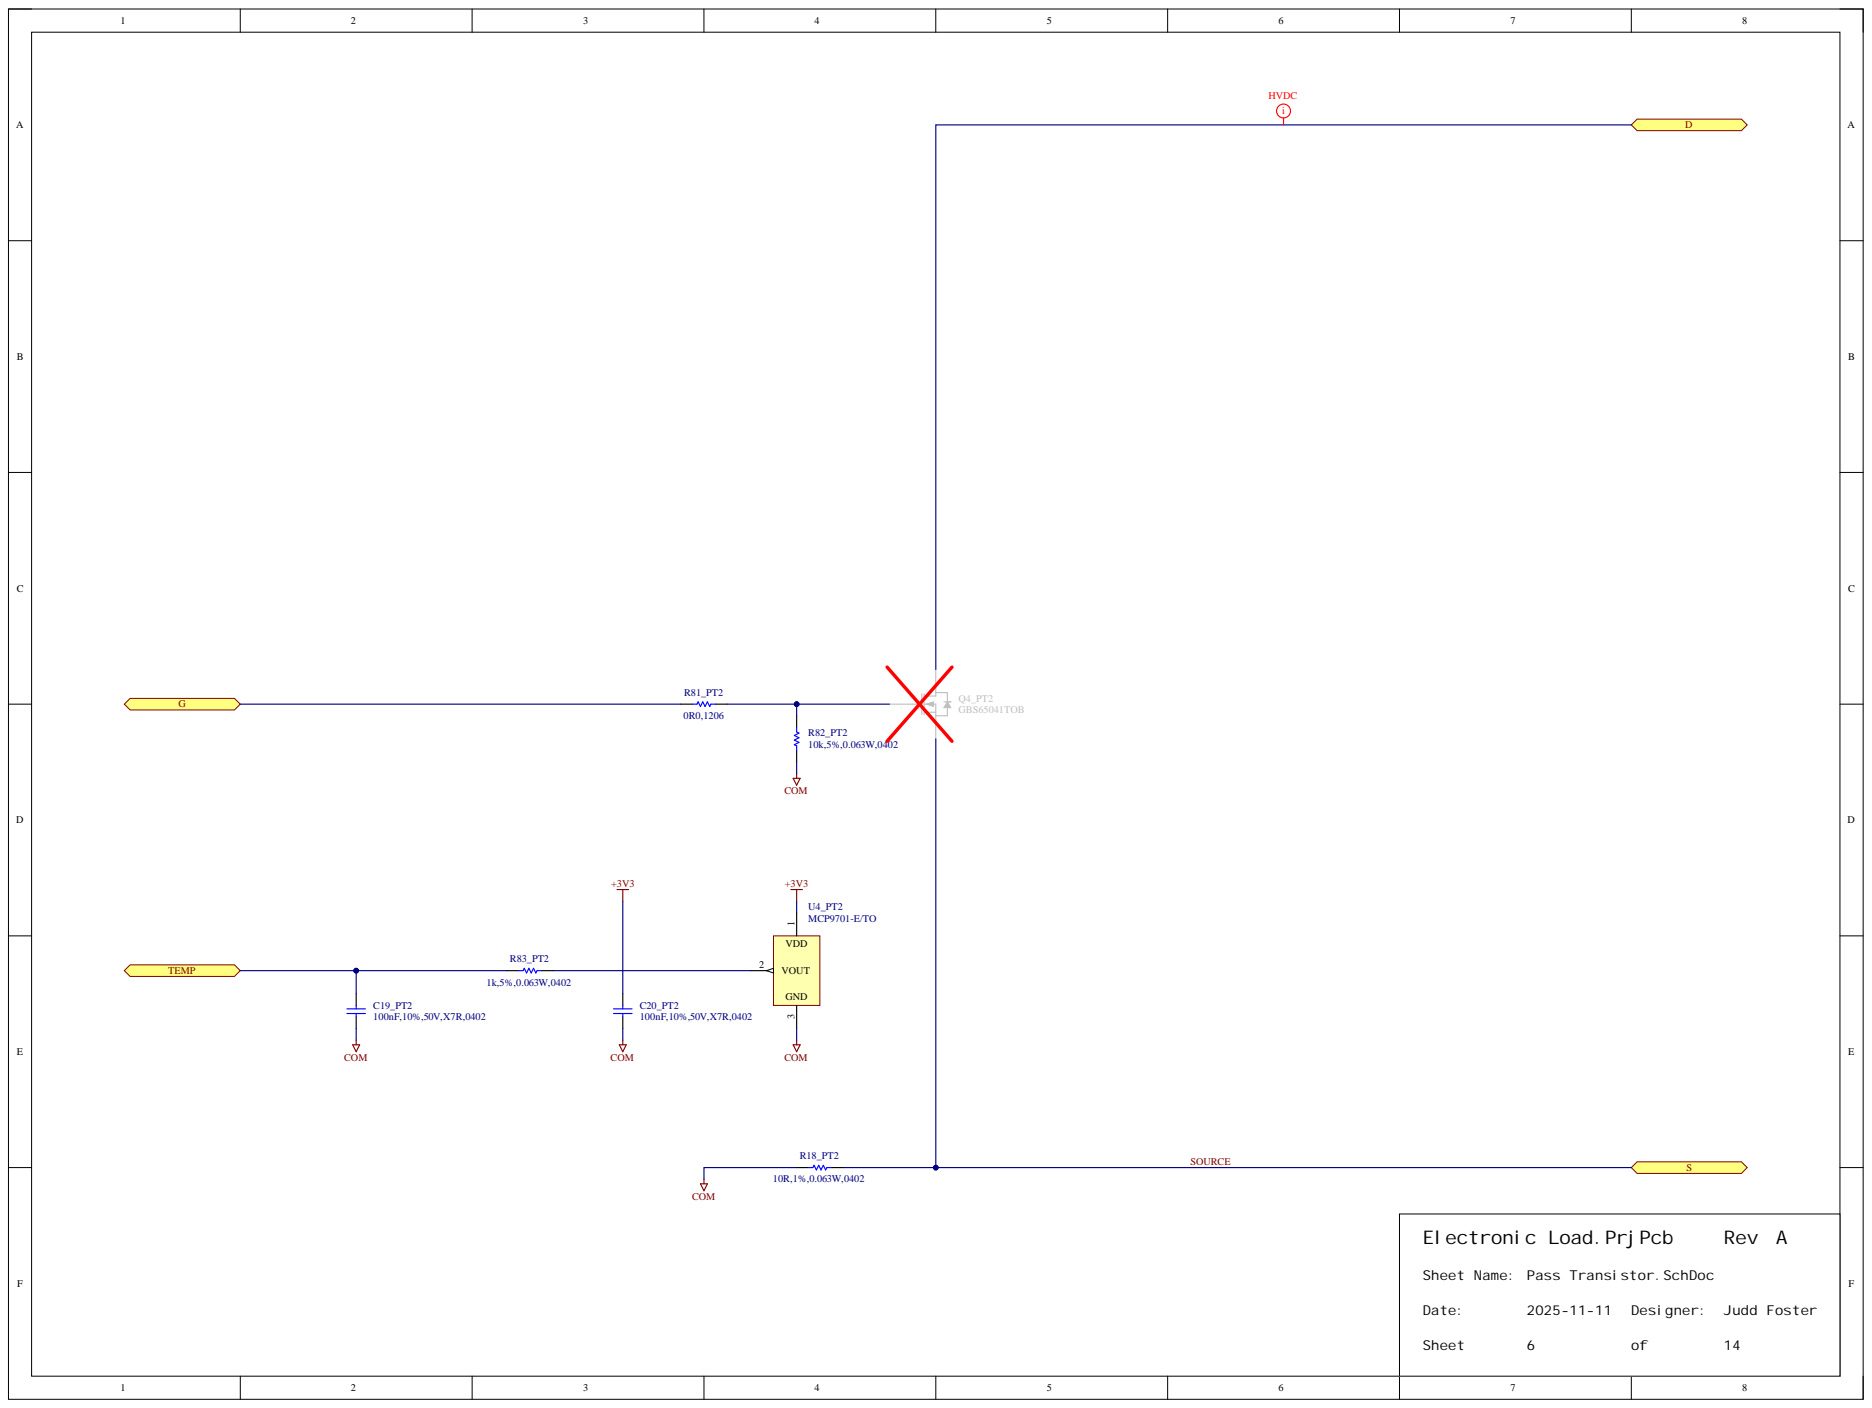
[picture p38: page 28]

Sheet Name: Pass Transistor.SchDoc

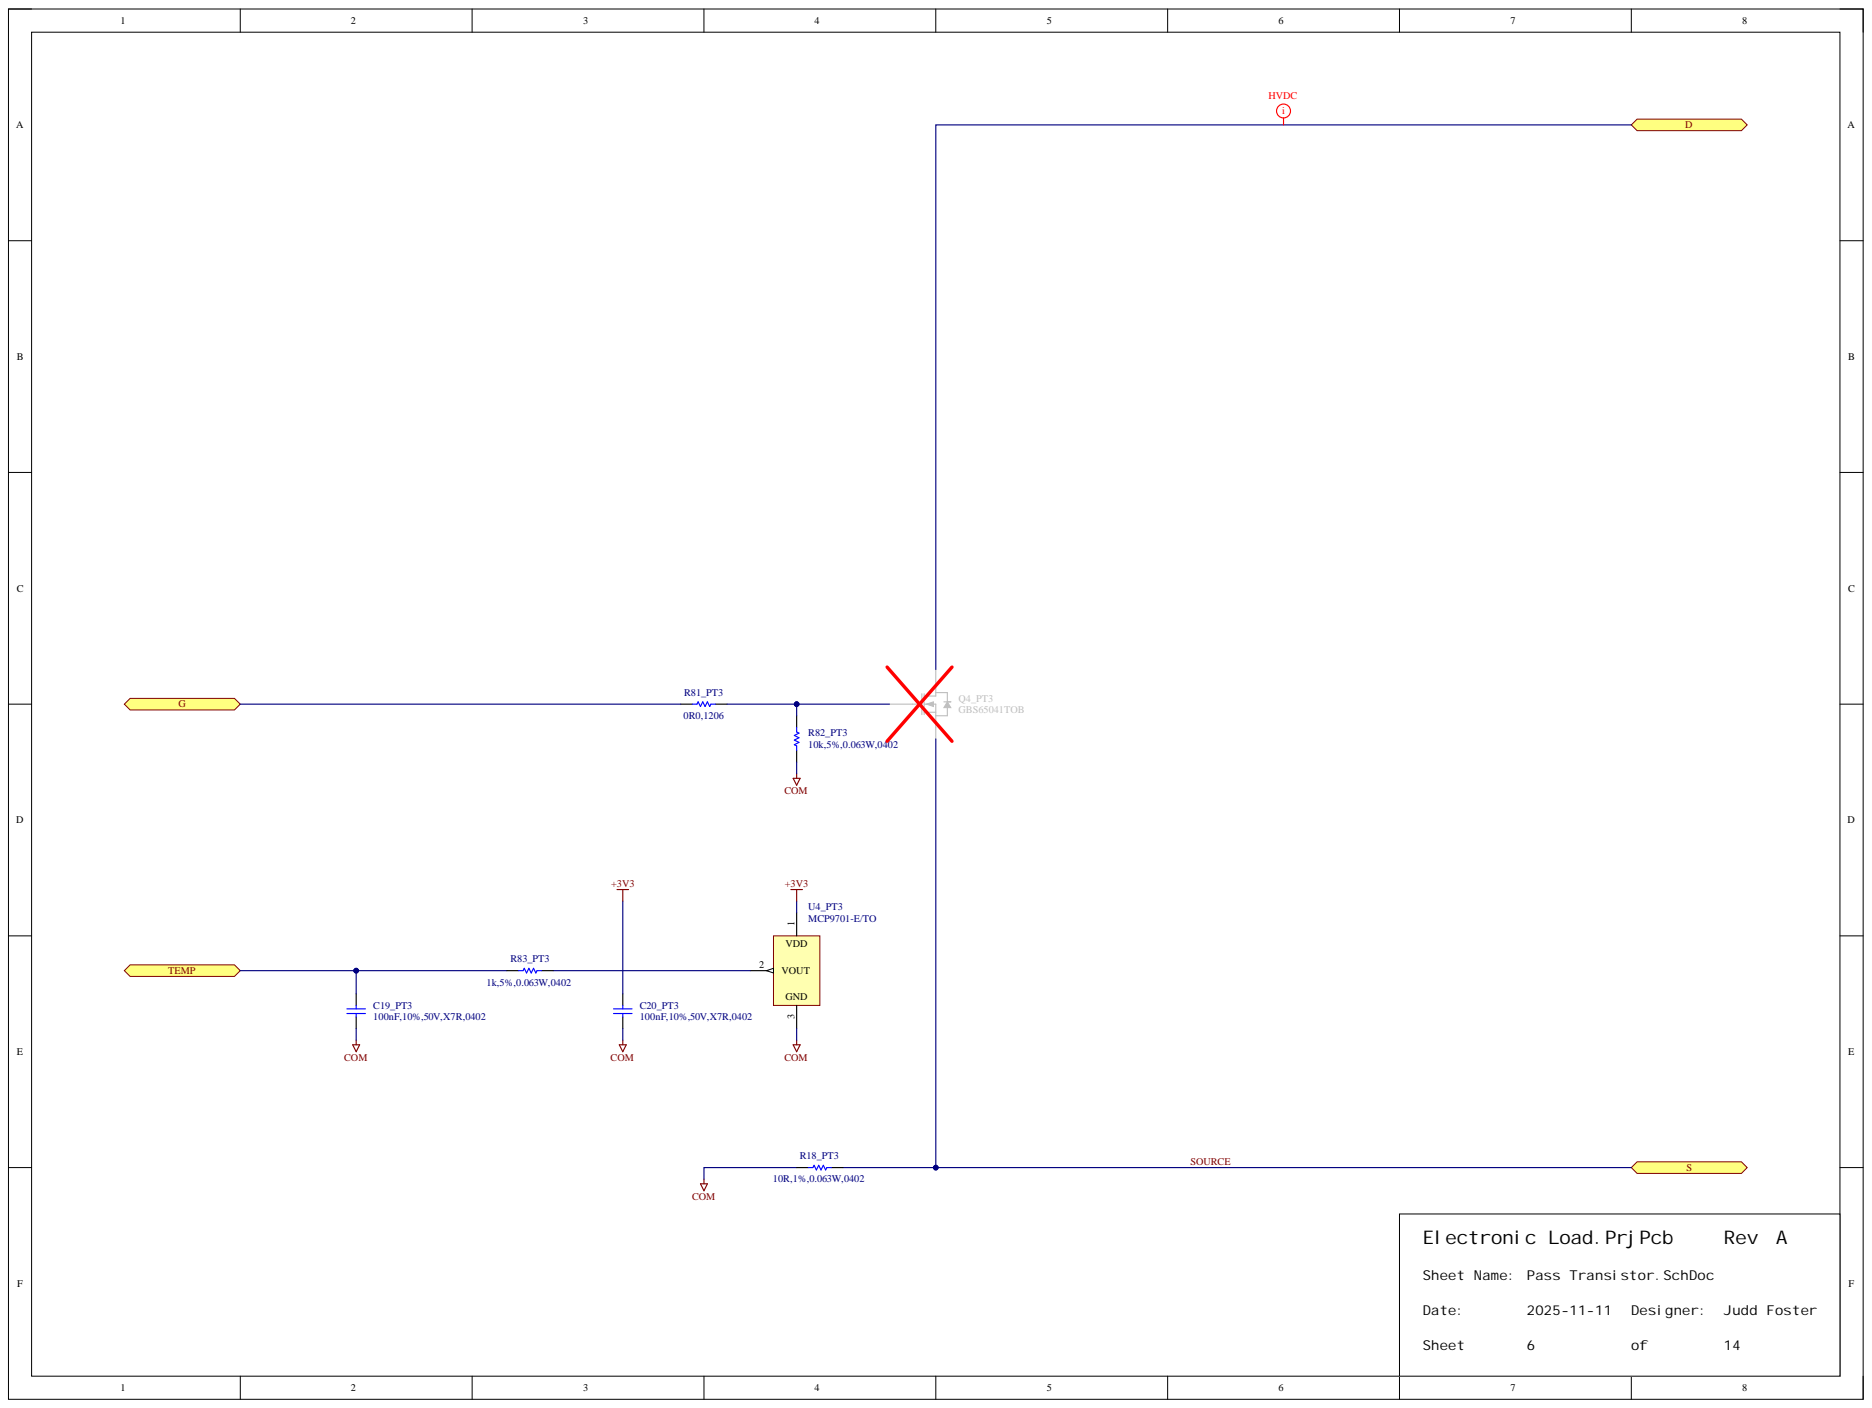
[picture p39: page 29]

Sheet Name: Pass Transistor.SchDoc

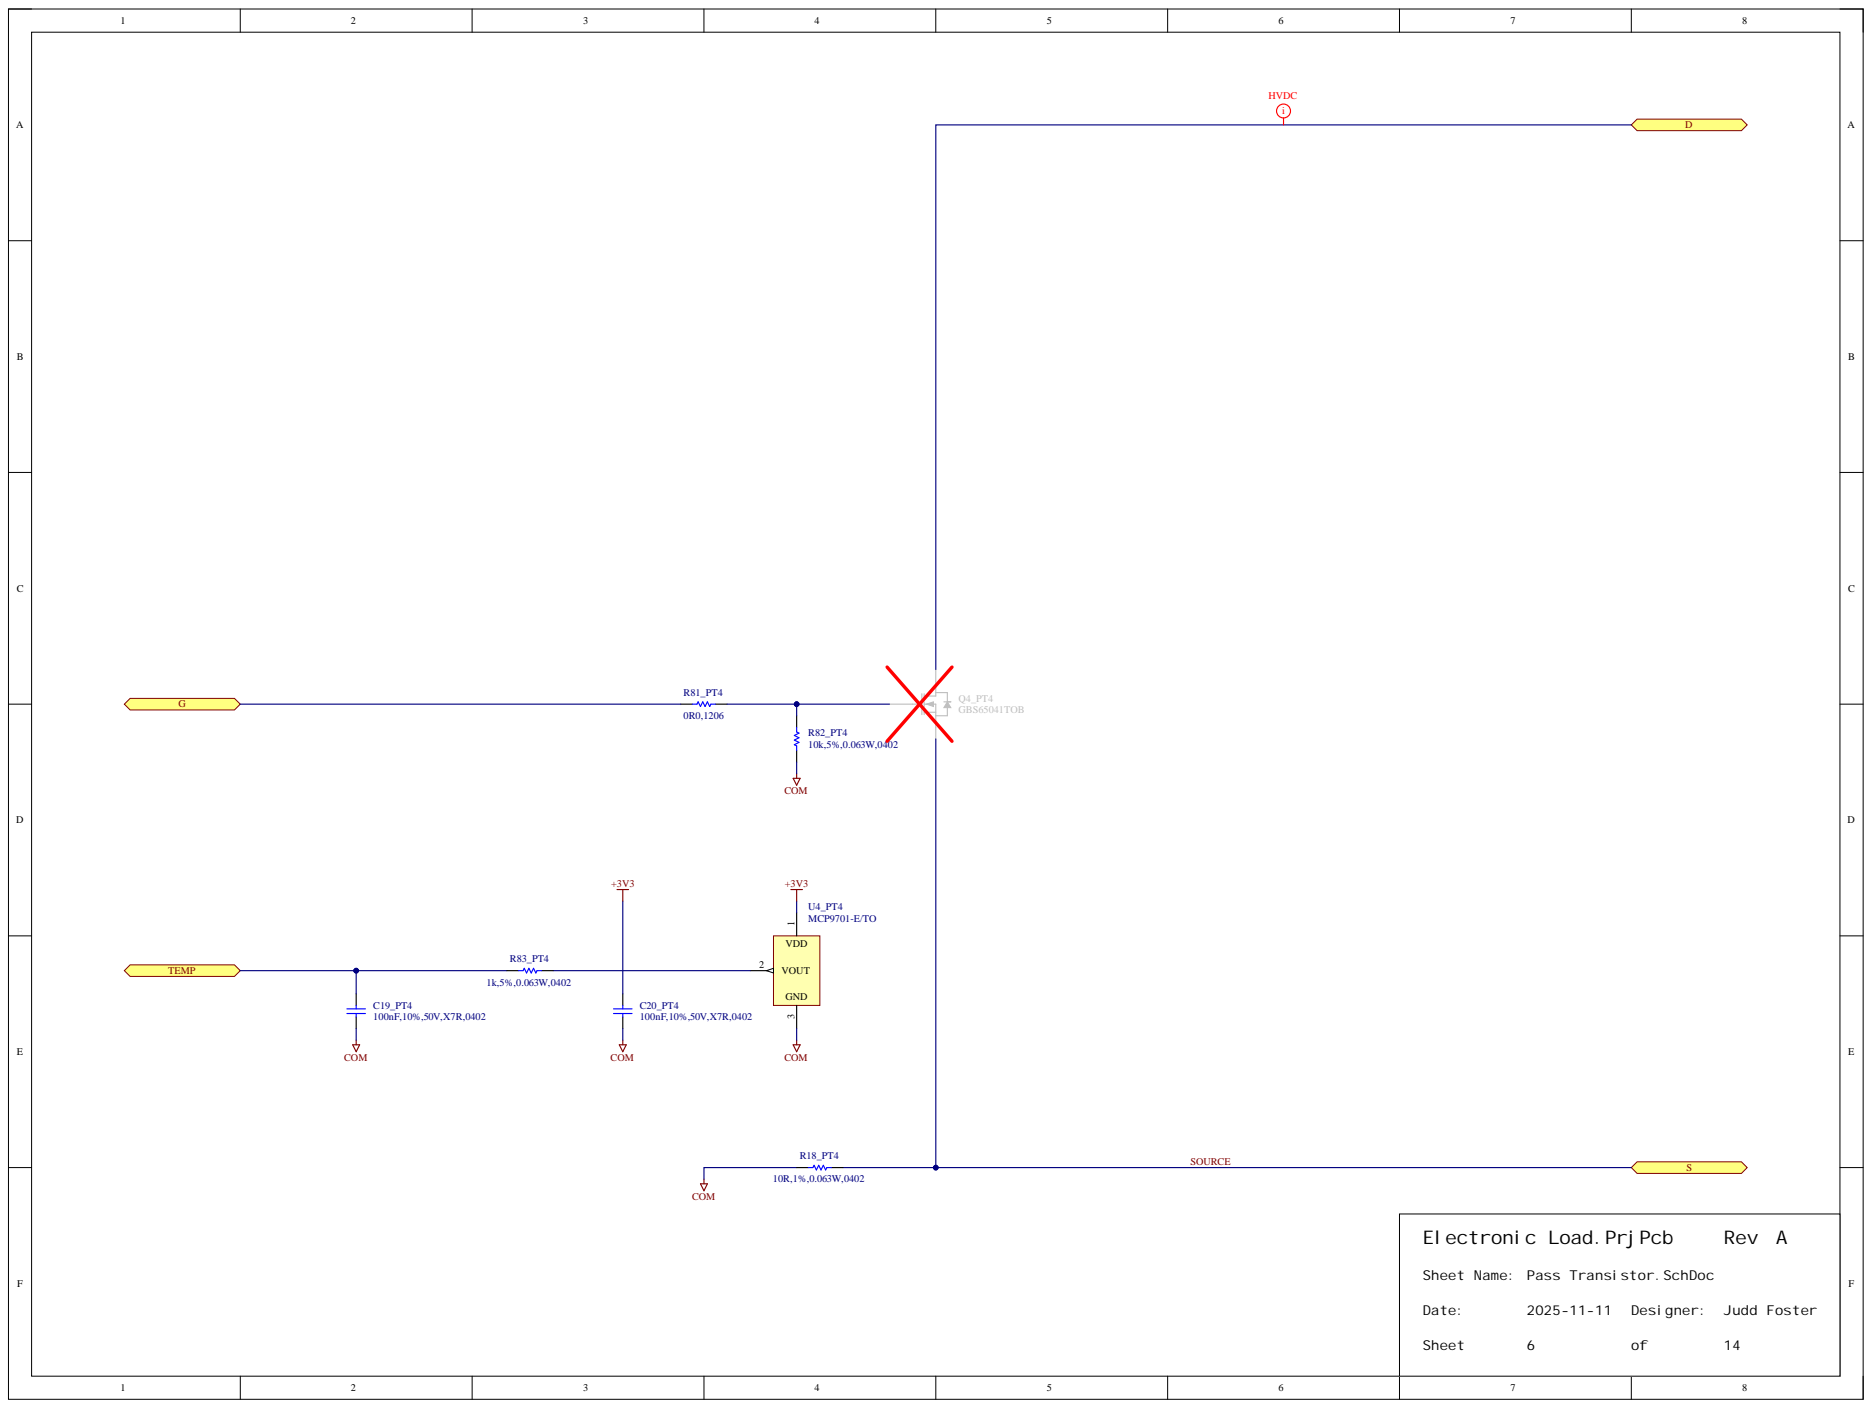
[picture p40: page 30]

Sheet Name: Pass Transistor.SchDoc

Sheet Name: Pass Transistor.SchDoc

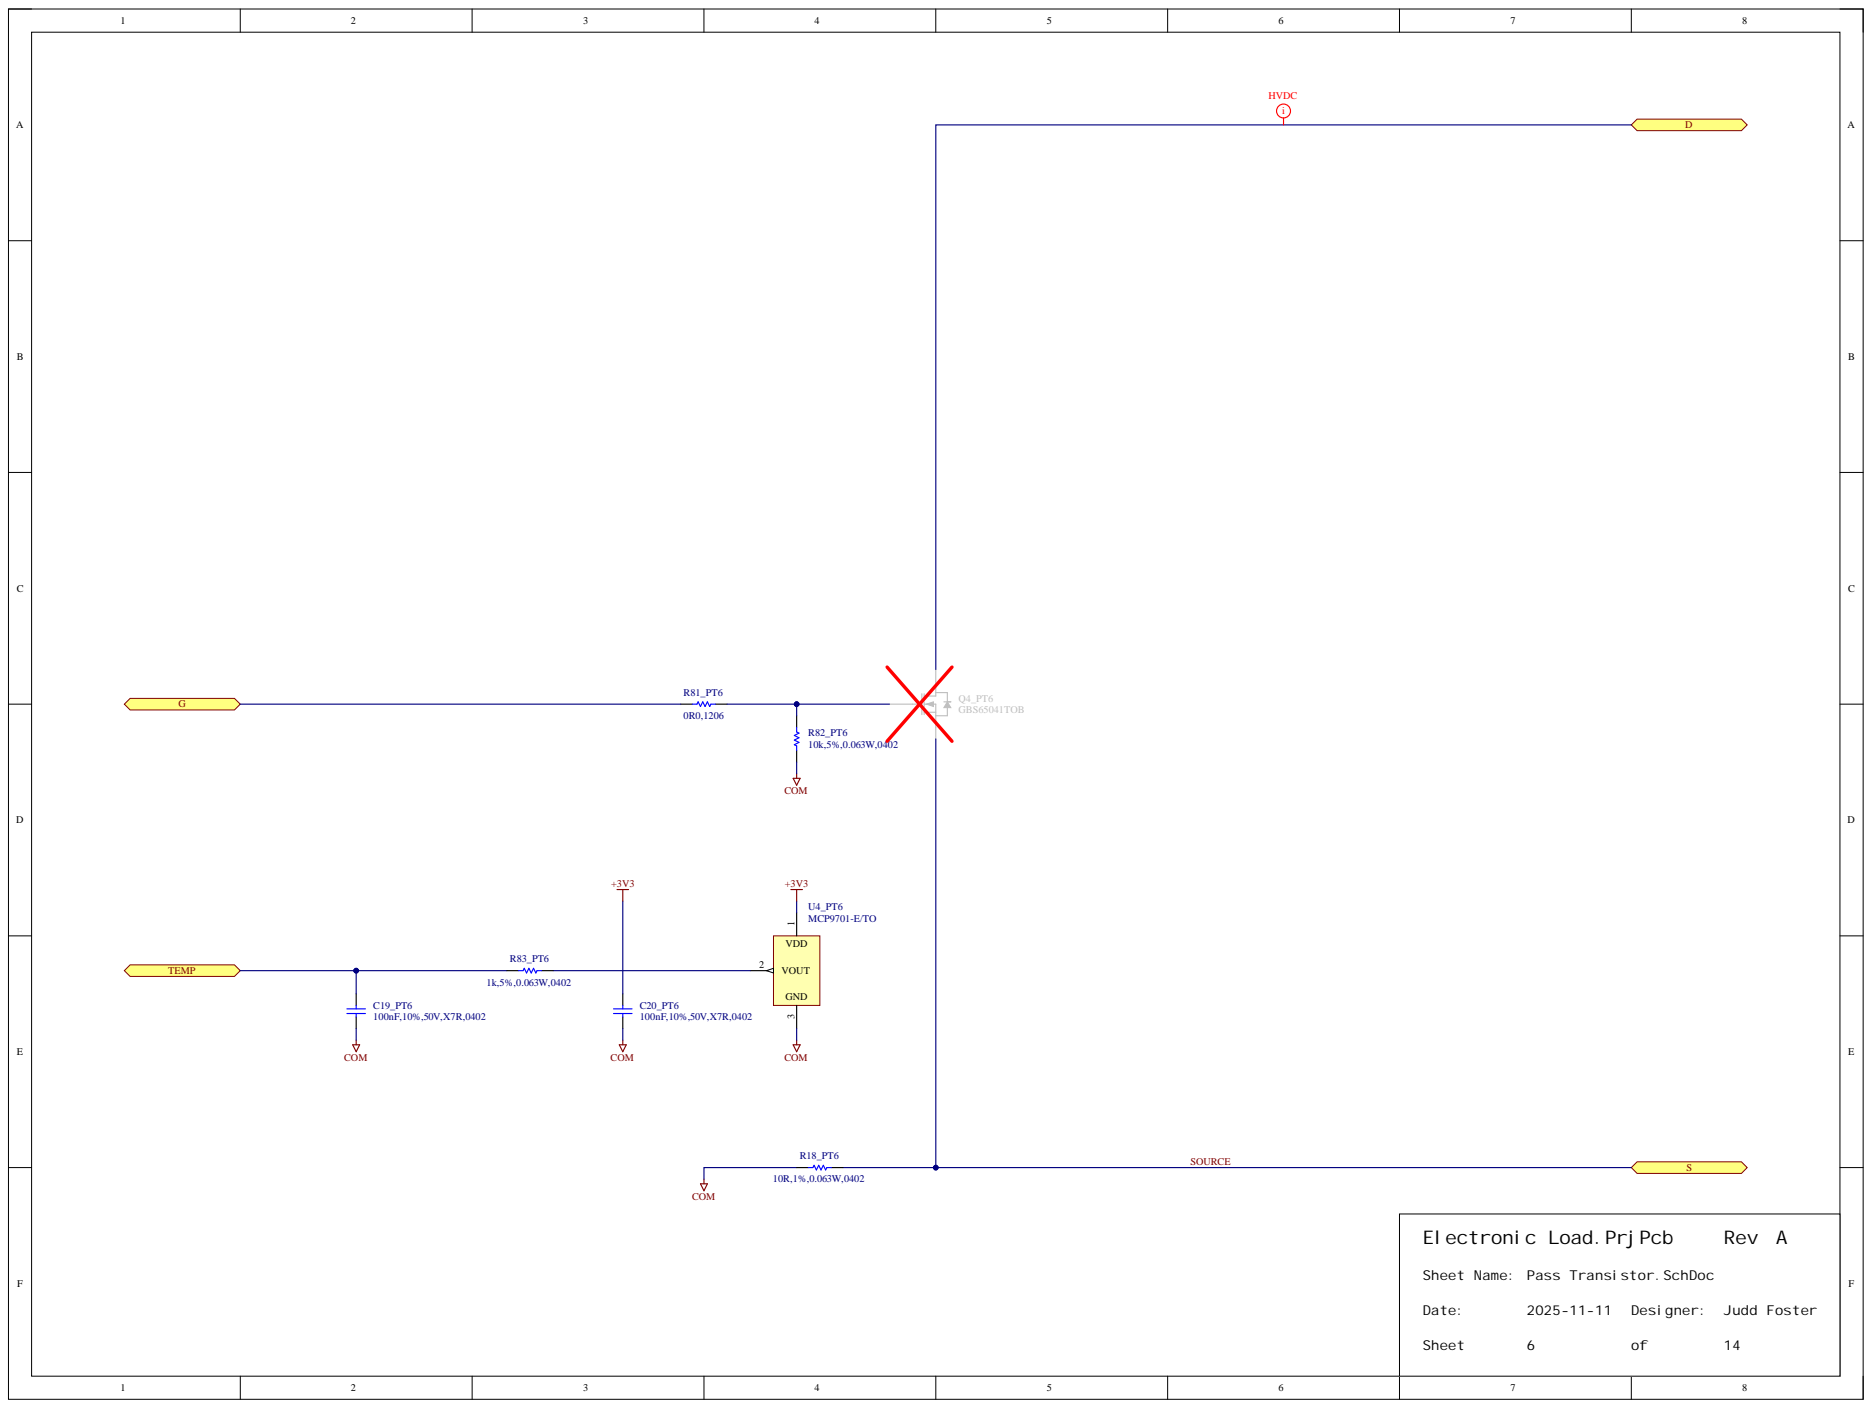
[picture p41: page 32]

Sheet Name: Pass Transistor.SchDoc

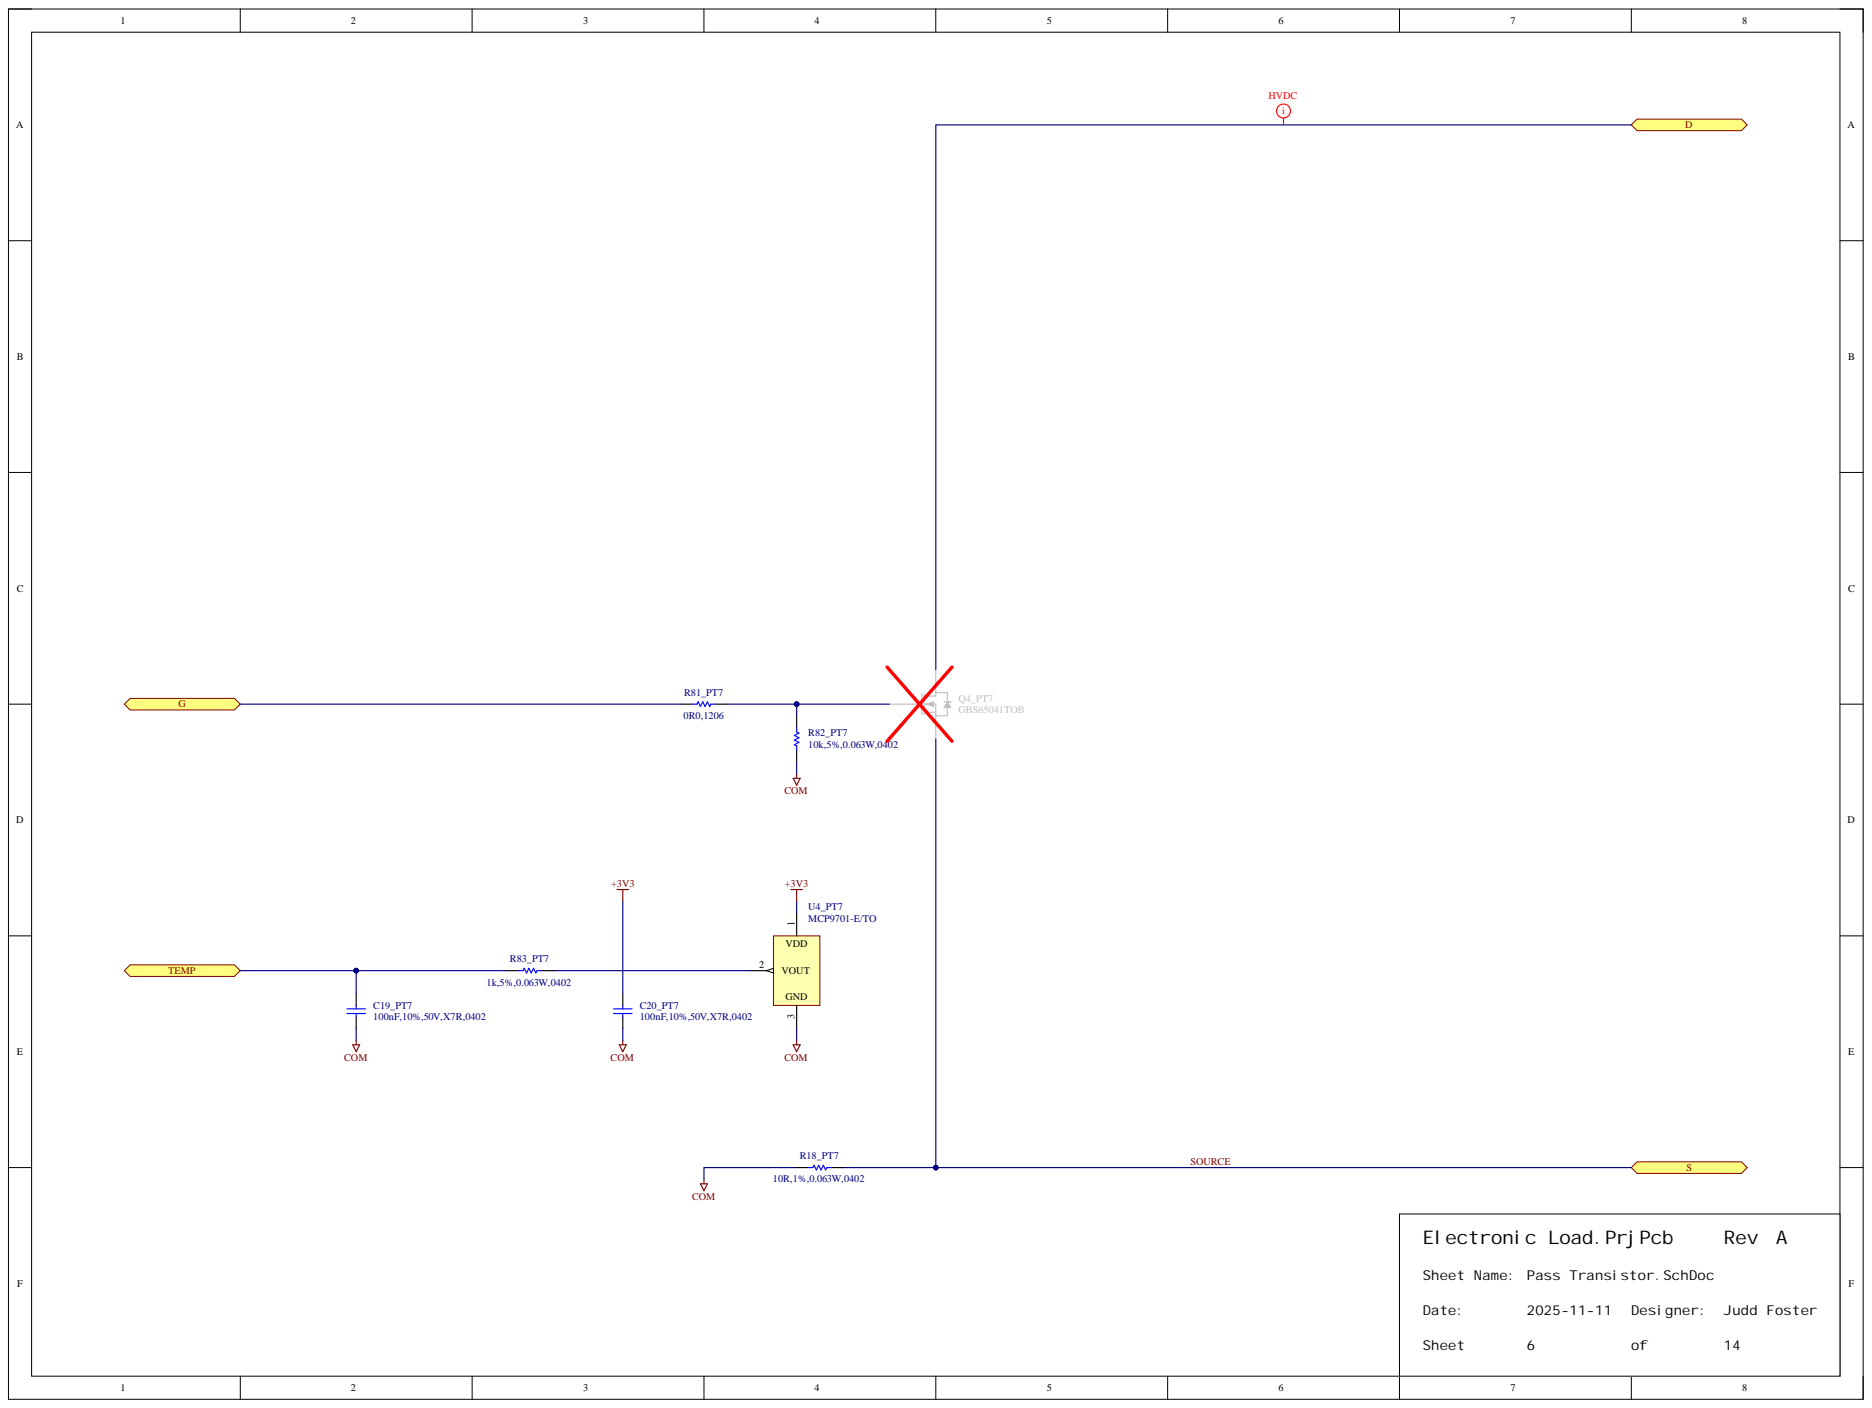
[picture p42: page 33]

Sheet Name: Pass Transistor.SchDoc

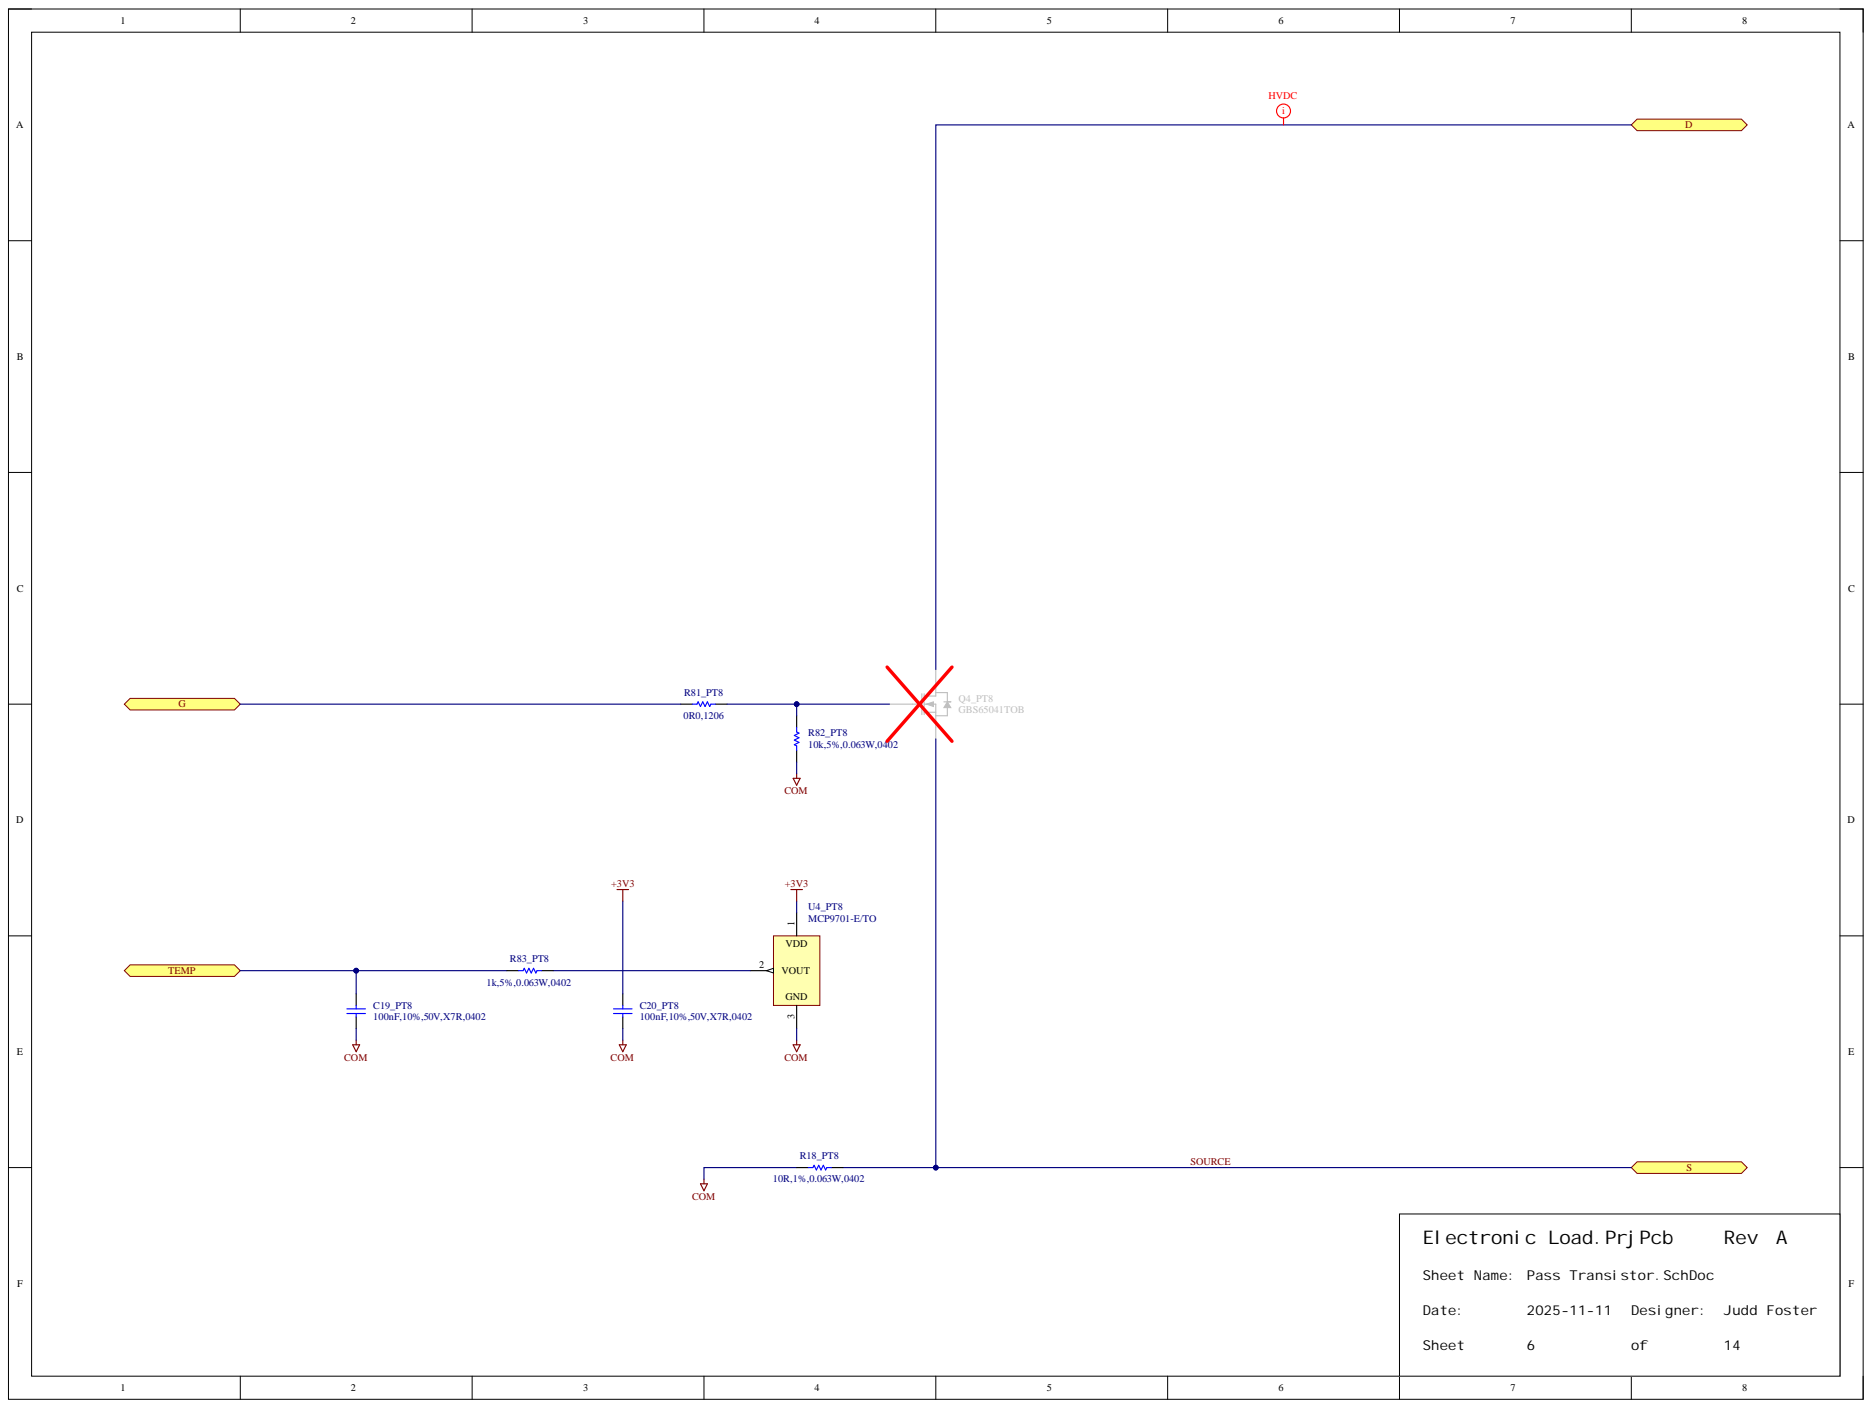
[picture p43: page 34]

Sheet Name: Pass Transistor.SchDoc

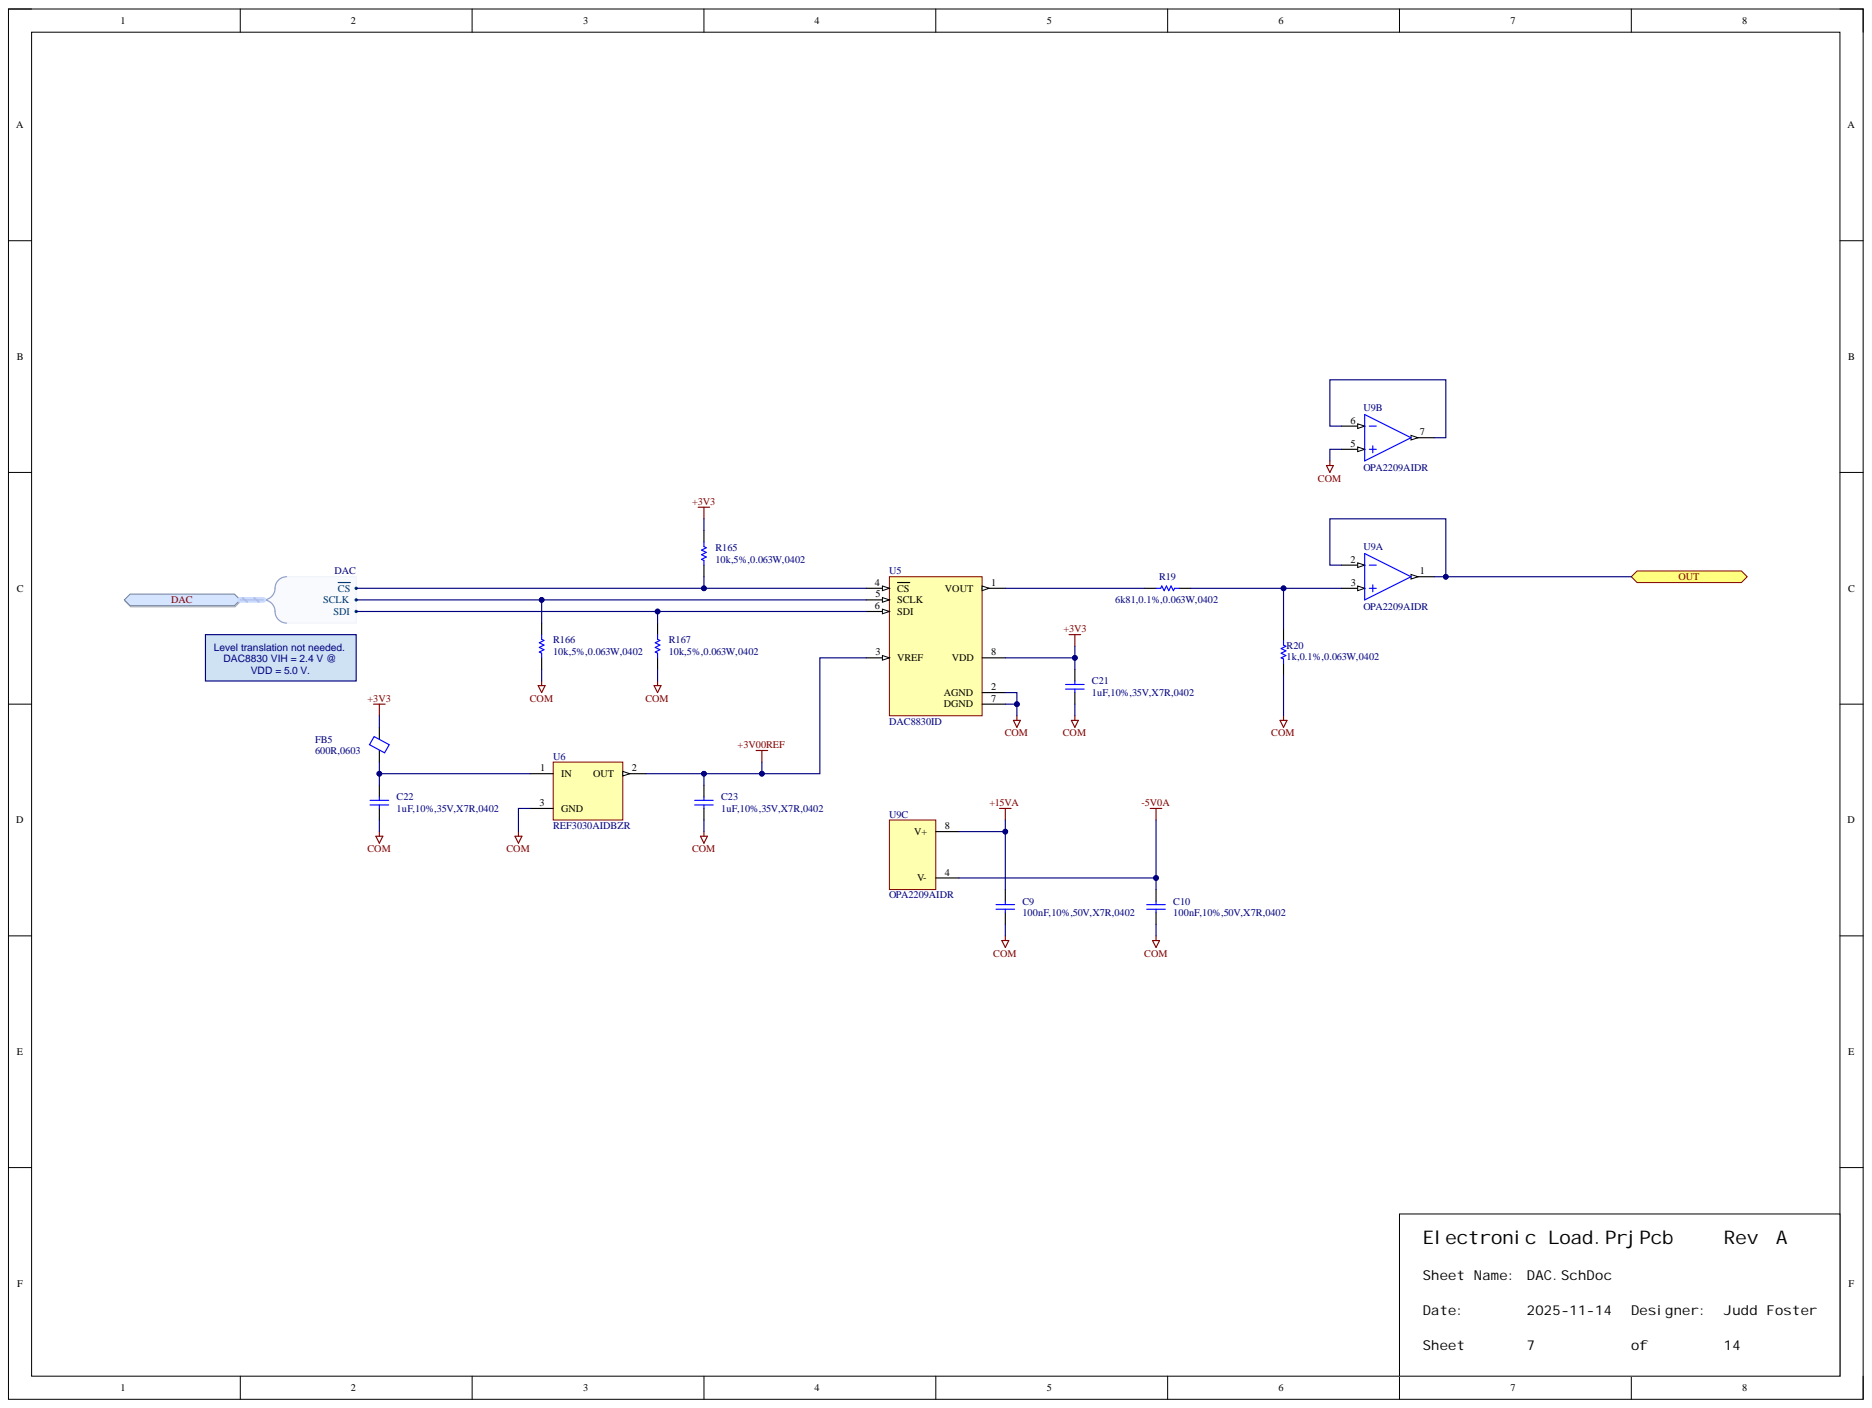
[picture p44: page 35]

Level translation not needed.
DAC8830 VIH = 2.4 V @
VDD = 5.0 V

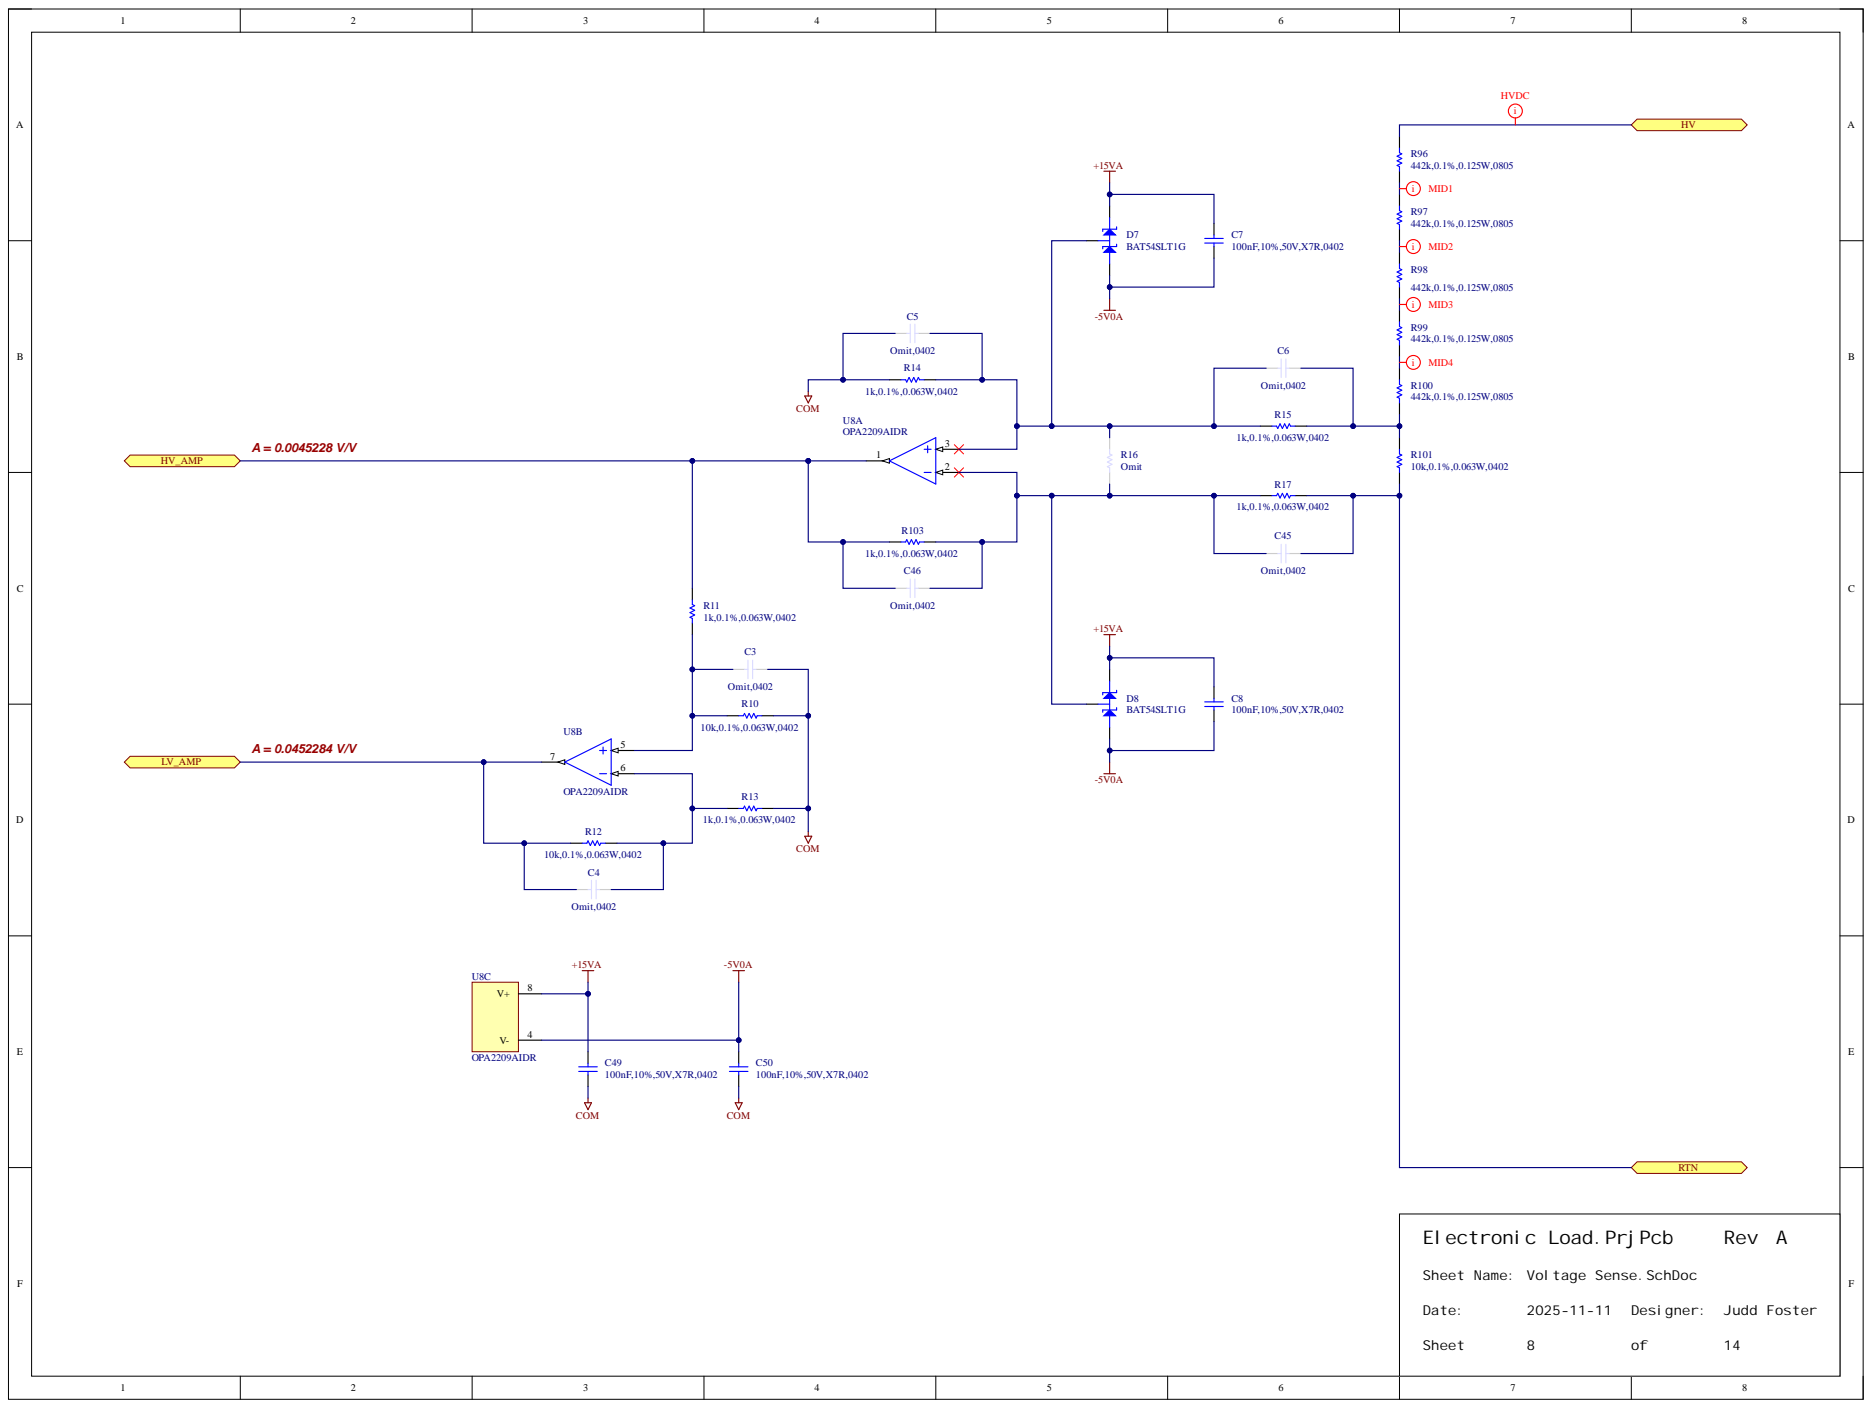
[picture p45: page 36]

Sheet Name: Voltage Sense.SchDoc

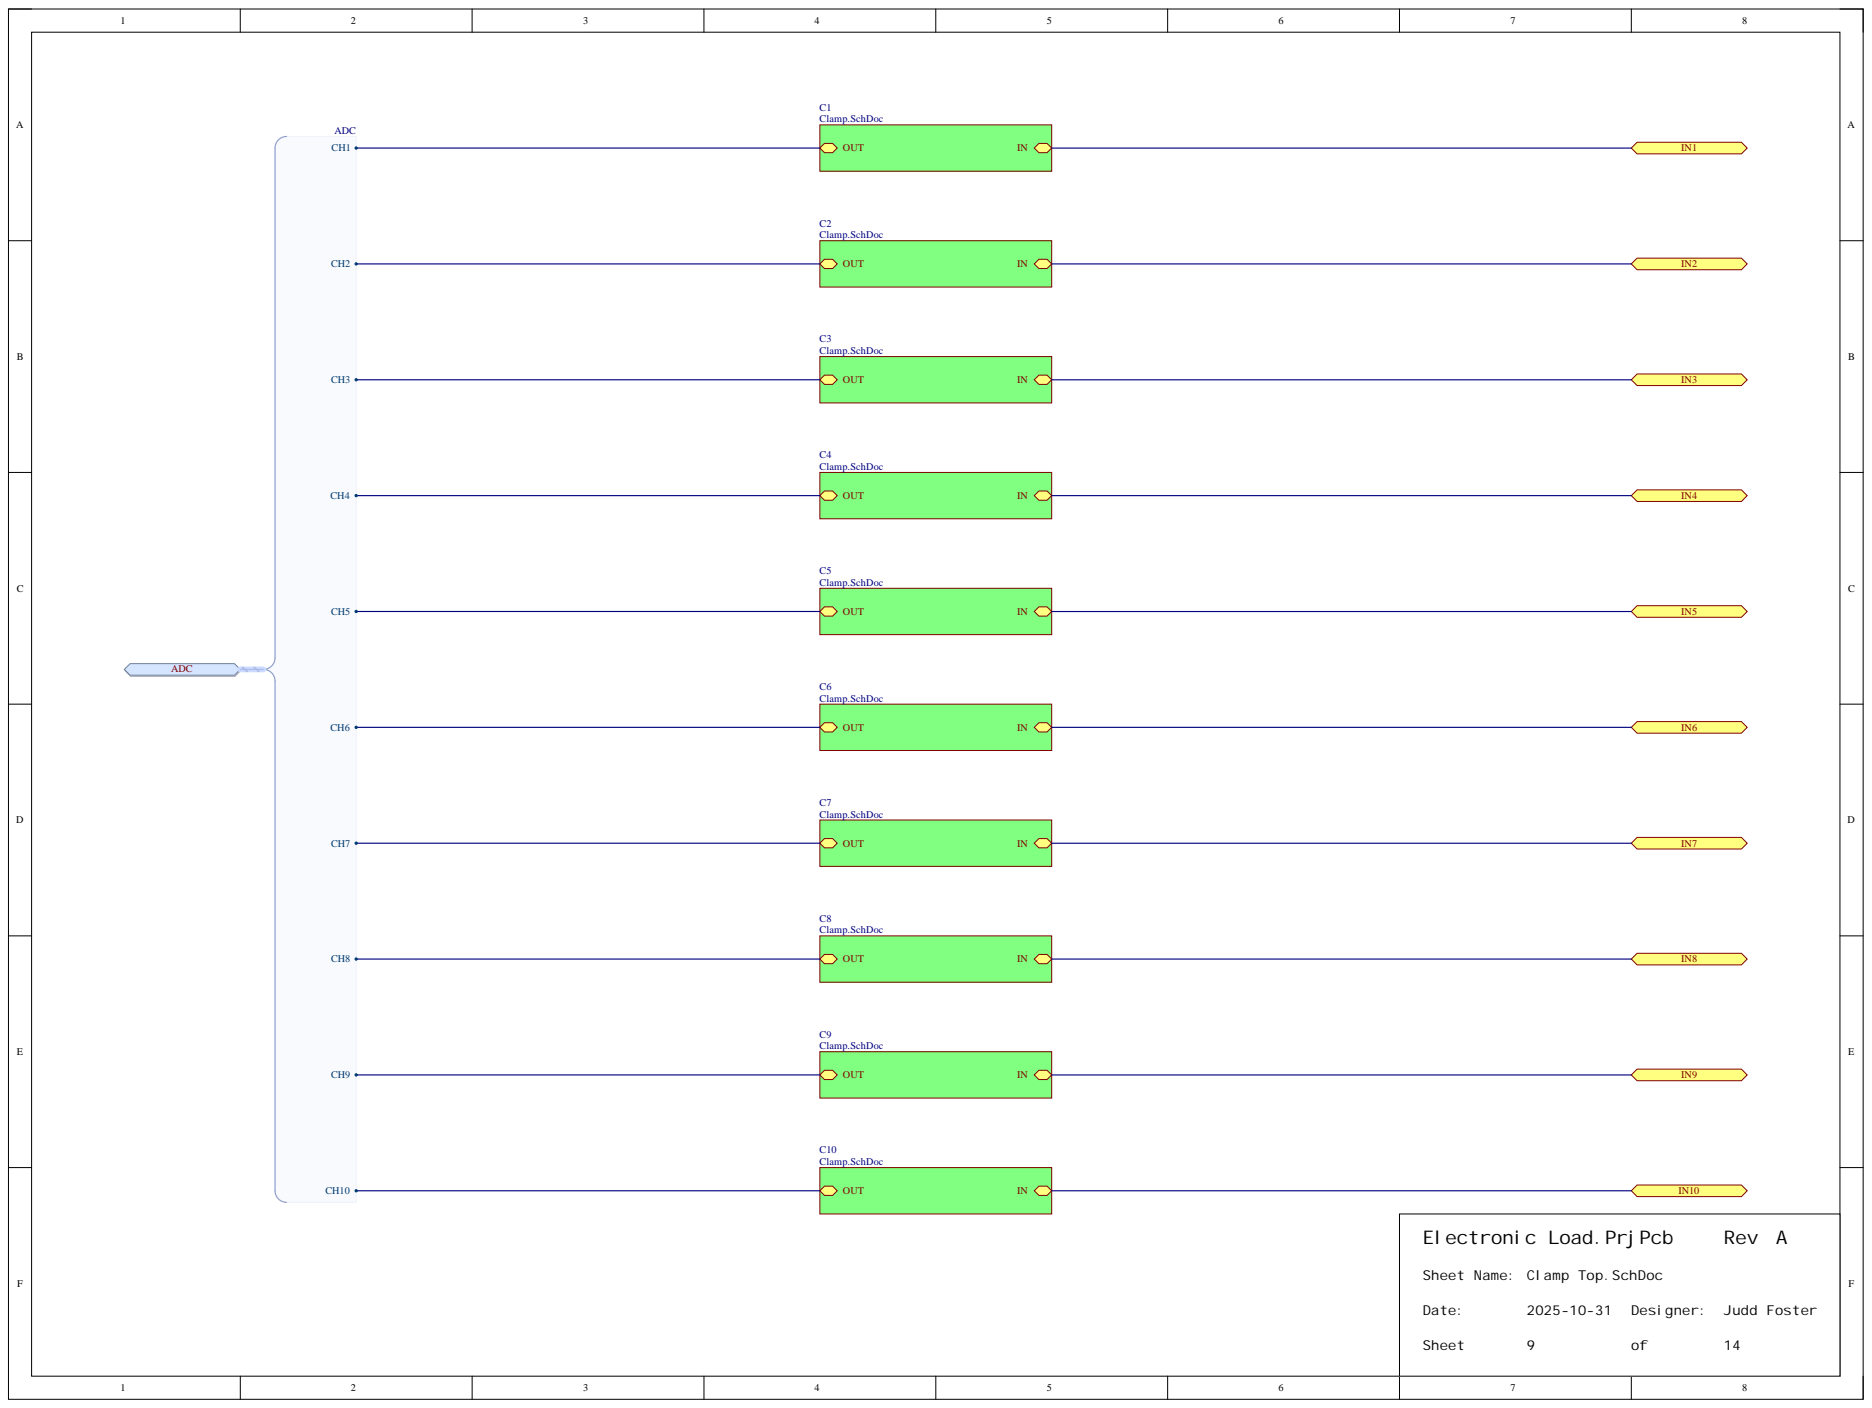
[picture p46: page 37]

Sheet Name: Clamp Top.SchDoc

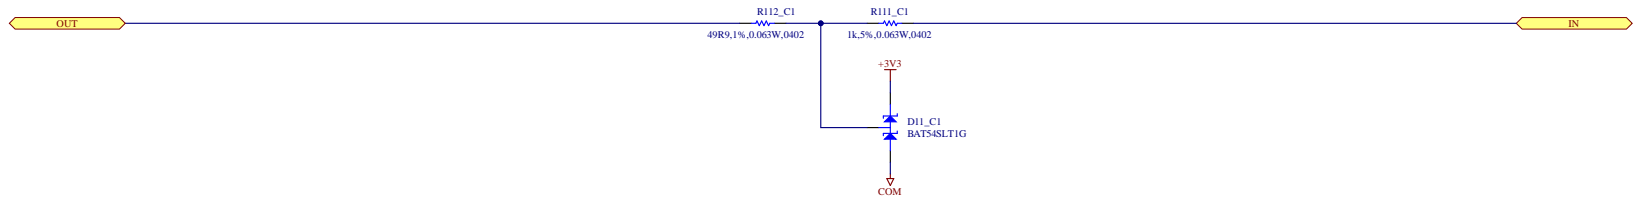
[picture p47: page 38]

Sheet Name: Clamp.SchDoc

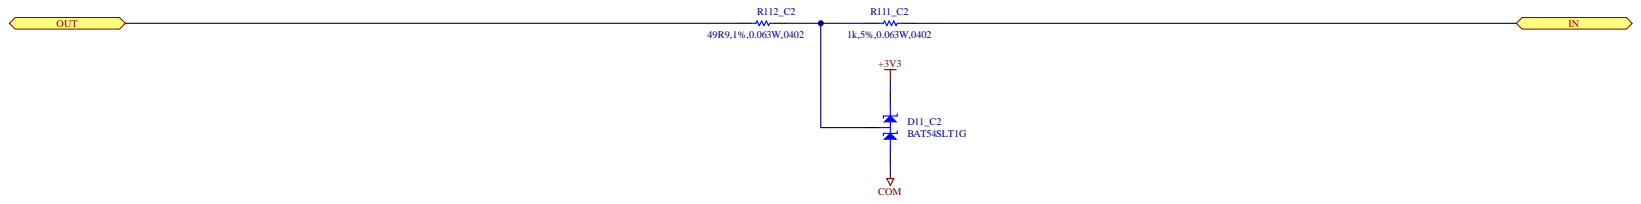
[picture p48: page 39]

Sheet Name: Clamp.SchDoc

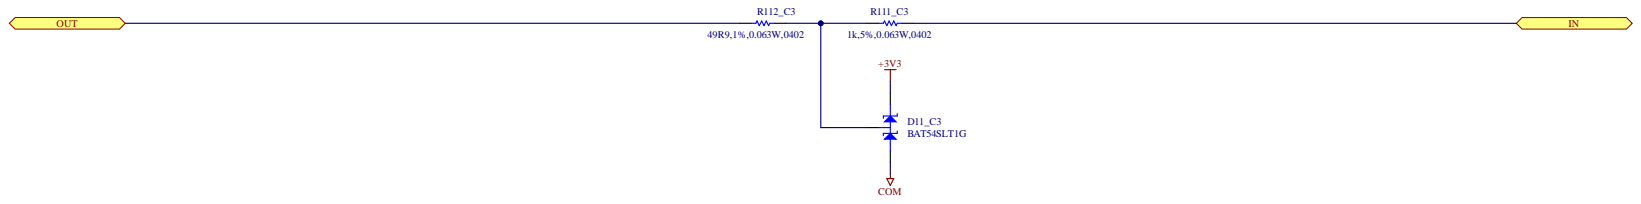
[picture p49: page 40]

Sheet Name: Clamp.SchDoc

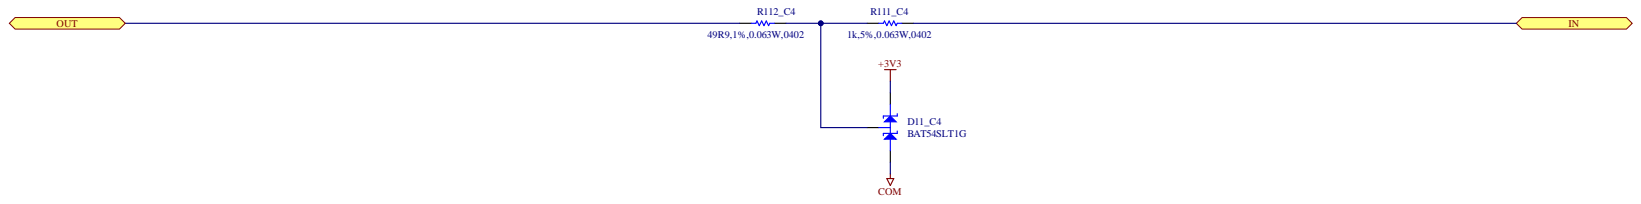
[picture p50: page 41]

Sheet Name: Clamp.SchDoc

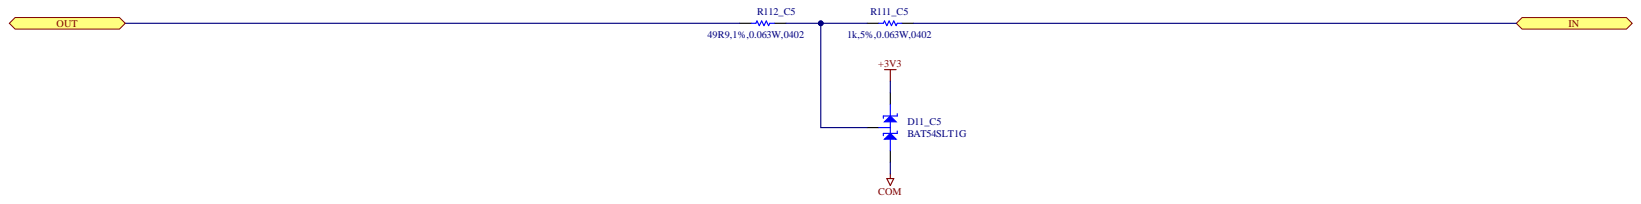
[picture p51: page 42]

Sheet Name: Clamp.SchDoc

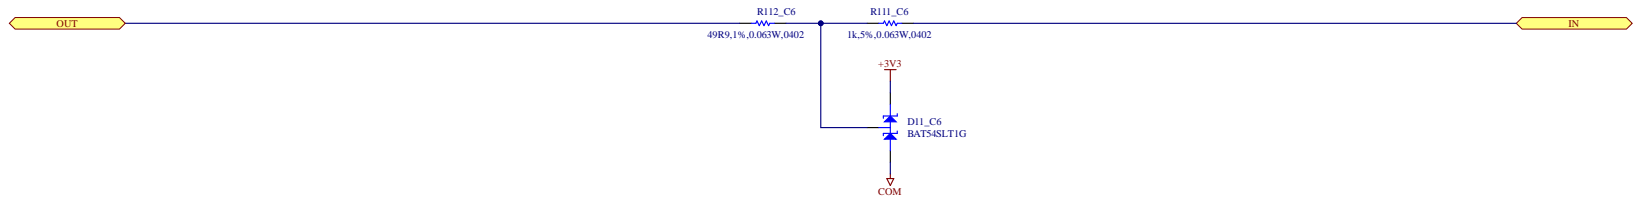
[picture p52: page 43]

Sheet Name: Clamp.SchDoc

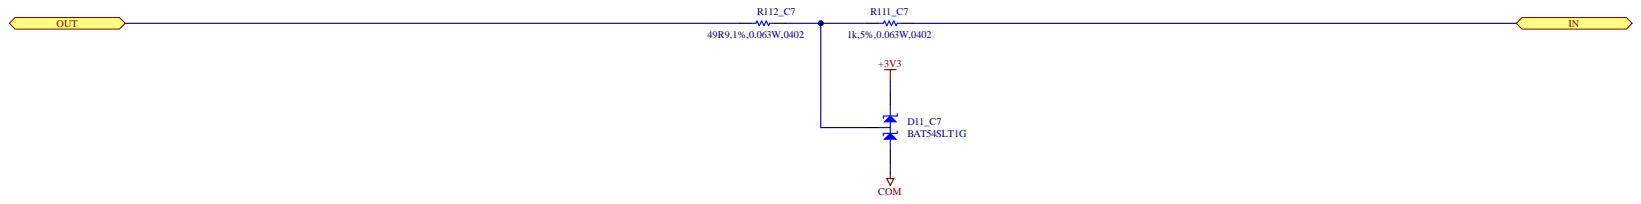
[picture p53: page 44]

Sheet Name: Clamp.SchDoc

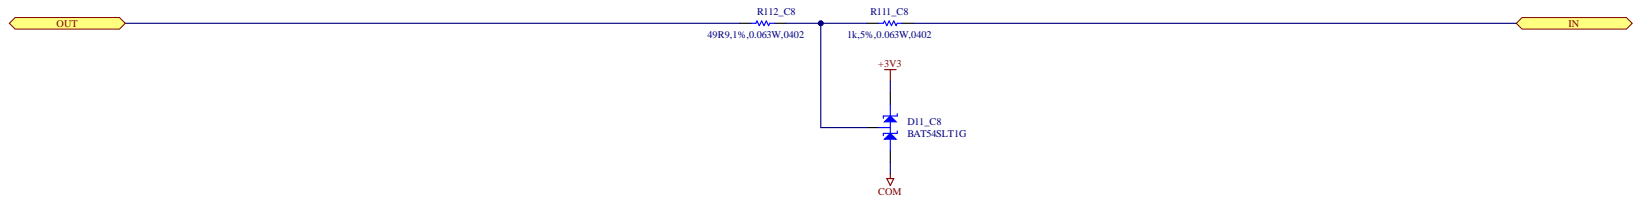
[picture p54: page 45]

Sheet Name: Clamp.SchDoc

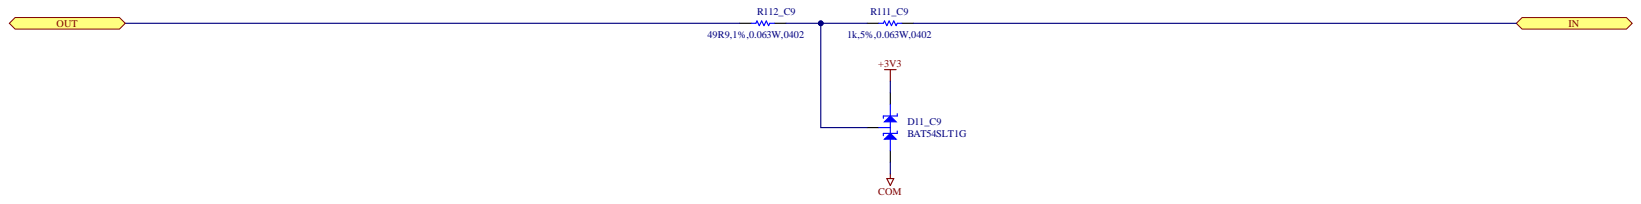
[picture p55: page 46]

Sheet Name: Clamp.SchDoc

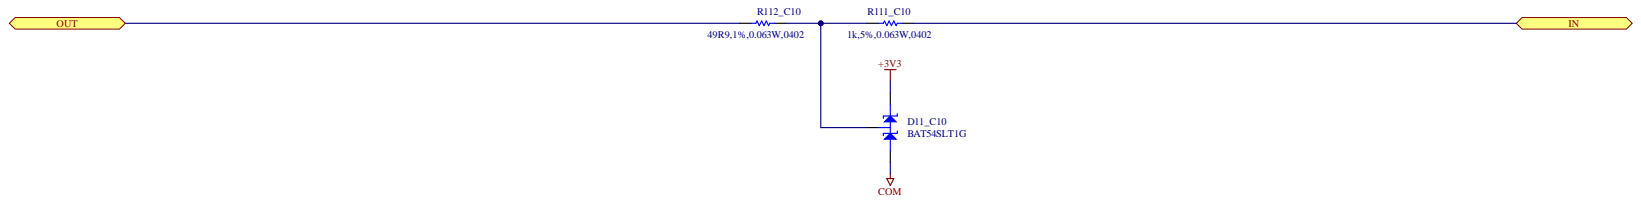
[picture p56: page 47]

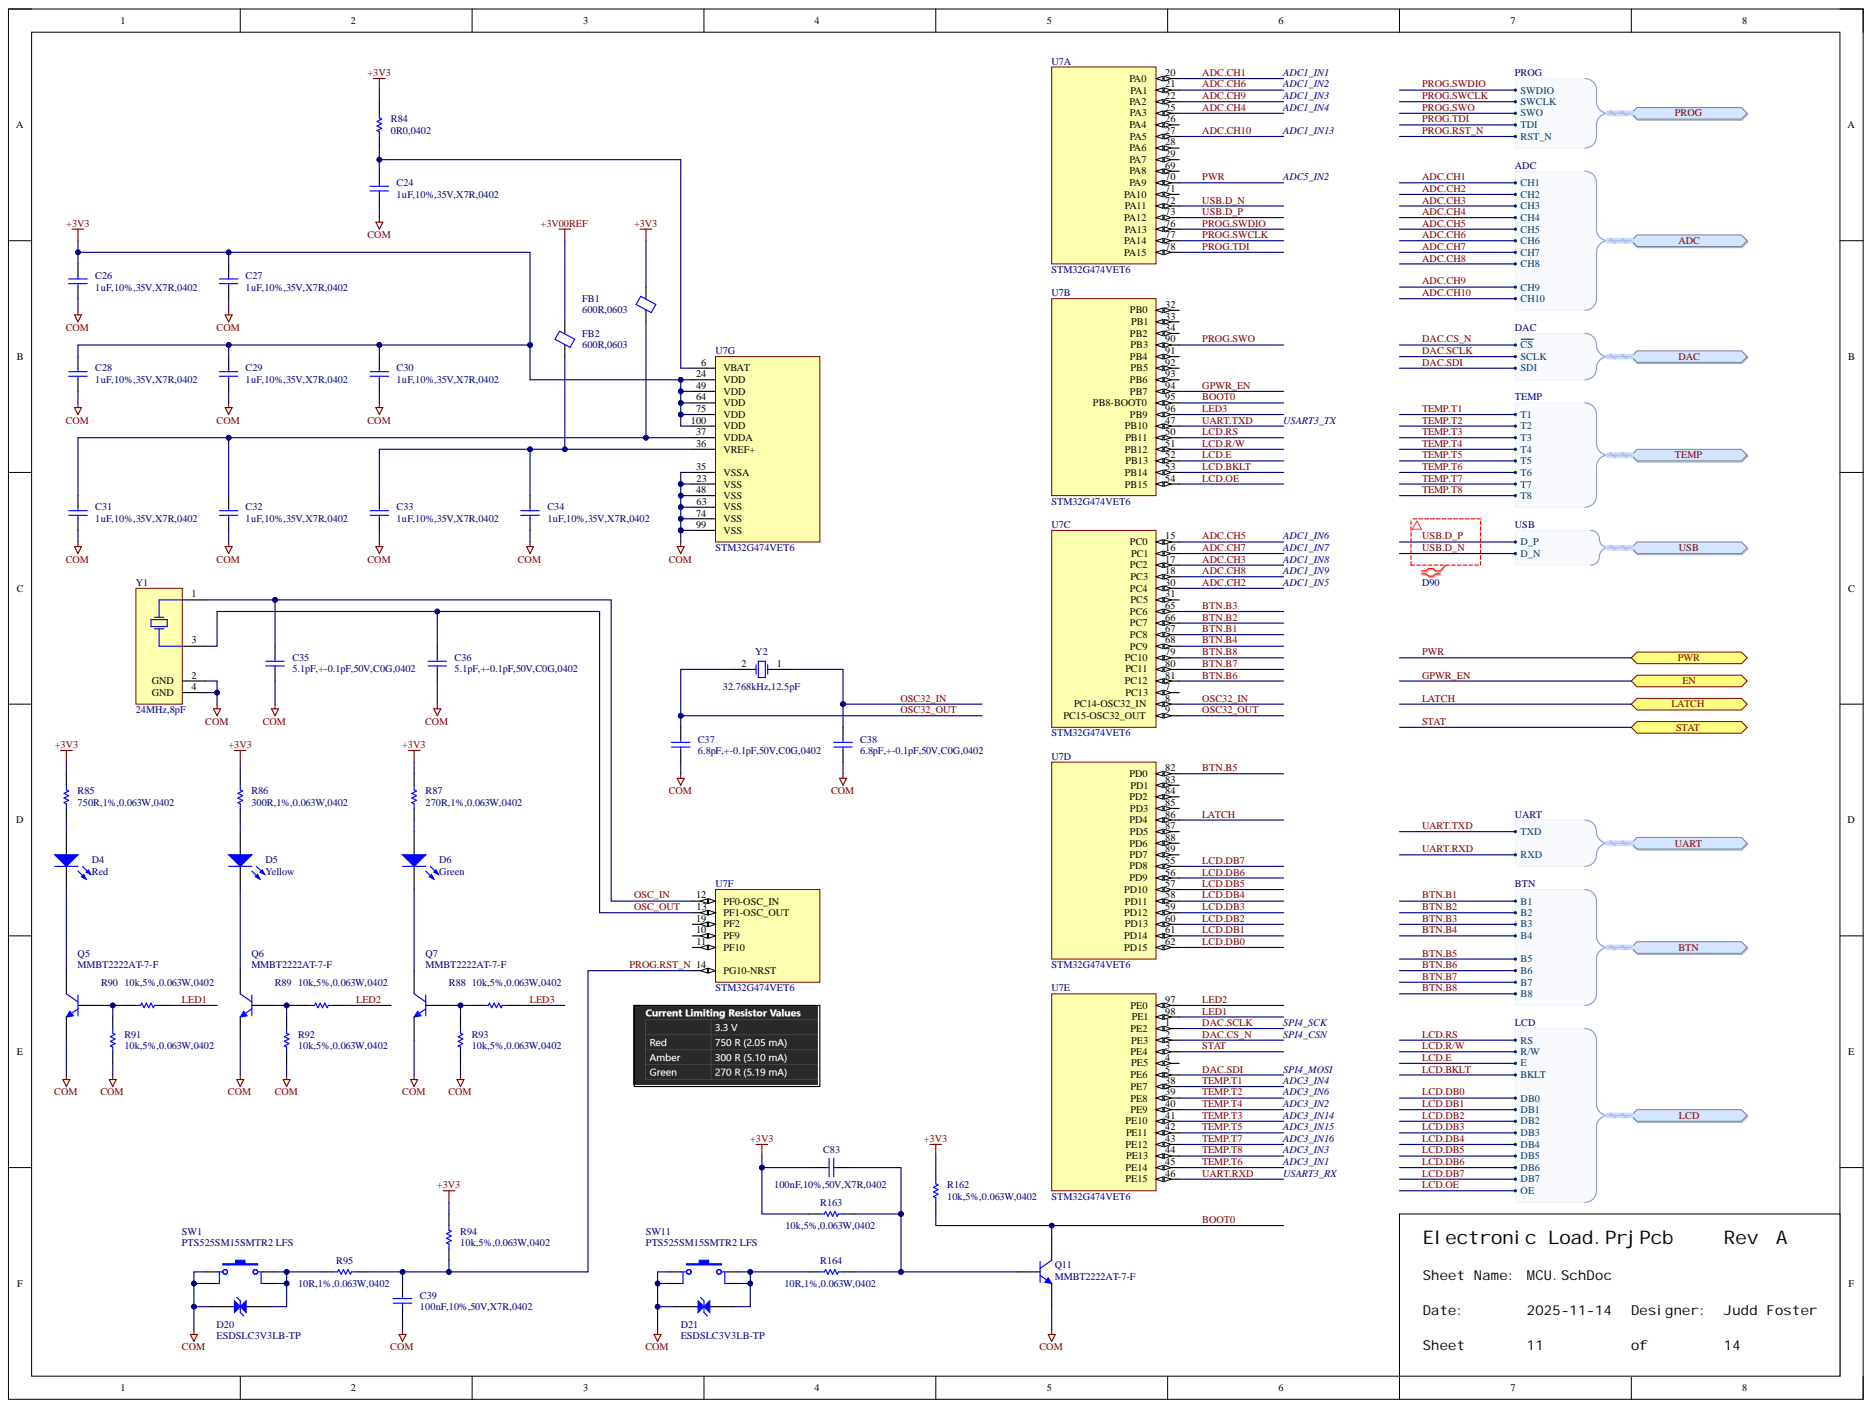
[picture p57: page 48]

VDD 24
VDD 49

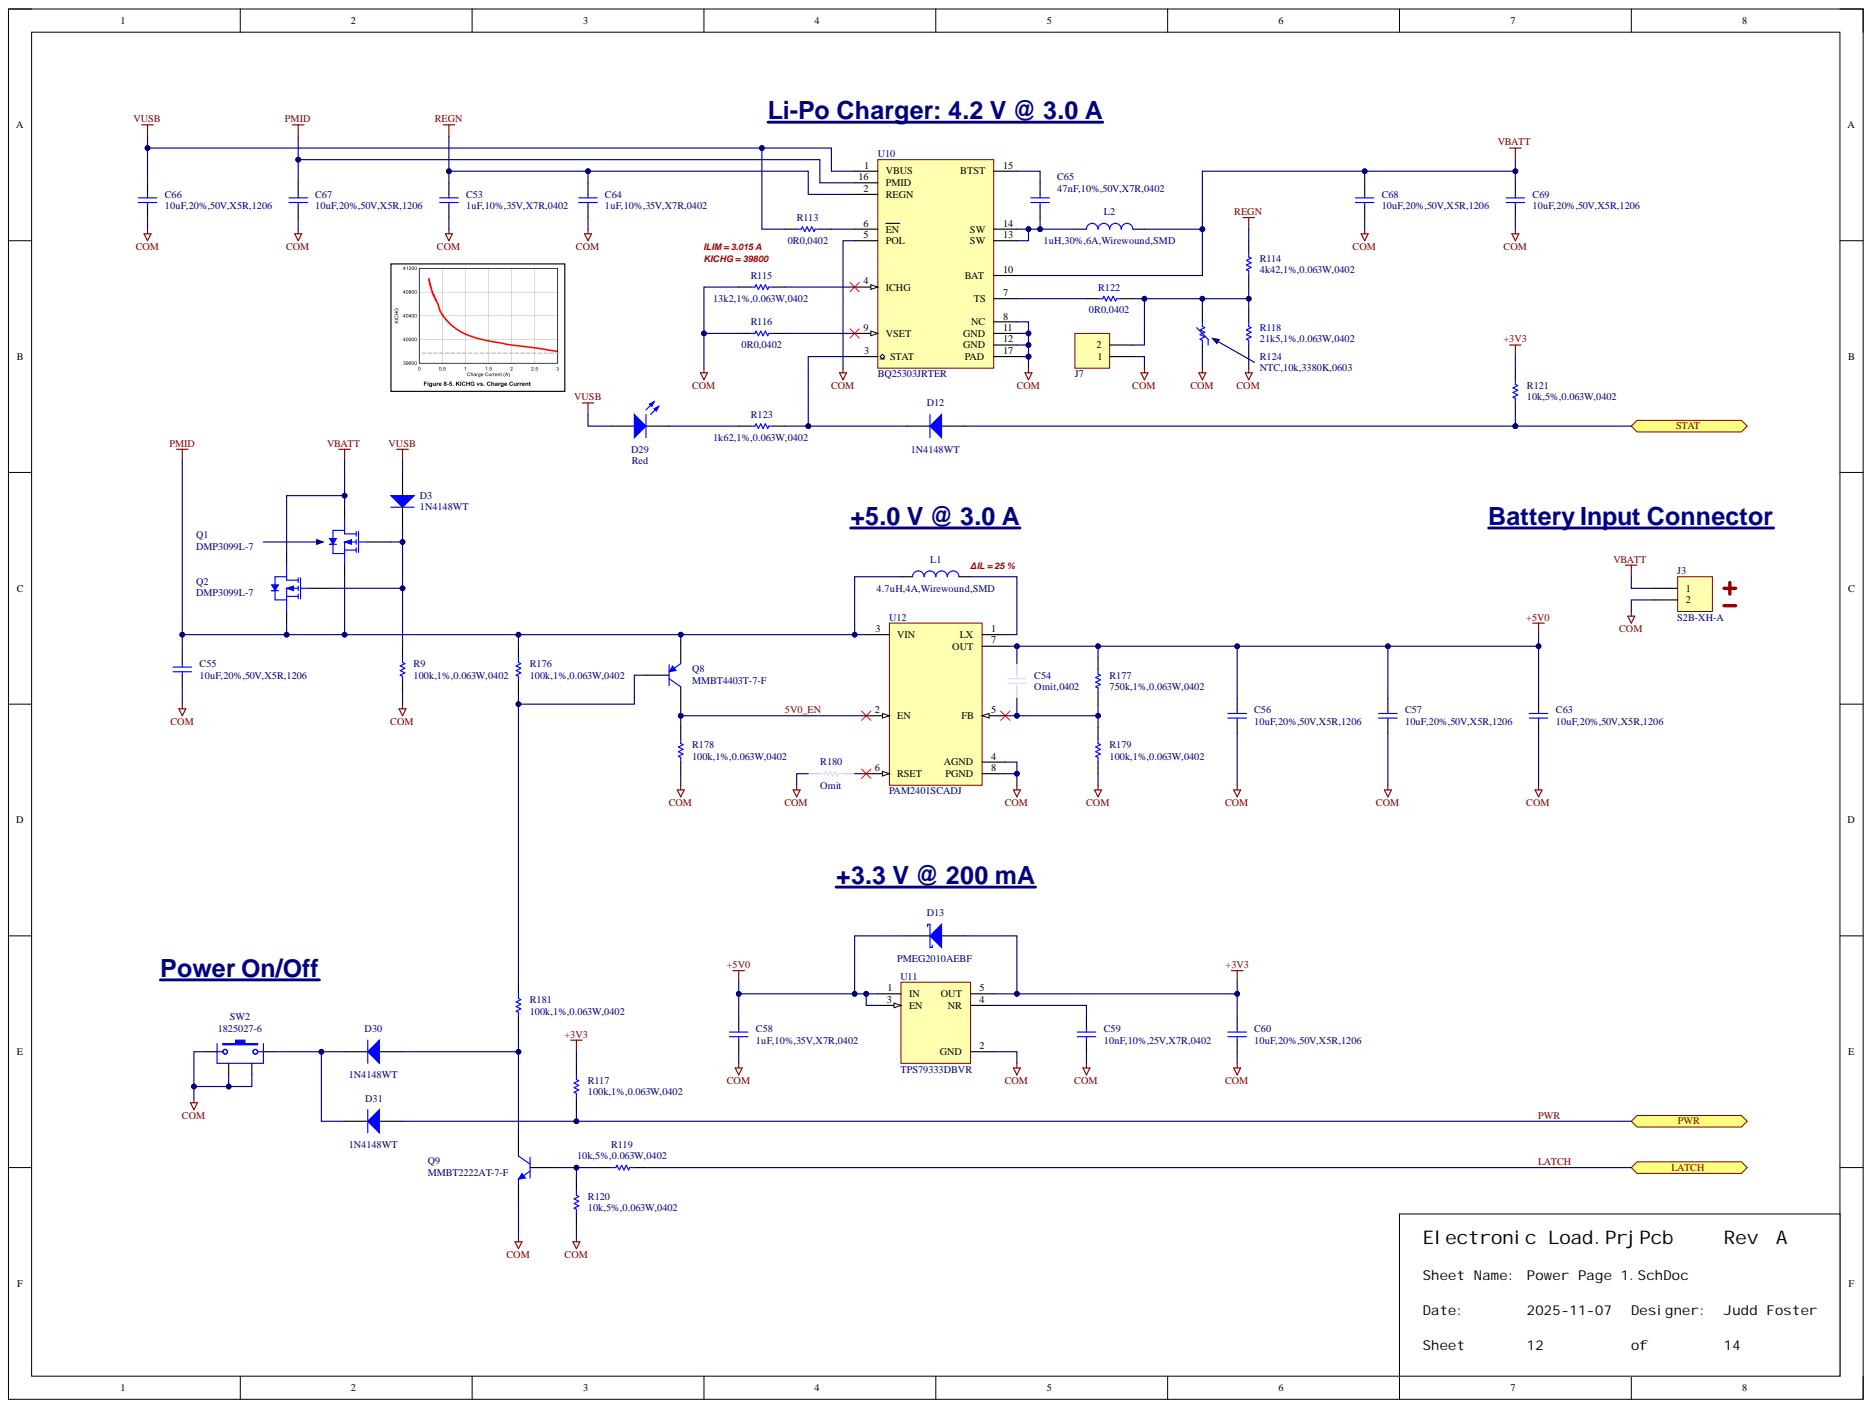
[picture p58: page 49]

REGN 2

POL 5 EN 6

Sheet Name: Power Page 1.SchDoc

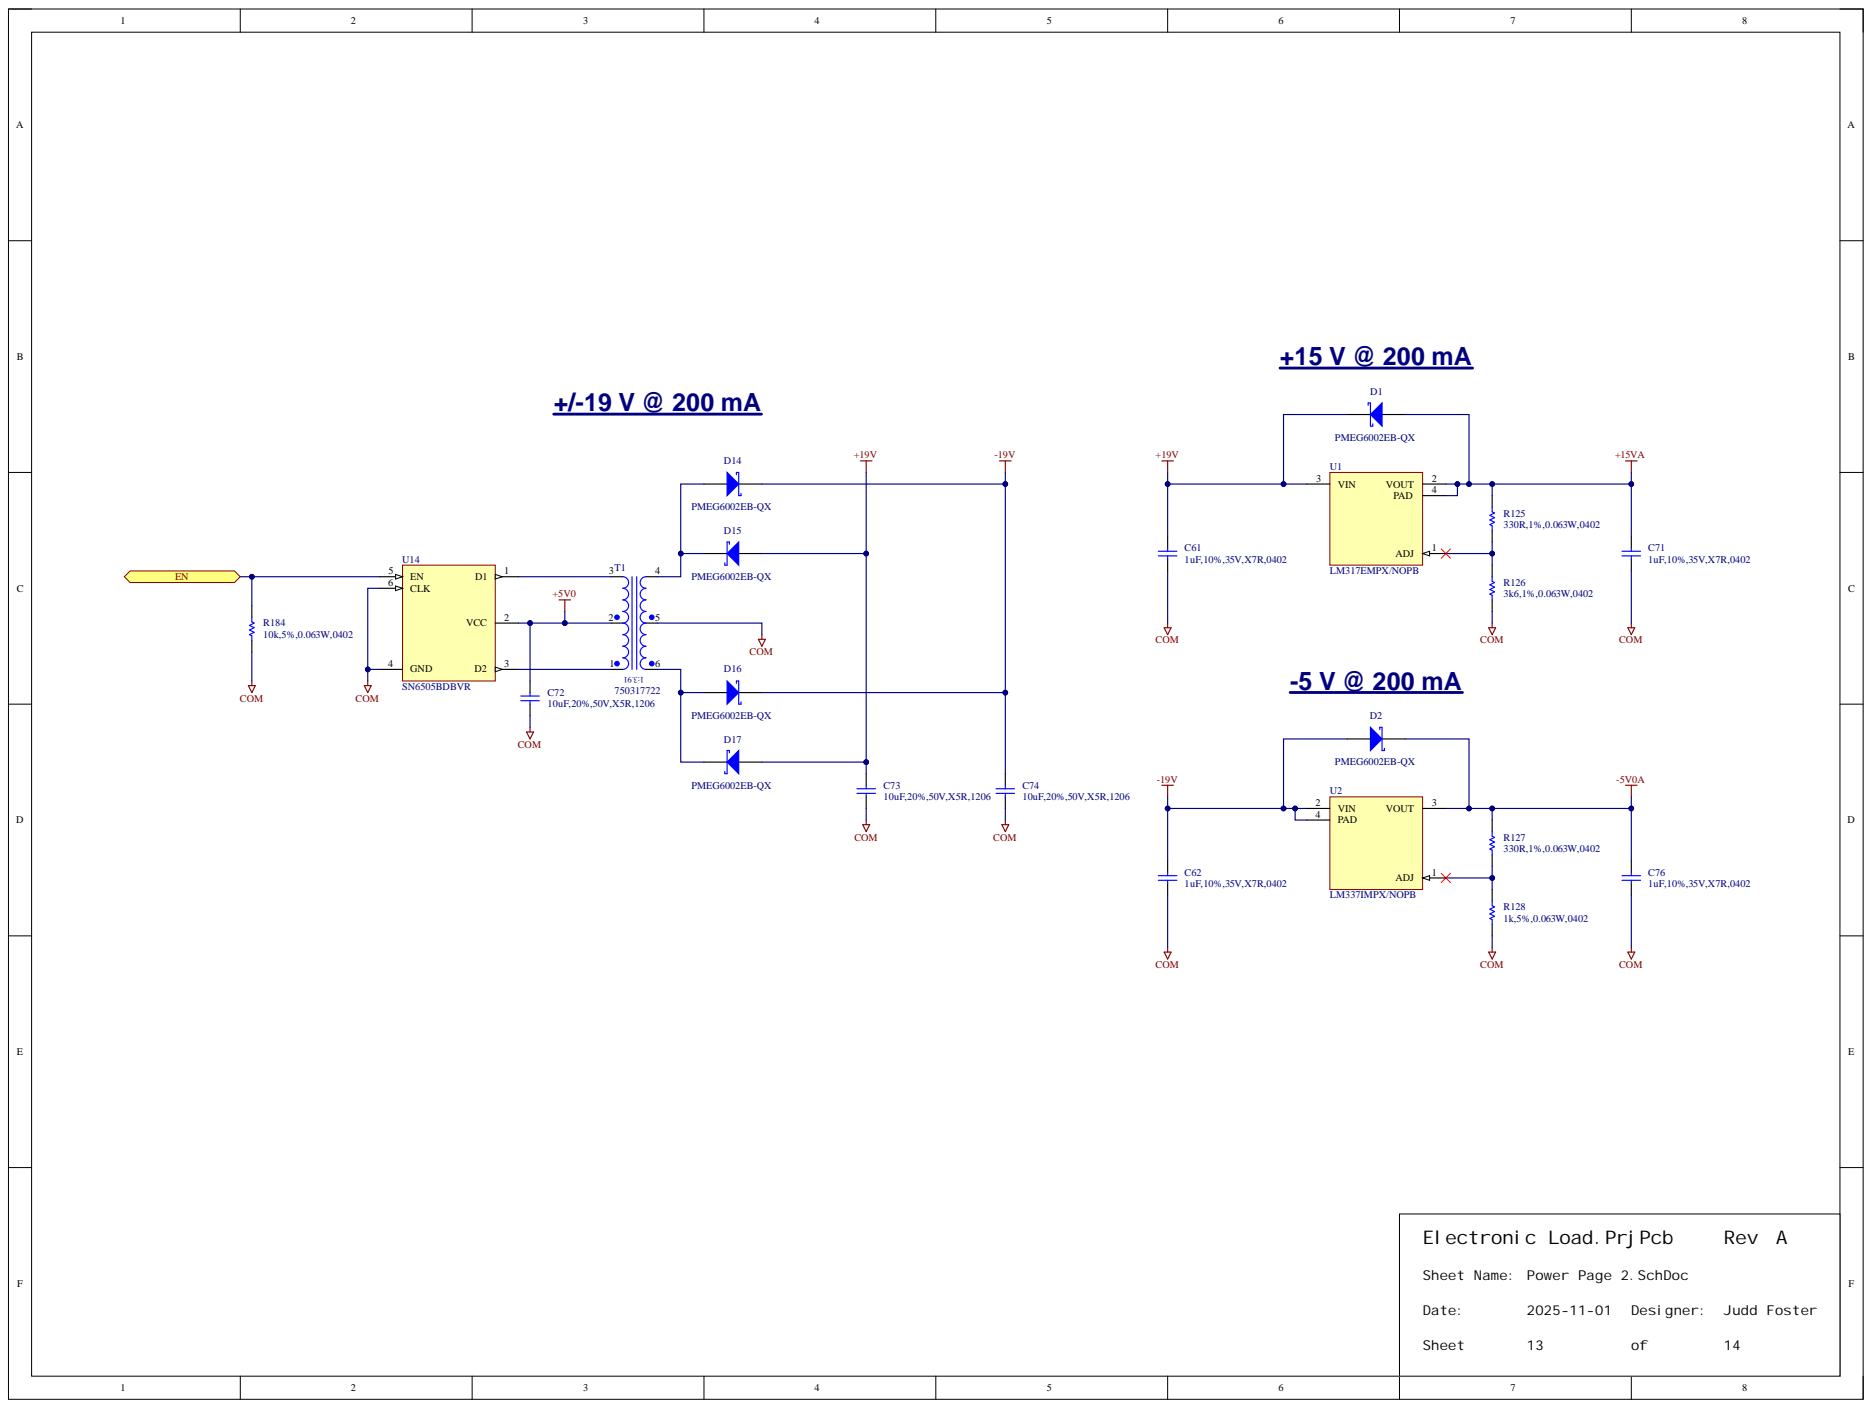
[picture p59: page 50]

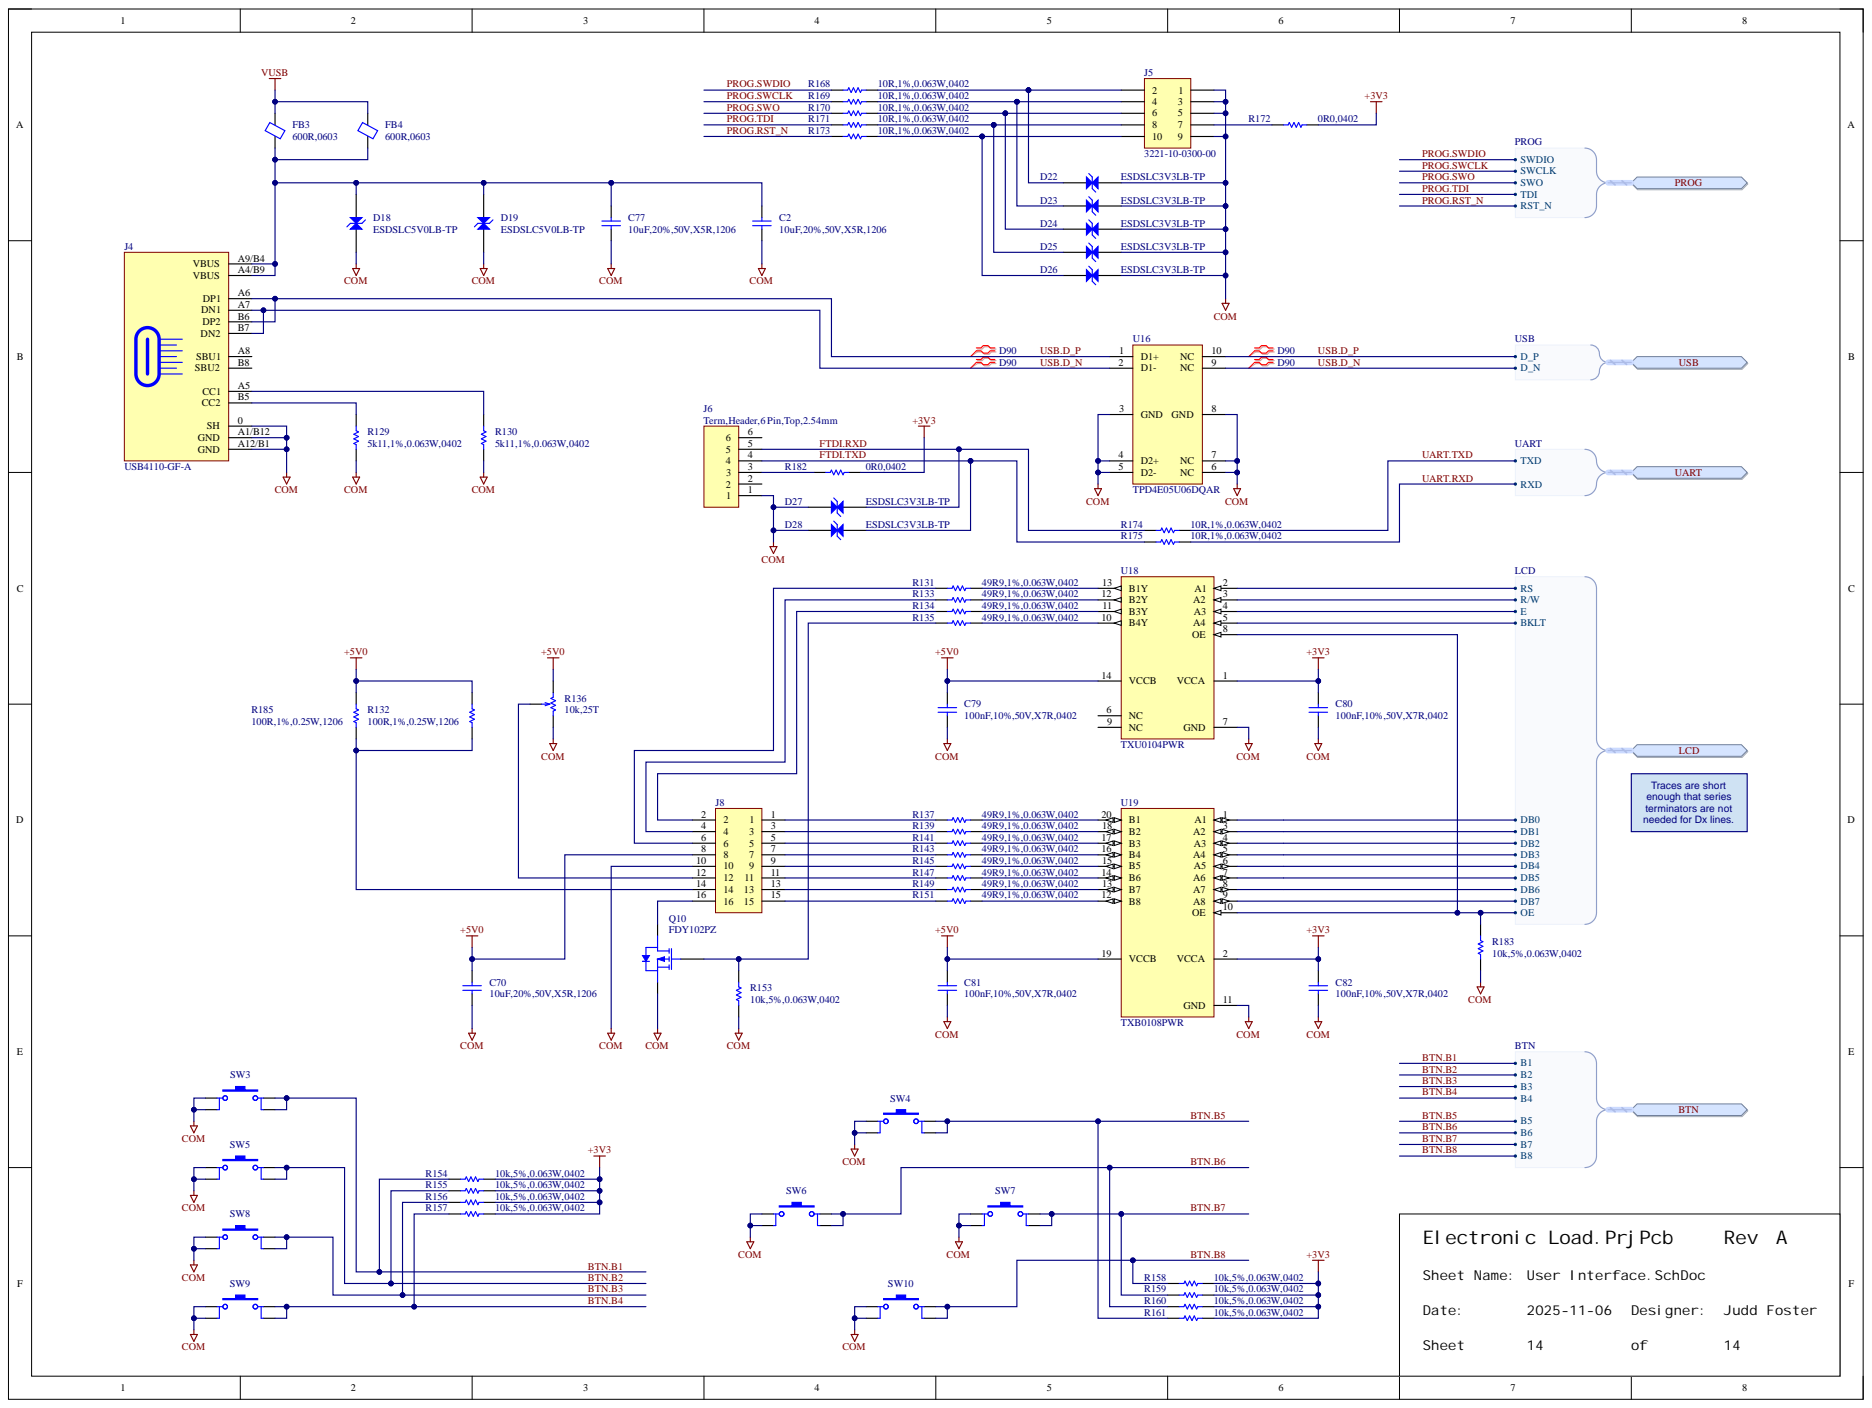
[picture p60: page 51]

Term,Header,6 Pin,Top,2.54mm

Traces are short
enough that series
terminators are not
needed for Dx lines.

BTN.B2
BTN.B3

Sheet Name: User Interface.SchDoc
