jFoster426/ElectronicLoad/Simulation/ConstantCurrentLoopGainPhaseMargin.asc

C1: cap; 1f
C2: cap; 1f
C3: cap; 1f
C4: cap; 10n
C5: cap; 10n
R2: res; 10k
R3: res; 1m
R4: res; 8k6
R5: res; 200
R8: res; 3.333m
R9: res; 200
R10: res; 10k
R11: res; 10k
R12: res; 10
R13: res; 8k6
U1: IXXK300N60B3
U2: LM358
U3: LM358
V1: voltage; 15
V2: voltage; -5
V3: voltage; 1
V5: voltage; ""; AC 1m
V6: voltage; 500
Named nets: 0, VCC, VEE, E, C, G, I2, I1
.ac dec 1k 1m 100Meg
