jFoster426/ElectronicLoad/Simulation/ConstantCurrentOutputFrequencyResponse.asc

C1: cap; 1p
C3: cap; 1p
C4: cap; 10n
C5: cap; 10n
R1: res; {X}
R2: res; 10k
R4: res; 1k
R5: res; 1k
R7: res; 10m
R8: res; 1
R9: res; 1k
R10: res; 1k
R11: res; 1k
R12: res; 300
R13: res; 1k
U1: IXXK300N60B3
U2: LM358
U3: LM358
V1: voltage; 15
V2: voltage; -5
V3: voltage; 1
V5: voltage; ""; AC 10
V6: voltage; 500
Named nets: 0, VCC, VEE, E, C, G, I1, I2
.ac dec 1k 1m 100Meg
.step param X list 100m 1 10
