jFoster426/ElectronicLoad/Simulation/ConstantCurrentRTN-COMPath.asc

C1: cap; 10n
C3: cap; 1p
C4: cap; 10n
C5: cap; 10n
R1: res; 6k81
R2: res; 10k
R4: res; 6k81
R5: res; {1k/6}
R6: res; 1m
R8: res; {0.02/6}
R9: res; {1k/6}
R10: res; 10k
R11: res; 10k
R12: res; 1m
U1: IXXK300N60B3
U2: LM358
U3: LM358
V1: voltage; 15
V2: voltage; -5
V3: voltage; PWL(0 0 1m 0 1.001m 1)
V6: voltage; 20
Named nets: 0, VCC, VEE, E, C, G
.tran 10m
