jFoster426/ElectronicLoad/Simulation/Draft1.asc

C1: cap; 1p
C3: cap; 1p
C4: cap; 10n
C5: cap; 10n
L1: ind2; 1µ
L2: ind2; 1m
R1: res; 9
R2: res; 10k
R3: res; 1
R4: res; 1k
R5: res; 1k
R6: res; 50
R7: res; 10m
R8: res; 1
R9: res; 1k
R10: res; 1k
R11: res; 1k
R12: res; {X}
R13: res; 1k
U1: IXXK300N60B3
U2: LM358
U3: LM358
V1: voltage; 15
V2: voltage; -5
V3: voltage; 1
V4: voltage; PWL(0 0 1m 0 {1m+1f} 500)
V5: voltage; ""; AC 1
V6: voltage; 500
Named nets: 0, VCC, VEE, E, C, G, A
.ac dec 1k 1m 100Meg
K1 L1 L2 1
.tran 10m
.step param X list 1m 100 300
