jFoster426/ElectronicLoad/Simulation/Draft2.asc

R1: res; 1k5
R2: res; 1k
R3: res; 1k
R4: res; 2k
R5: res; 1k
R6: res; 1k
R7: res; 1k
U1: UniversalOpAmp2
U2: UniversalOpAmp2
U3: UniversalOpAmp2
V1: voltage; 0
V2: voltage; 3
V3: voltage; -5
V4: voltage; 15
Named nets: +15, -5, +3, 0
.dc V1 0 5 0.01
