jFoster426/ElectronicLoad/Simulation/Power Button.asc

D1: diode; 1N4148
D2: diode; 1N4148
Q1: npn; 2N3904
Q2: pnp; 2N3906
R1: res; 100k
R2: res; 10k
R3: res; 100k
R4: res; 100k
R5: res; 100k
R6: res; 100k
S1: sw
S2: sw
V1: voltage; {Vs}
V2: voltage; PULSE(0 1 1 1n 1n 0.1 5 2)
V3: voltage; 3.3
Named nets: 0, 3V3, EN, PWR
.tran 10
.model SW SW(Vt=0.5 Vh=0 Ron=1m Roff=1T)
.step param Vs list 3.0 3.7 4.2
