jFoster426/ElectronicLoad/(list of files, drawings)

Other design files:
LCD PCB/LCD PCB.PcbDoc
LCD PCB/LCD PCB.PrjPcb
LCD PCB/LCD PCB.SchDoc
Main PCB/ADC MUX.SchDoc
Main PCB/Ballast Resistors.SchDoc
Main PCB/Clamp Top.SchDoc
Main PCB/Clamp.SchDoc
Main PCB/Control Loop Top.SchDoc
Main PCB/Control Loop.SchDoc
Main PCB/Current Shunts.SchDoc
Main PCB/DAC.SchDoc
Main PCB/Electronic Load Top.SchDoc
Main PCB/Electronic Load.PrjPcb
Main PCB/Gate Level Translator.SchDoc
Main PCB/Gate MUX.SchDoc
Main PCB/IGBT Current Control.SchDoc
Main PCB/Isolation.SchDoc
Main PCB/MCU.SchDoc
Main PCB/MUX.SchDoc
Main PCB/Pass Transistor.SchDoc
Main PCB/Power Page 1.SchDoc
Main PCB/Power Page 2.SchDoc
Main PCB/Signal Conditioning.SchDoc
Main PCB/User Interface.SchDoc
Main PCB/Voltage Sense.SchDoc
