jFoster426/ElectronicLoad/Firmware/src/main.c

#include <stdlib.h>
#include <stdio.h>
#include <string.h>

#include "stm32g4xx.h"

#include "adc.h"
#include "clocks.h"
#include "dac.h"
#include "delay.h"
#include "gpio.h"
#include "lcd.h"
#include "systick.h"
#include "uart.h"
#include "ui.h"

const uint16_t SINE_LUT[1024] =
{
    0x8000, 0x80c9, 0x8192, 0x825b, 0x8324, 0x83ee, 0x84b7, 0x8580,
    0x8649, 0x8712, 0x87db, 0x88a4, 0x896c, 0x8a35, 0x8afe, 0x8bc6,
    0x8c8e, 0x8d57, 0x8e1f, 0x8ee7, 0x8fae, 0x9076, 0x913e, 0x9205,
    0x92cc, 0x9393, 0x945a, 0x9521, 0x95e7, 0x96ad, 0x9773, 0x9839,
    0x98fe, 0x99c4, 0x9a89, 0x9b4d, 0x9c12, 0x9cd6, 0x9d9a, 0x9e5e,
    0x9f21, 0x9fe4, 0xa0a7, 0xa169, 0xa22b, 0xa2ed, 0xa3af, 0xa470,
    0xa530, 0xa5f1, 0xa6b1, 0xa770, 0xa830, 0xa8ef, 0xa9ad, 0xaa6b,
    0xab29, 0xabe6, 0xaca3, 0xad5f, 0xae1b, 0xaed7, 0xaf92, 0xb04d,
    0xb107, 0xb1c0, 0xb27a, 0xb332, 0xb3ea, 0xb4a2, 0xb559, 0xb610,
    0xb6c6, 0xb77c, 0xb831, 0xb8e5, 0xb999, 0xba4d, 0xbb00, 0xbbb2,
    0xbc64, 0xbd15, 0xbdc6, 0xbe76, 0xbf25, 0xbfd4, 0xc082, 0xc12f,
    0xc1dc, 0xc288, 0xc334, 0xc3df, 0xc489, 0xc533, 0xc5dc, 0xc684,
    0xc72c, 0xc7d3, 0xc879, 0xc91f, 0xc9c3, 0xca67, 0xcb0b, 0xcbae,
    0xcc4f, 0xccf1, 0xcd91, 0xce31, 0xced0, 0xcf6e, 0xd00b, 0xd0a8,
    0xd144, 0xd1df, 0xd279, 0xd313, 0xd3ac, 0xd443, 0xd4db, 0xd571,
    0xd606, 0xd69b, 0xd72f, 0xd7c2, 0xd854, 0xd8e5, 0xd975, 0xda05,
    0xda93, 0xdb21, 0xdbae, 0xdc3a, 0xdcc5, 0xdd4f, 0xddd9, 0xde61,
    0xdee9, 0xdf6f, 0xdff5, 0xe07a, 0xe0fd, 0xe180, 0xe202, 0xe283,
    0xe303, 0xe382, 0xe400, 0xe47d, 0xe4fa, 0xe575, 0xe5ef, 0xe668,
    0xe6e0, 0xe758, 0xe7ce, 0xe843, 0xe8b7, 0xe92b, 0xe99d, 0xea0e,
    0xea7e, 0xeaed, 0xeb5b, 0xebc8, 0xec34, 0xec9f, 0xed09, 0xed72,
    0xedda, 0xee41, 0xeea7, 0xef0b, 0xef6f, 0xefd1, 0xf033, 0xf093,
    0xf0f2, 0xf150, 0xf1ad, 0xf209, 0xf264, 0xf2be, 0xf316, 0xf36e,
    0xf3c4, 0xf41a, 0xf46e, 0xf4c1, 0xf513, 0xf564, 0xf5b3, 0xf602,
    0xf64f, 0xf69b, 0xf6e6, 0xf730, 0xf779, 0xf7c1, 0xf807, 0xf84d,
    0xf891, 0xf8d4, 0xf916, 0xf956, 0xf996, 0xf9d4, 0xfa11, 0xfa4d,
    0xfa88, 0xfac1, 0xfafa, 0xfb31, 0xfb67, 0xfb9c, 0xfbd0, 0xfc02,
    0xfc33, 0xfc63, 0xfc92, 0xfcc0, 0xfcec, 0xfd17, 0xfd42, 0xfd6a,
    0xfd92, 0xfdb8, 0xfdde, 0xfe01, 0xfe24, 0xfe46, 0xfe66, 0xfe85,
    0xfea3, 0xfec0, 0xfedb, 0xfef5, 0xff0e, 0xff26, 0xff3c, 0xff52,
    0xff66, 0xff79, 0xff8a, 0xff9b, 0xffaa, 0xffb8, 0xffc4, 0xffd0,
    0xffda, 0xffe3, 0xffeb, 0xfff1, 0xfff6, 0xfffa, 0xfffd, 0xffff,
    0xffff, 0xfffe, 0xfffc, 0xfff8, 0xfff4, 0xffee, 0xffe7, 0xffdf,
    0xffd5, 0xffca, 0xffbe, 0xffb1, 0xffa2, 0xff93, 0xff82, 0xff6f,
    0xff5c, 0xff47, 0xff31, 0xff1a, 0xff02, 0xfee8, 0xfece, 0xfeb1,
    0xfe94, 0xfe76, 0xfe56, 0xfe35, 0xfe13, 0xfdf0, 0xfdcb, 0xfda5,
    0xfd7e, 0xfd56, 0xfd2d, 0xfd02, 0xfcd6, 0xfca9, 0xfc7b, 0xfc4b,
    0xfc1b, 0xfbe9, 0xfbb6, 0xfb82, 0xfb4c, 0xfb16, 0xfade, 0xfaa5,
    0xfa6b, 0xfa2f, 0xf9f3, 0xf9b5, 0xf976, 0xf936, 0xf8f5, 0xf8b2,
    0xf86f, 0xf82a, 0xf7e4, 0xf79d, 0xf755, 0xf70c, 0xf6c1, 0xf675,
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
};

int main(void)
{
    clocks_init();
    systick_init();
    gpio_init();
    gpio_set_output(GPIOE, 1); // LED1 (red)
    uart_init(9600);
    dac_init();
    lcd_init();
    adc_init();
    ui_init();

    gpio_set_output(GPIOD, 4); // LATCH
    gpio_set(GPIOD, 4);        // Enable power latch

    gpio_set_output(GPIOB, 7);  // GPWR_EN
    gpio_set(GPIOB, 7);         // Enable +15V/-5V gate power supplies

    strcpy((char *)lcd_l1, "   Hello,  World!   ");
    strcpy((char *)lcd_l2, "  Electronic  Load  ");
    strcpy((char *)lcd_l3, "    Judd  Foster    ");
    strcpy((char *)lcd_l4, "Firmware: 14 MR 2026");
    lcd_write_frame();

    delay_ms(500);

    float current_limit_amps = 1.0;
    float current_limit_amps_per_fet = current_limit_amps / 8.0; // 8 paralleled FETs
    const float DAC_VOLTS_PER_AMP = 0.1362;
    const float DAC_FULL_SCALE = 65535.0;
    const float DAC_VREF = 3.0;
    float dac_val = (current_limit_amps_per_fet * DAC_VOLTS_PER_AMP) * (DAC_FULL_SCALE / DAC_VREF);
    dac_write((uint16_t)(dac_val));

    strcpy(lcd_l3, "                    ");
    strcpy(lcd_l4, "                    ");

    while (1)
    {
        ui_poll();
        // printf("Hello, World!\n");

        // gpio_set(GPIOE, 1);
        // delay_ms(10);        
        // gpio_reset(GPIOE, 1);
        // delay_ms(100);

        // sprintf((char *)lcd_l1, "%04X %04X %04X %04X ", adc1_dma_buffer[0],
        //     adc1_dma_buffer[1], adc1_dma_buffer[2], adc1_dma_buffer[3]);

        // sprintf((char *)lcd_l2, "%04X %04X %04X %04X ", adc1_dma_buffer[4],
        //     adc1_dma_buffer[5], adc1_dma_buffer[6], adc1_dma_buffer[7]);

        // lcd_write_frame();
        
        // for (uint16_t i = 0; i < 1024; i++)
        // {
        //     dac_write(SINE_LUT[i]);
        // }
    }
    return 0;
}
