jFoster426/ElectronicLoad/(commit log)

2026-02-09 update mechanical assembly, finish LCD PCB
    [Button Spacer.SLDPRT, Buttons.SLDPRT, Heatsink.SLDPRT, LCD PCB.PcbDoc, LCD PCB.PrjPcb, LCD PCB.SLDPRT, LCD PCB.SchDoc, LCD PCB.x_t]
2026-02-16 generated outputs and ordered LCD PCB, update mechanical dwgs
    [LCD PCB.PrjPcb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]
2026-03-02 updated mech drawings
    [Buttons.SLDPRT, Current Sense Tolerance Stack.xlsx, Insulator.SLDPRT, Top Cover.SLDPRT, Transistor Clamp.SLDPRT]
2026-03-04 add fasteners to mechanical
    [ECSA-P51-M3-L16.sldprt, ECSA-P51-M3-L20.sldprt, EDLW-S1-M2.5-L12.sldprt, EDLW-S1-M2.5-L6.sldprt, EMLA-S1W-B1L1-M2.5.sldprt, Insulator 2.SLDPRT, LCD Spacer.SLDPRT, Top Cover.SLDPRT]
2026-03-06 created generic datasheets folder, ready to test LCD frame buffer code
2026-03-09 start adc code
2026-03-11 add schematic pdf
2026-03-11 working on adc code
2026-03-12 added dma to adc code, need to test it
2026-03-14 got LCD code working, working on testing ADC code
2026-03-17 made lcd code faster, dma adc is working now
2026-03-18 update solidmodel with clearance for LCD pins and enlarged countersink holes for LCD board
    [Bracket.SLDPRT, Top Cover.SLDPRT]
2026-03-23 starting buttons code
2026-04-09 update buttons -> ui, working on hold/press logic
2026-04-13 working on button debouncing logic
